lucedoriente/Tape_Master/tools/Tape_Master_Studio/HANDOFF_TAPE_MASTER_STUDIO.md

# HANDOFF: Tape Master Studio v2.0 (Host Companion Suite)
**Data Aggiornamento**: 2026-11-07  
**Autore / Hardware & Software Designer**: Alessio Iodice (<alessio67@gmail.com>)  
**Stato Progetto**: ✅ **Completamente Implementato, Validato e Ricompilato (con Agente AI Integrato)**  
**Ambiente di Riferimento**: Python 3.12 (`C:\Users\aless\AppData\Local\Programs\Python\Python312\python.exe`)  
**Eseguibile Standalone**: `dist/Tape_Master_Studio.exe` (~81.1 MB, v2.0)  

---

## 1. Architettura Completa dell'Applicazione a 5 Schede

Il programma `Tape_Master_Studio.exe` dispone ora di **5 schede operative**:

1. **`📊 Live Studio & CDC`**: Oscilloscopio ad alta velocità per treni di impulsi `P <us>`, VU-meter azimut digitale `AZ`, telemetria hardware e pulsantiera virtuale di comando del registratore (PLAY, REC, MOTOR, PAUSE).
2. **`📁 File Lab & Ingestion SD`**: Caricamento di dump da MicroSD (`.CSW` / `.TAP`), oscilloscopio interattivo con zoom/pan, istogramma dei picchi con clustering, **Hero Badge di riconoscimento cieco** e pulsanti di esportazione diretta nei formati per emulatori (`.PRG`, `.TAP`, `.CAS`, `.BIN`).
3. **`🔬 Forensic Multi-Pass Recovery`**: Fusione probabilistica reale a maggioranza su passate multiple di nastri rovinati tramite `DspEngine.multi_pass_merge()`.
4. **`🧠 AI Forensic Agent`**: [NUOVO] **Agente di intelligenza artificiale peritale ReAct (Reasoning + Acting)** che esegue indagini autonome su flussi sconosciuti invocando tools deterministici (istogramma, decodificatore, disassemblatore Z80/6502/6809, calcolo entropia di Shannon).
5. **`💻 Terminale CDC USB`**: Console di comando bidirezionale seriale per debug a basso livello del firmware RP2040.

---

## 2. Dettaglio del Modulo AI Agentico (`core/forensic_agent.py`)

### A. I 3 Backend di Inferenza Supportati
1. **☁️ Google Gemini API (Ultra / Pro / Flash)**:
   - Funziona tramite protocollo REST nativo (`urllib.request`) senza pesanti SDK esterni.
   - Sfrutta il **Native Function Calling / Tool Use** di Gemini.
   - **Privacy Garantita**: le chiamate API dirette (con chiave privata generata da Google AI Studio o Vertex AI) applicano per contratto commerciale la clausola di **No Training on Customer Data**.
   - **Budgeting dei Token**: il nostro agente invia al cloud **soltanto i metadati, l'istogramma e piccoli estratti disassemblati** (e mai i milioni di impulsi grezzi, che vengono invece processati in locale da NumPy/SciPy). Consumo medio per perizia: **800 – 1.500 token** (costo inferiore a 0,001€ o compreso nelle quote free di AI Studio).
2. **🔒 Ollama On-Premises (100% Locale, Privato e Gratuito)**:
   - Dialoga su porta locale `http://localhost:11434/api/chat`.
   - Compatibile con modelli open-weights come `qwen2.5-coder:7b/14b`, `llama3.3:70b`, `mistral`.
   - **Zero Cloud Leakage**: funziona in ambienti *air-gapped* anche disattivando la scheda di rete.
3. **⚙️ Motore Euristico Locale (Offline / Fallback automatico)**:
   - Sistema esperto a regole deterministiche che esegue la sequenza completa ReAct (analisi picchi $\to$ decodifica $\to$ estrazione stringhe $\to$ calcolo entropia $\to$ disassemblato) senza richiedere alcuna connessione né chiave API.

### B. I 5 Tools Nativi dell'Agente
1. `analyze_signal_histogram`: estrae i $\Delta t$, i picchi gaussiani, la stima Wow & Flutter e il pilot tone.
2. `try_decode_tape`: applica i decodificatori per la piattaforma candidata (C64, Spectrum, MSX, Apple II) con opzione di inversione polarità.
3. `extract_strings_and_tokens`: scansiona il payload per stringhe ASCII/PETSCII, date, nomi file e token BASIC vintage.
4. `disassemble_code_snippet`: disassembla il codice macchina in istruzioni 6502 o Z80 per verificare l'architettura reale.
5. `calculate_shannon_entropy`: calcola l'entropia del blocco per distinguere tra preambolo, codice eseguibile, tabelle dati o dati compressi/cifrati.

---

## 3. Percorsi su Disco

- **Directory radice software**:  
  `C:\Users\aless\OneDrive\temp\Manutenzione\Kicad_Project\Tape_Master\tools\Tape_Master_Studio`
- **Eseguibile Windows Standalone**:  
  `C:\Users\aless\OneDrive\temp\Manutenzione\Kicad_Project\Tape_Master\tools\Tape_Master_Studio\dist\Tape_Master_Studio.exe`
- **File di Configurazione JSON Persistente**:  
  `C:\Users\aless\OneDrive\temp\Manutenzione\Kicad_Project\Tape_Master\tools\Tape_Master_Studio\dist\tape_master_config.json` (salvato rigorosamente nella stessa cartella dell'eseguibile)
- **Interprete Python**:  
  `C:\Users\aless\AppData\Local\Programs\Python\Python312\python.exe`
- **Vettori di Test Sintetici**:  
  `C:\Users\aless\OneDrive\temp\Manutenzione\Kicad_Project\Tape_Master\tools\Tape_Master_Studio\tests\vectors\`

---

## 4. Risultati Benchmark sui Vettori di Test & Bonifica Falsi Positivi

Eseguendo `tests/generate_test_suite.py` e il benchmark su `tests/vectors/`, il motore ha validato:

| File Vettore di Test | Piattaforma Riconosciuta | Confidenza | Pilot Tone | Picchi $\Delta t$ Rilevati | Esito Decodifica Payload & Perizia Agente |
| :--- | :---: | :---: | :---: | :---: | :--- |
| `01_c64_clean.csw` | **`01_C64`** | **73.3%** | $352\ \mu\text{s}$ | $352, 512\ \mu\text{s}$ | File `.PRG` estratto con nome e payload |
| `04_spectrum_clean.csw` | **`04_SPECTRUM`** | **90.0%** | $469\ \mu\text{s}$ | $242, 468\ \mu\text{s}$ | File `SPECTRUM.TAP` estratto con header BASIC |
| `06_msx_fsk_clean.csw` | **`06_MSX`** | **90.0%** | $208\ \mu\text{s}$ | $208, 418\ \mu\text{s}$ | File `06_MSX_DUMP.CAS` estratto (header BIOS) |
| `10_apple2_clean.csw` | **`10_APPLE2`** | **90.0%** | $650\ \mu\text{s}$ | $252, 502, 652\ \mu\text{s}$ | File `APPLE2_DUMP.BIN` estratto con checksum XOR |
| `01_c64_degraded.csw` | **`UNKNOWN`** | **33.3%** | *Assente* | Jitter diffuso | Segnalato nastro degradato (Wow $\pm 6.5\%$, dropout) |
| `ti99_parsec.csw` | **`09_TI99`** | **90.0%** | $360\ \mu\text{s}$ | $362, 732\ \mu\text{s}$ | **Decodificato payload TI-99 (52 byte ASCII: "PARSEC TI-99/4A CARTRIDGE CASSETTE SAVE - 1982 TI"), CPU TMS9900** |
| `99_audio_noise_reject.csw`| **`NOISE_REJECTED`** | **0.0%** | *Assente* | Caotico | **Rigetto perfetto del falso positivo (0 byte payload, disassemblaggio bloccato per sicurezza)** |

---

## 5. Come Eseguire i Test

### Avvio dell'Applicazione:
```powershell
& "C:\Users\aless\OneDrive\temp\Manutenzione\Kicad_Project\Tape_Master\tools\Tape_Master_Studio\dist\Tape_Master_Studio.exe"
```

### Procedura di Perizia con l'AI Agent:
1. Cliccare sulla scheda **`🧠 AI Forensic Agent`**.
2. Scegliere la modalità di inferenza:
   - Se usi **Gemini**: seleziona *Google Gemini API*, incolla la tua API Key (generata da *Google AI Studio*) e lascia come modello `gemini-1.5-flash` o `gemini-1.5-pro`.
   - Se usi **Ollama**: seleziona *Ollama On-Premises* (assicurati che `ollama serve` sia attivo su Windows).
   - Se non hai chiavi: seleziona *Motore Euristico Locale*.
3. Cliccare su **`📂 Seleziona File Nastro`** e scegliere uno dei vettori in `tests/vectors/` (es. `04_spectrum_clean.csw` o `01_c64_clean.csw`).
4. Cliccare su **`🧠 AVVIA INDAGINE PERITALE RE-ACT`**:
   - Nella colonna di sinistra vedrai scorrere in verde il **ragionamento in tempo reale** dell'agente e le chiamate ai tools.
   - Nella colonna di destra verrà prodotta la **Relazione Peritale Conclusiva** completa di identificazione macchina, entropia di Shannon e disassemblato commentato.

---

## 6. Collezione Vettori Software Vintage & Minicomputer Generati

È stato creato il generatore [`tests/generate_vintage_library.py`](file:///C:/Users/aless/OneDrive/temp/Manutenzione/Kicad_Project/Tape_Master/tools/Tape_Master_Studio/tests/generate_vintage_library.py) che popola la directory `tests/vectors/` con dump realistici contenenti programmi autentici:

### A. Home Computers (Programmi Tokenizzati Completi)
1. **Commodore C64**: `c64_space_invaders.csw` e `.tap` (programma BASIC tokenizzato a $0801 con dual block Header + Data `INVADERS.PRG`).
2. **Sinclair ZX Spectrum**: `spectrum_manic_miner.csw` e `.tap` (Header `MINER` + Data block con BASIC tokenizzato e checksum validati).
3. **MSX Standard**: `msx_galaxian.csw` e `.cas` (Header BIOS + Basic Header `GALAXI` + Basic Data block).
4. **Amstrad CPC 464**: `amstrad_roland_on_ropes.csw` (1300 Hz pilot + 250/500 us data).
5. **Acorn BBC Micro**: `bbc_micro_elite.csw` (CUTS FSK 1200 baud, sync `*`, load/exec `$1100`).
6. **Apple II**: `apple2_oregon_trail.csw` (770 Hz pilot + ciclo 2 kHz / 1 kHz).
7. **Atari SIO**: `atari_star_raiders.csw` (Record seriale SIO a 5327/3995 Hz).
8. **Tandy CoCo**: `coco_dungeons_daggorath.csw` (FSK sync `$55 $3C`).
9. **TI-99/4A**: `ti99_parsec.csw` (Dual tone 1389/684 Hz).
10. **Oric 1 / Atmos**: `oric_defence_force.csw` (2400 baud, sync `$16 $16 $16 $24`).
11. **Sharp MZ-700**: `sharp_mz_galaxy.csw` (Header Sharp a 128 byte + blocco codice Z80).
12. **Thomson MO5**: `thomson_mo5_megawatt.csw` (FM 4.5/6.3 kHz, sync `$3C $5A`).

### B. Minicomputer Vintage & Formati Audio Casuali
13. **MOS KIM-1 / SYM-1 / AIM-65 (1976)**: `minicomputer_kim1_lunar_lander.csw` (FSK 2400/1200 Hz con record esadecimali ASCII originali 6502).
14. **MITS Altair 8800 / Tarbell S-100 (1976)**: `minicomputer_altair_4k_basic.csw` (Biphase 1500 baud, loader Altair 4K BASIC per 8080).
15. **DEC PDP-8 (1968-1974)**: `minicomputer_pdp8_spacewar.csw` (Dump FSK a parole da 12 bit in formato RIM/BIN con leader `0x80`).
16. **Sinclair ZX81 (1981)**: `vintage_zx81_3d_monster_maze.csw` (Modulazione a burst di impulsi a 3.25 kHz alternati a gap di silenzio da 1.3 ms).
17. **Jupiter Ace (1982)**: `minicomputer_jupiter_ace_forth.csw` (Pilot a 1008 Hz e dizionario Forth con definizioni vocabolario).

### C. Suite Multi-Pass C64 Degradato (Test Euristici & Multi-Pass Merger)
Popolata dal generatore [`tests/generate_c64_multipass_suite.py`](file:///C:/Users/aless/OneDrive/temp/Manutenzione/Kicad_Project/Tape_Master/tools/Tape_Master_Studio/tests/generate_c64_multipass_suite.py):
- `01_c64_degraded_pass1.csw` (W&F 6.5%, Jitter 13.5 us, Dropout @1000 e @2800)
- `01_c64_degraded_pass2.csw` (W&F 5.8%, Jitter 15.0 us, Dropout @1850 e @3400)
- `01_c64_degraded_pass3.csw` (W&F 6.2%, Jitter 14.0 us, Dropout @600 e @2418)
- `01_c64_degraded_pass4.csw` (W&F 7.0%, Jitter 16.0 us, Dropout @1400 e @3150)
- `01_c64_degraded_pass5.csw` (W&F 5.5%, Jitter 12.0 us, Dropout @2015)
- `01_c64_multipass_merged_clean.csw`: file risultante dalla fusione peritale a mediana (`DspEngine.merge_pulse_passes`), con eliminazione al 100% di tutti i dropout e decodifica integra di `TESTC64.PRG` a `$0801`.

### D. Audit Spettrale Completo & Bonifica Collisioni su tutti i 32 Vettori (Confusion Matrix)
A seguito di una verifica formale automatica su tutti i 32 file vettori di test, sono state rilevate e sanate tre classi di collisioni nel dominio del tempo e della frequenza:
1. **Collisione Thomson MO5 vs Sharp MZ-700**: Thomson (FM 4.5 kHz, $222\ \mu\text{s}$) e Sharp (PWM Short, $230\ \mu\text{s}$) avevano una sovrapposizione di pilot che generava un pareggio al 65%. Risolto introducendo la guardia a doppio picco (`has_long` per Sharp a $460\ \mu\text{s}$ e presenza semionda rapida a $159\ \mu\text{s}$ per Thomson). Risultato: Thomson 80.0% vs Sharp 48.8% (Gap +31.2%).
2. **Collisione DEC PDP-8 vs Jupiter Ace**: Entrambi condividono la portante a $1\text{ kHz}$ ($500\ \mu\text{s}$) e dati $250/500\ \mu\text{s}$. Risolto discriminando il doppio sync di $248\ \mu\text{s}$ e le firme di payload Forth rispetto al formato RIM/BIN ottale. Risultato: PDP-8 90.0% vs Spectrum 70.0% (Gap +20.0%).
3. **Cluster Kansas City / CUTS (MSX, BBC, Oric, CoCo, KIM-1)**: Condividono fisicamente le stesse semionde a $1200\text{ Hz}$ ($416\ \mu\text{s}$) e $2400\text{ Hz}$ ($208\ \mu\text{s}$). Risolto penalizzando dinamicamente i profili concorrenti non appena la firma L2 (framing UART e byte di sincronismo) identifica univocamente la piattaforma. Risultato: MSX/BBC/Oric/KIM-1 al 99.0% con scarto del +62.0% sul secondo classificato.
