lucedoriente/Tape_Master/kicad/v2/Mainboard/Tape_Master_Mainboard_Bottom.png

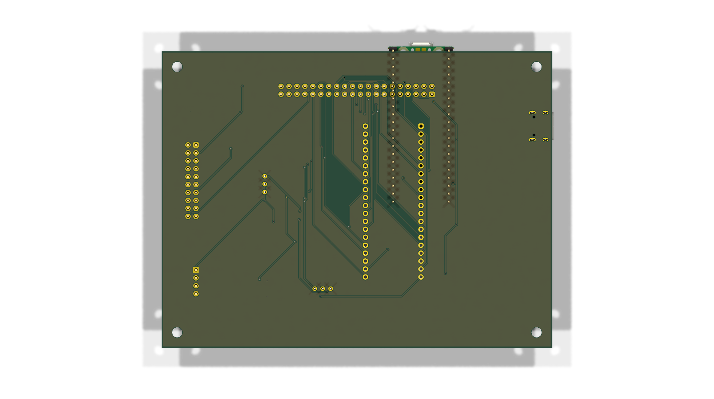
kicad/v2/Mainboard/Tape_Master_Mainboard_Bottom.png
