lucedoriente/Tape_Master/kicad/v2/Mainboard/Tape_Master_Mainboard_Top.png

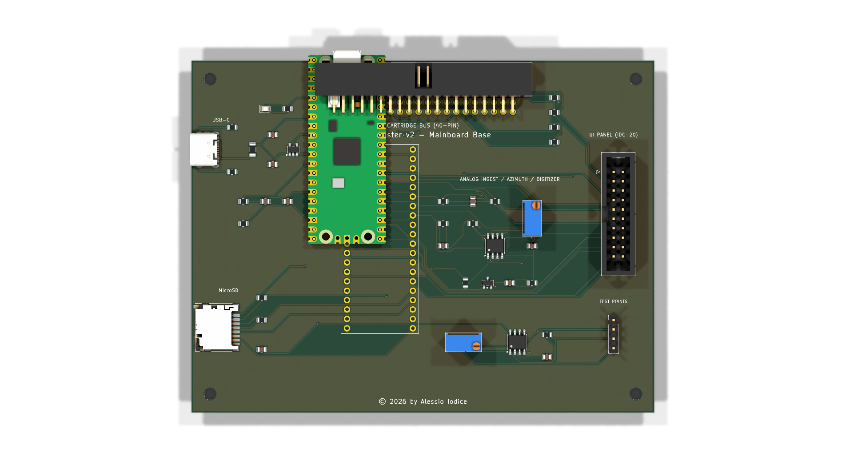
kicad/v2/Mainboard/Tape_Master_Mainboard_Top.png
