lucedoriente/Tape_Master/kicad/v2/UI_Panel/Tape_Master_UI_Panel_Bottom.png

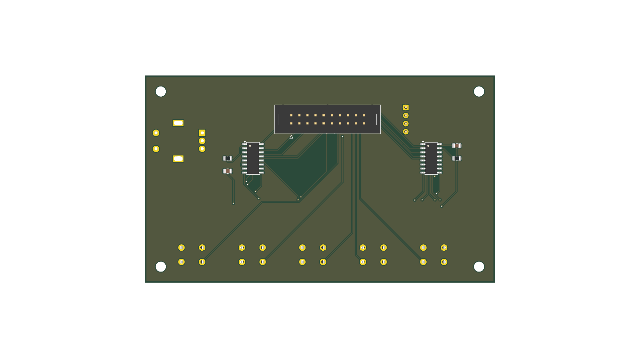
kicad/v2/UI_Panel/Tape_Master_UI_Panel_Bottom.png
