lucedoriente/Tape_Master/kicad/v2/UI_Panel/Tape_Master_UI_Panel_Top.png

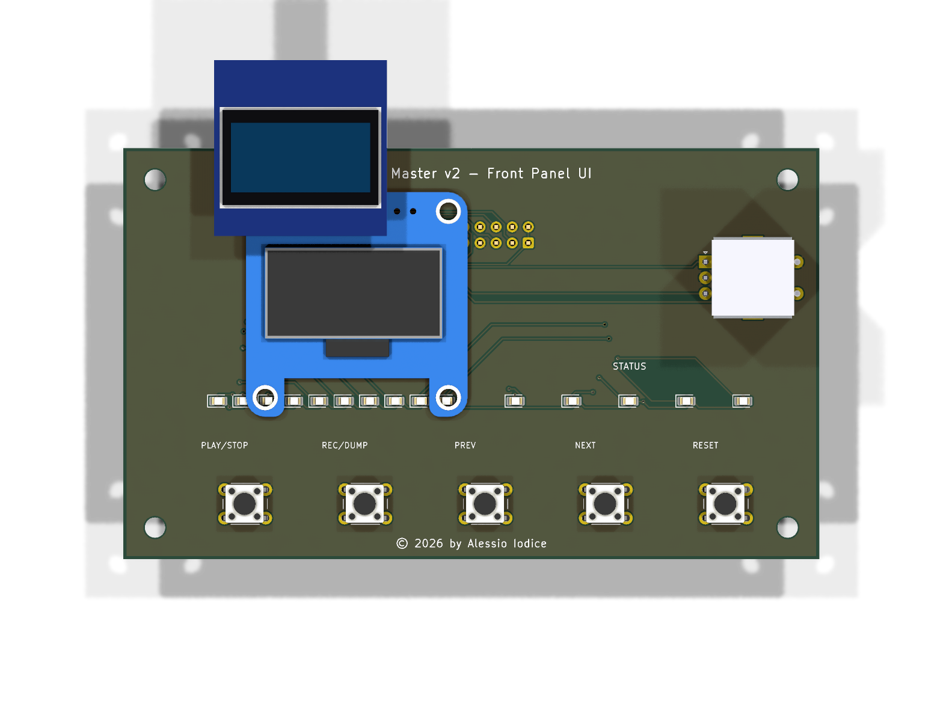
kicad/v2/UI_Panel/Tape_Master_UI_Panel_Top.png
