lucedoriente/Tape_Master/kicad/v1/bom.csv

Refs | Value | Footprint | Qty | DNP
C1 | 100uF_Polymer | Capacitor_Tantalum_SMD:CP_EIA-3528-21_Kemet-B | 1
C2 | 10uF | Capacitor_SMD:C_0805_2012Metric | 1
C3 | 100nF | Capacitor_SMD:C_0805_2012Metric | 1
C4 | 1uF | Capacitor_SMD:C_0805_2012Metric | 1
C5 | 2.2uF | Capacitor_SMD:C_0805_2012Metric | 1
C6 | 100nF | Capacitor_SMD:C_0805_2012Metric | 1
C7 | 47uF | Capacitor_Tantalum_SMD:CP_EIA-3528-21_Kemet-B | 1
C8 | 100nF | Capacitor_SMD:C_0805_2012Metric | 1
C9 | 10uF | Capacitor_SMD:C_0805_2012Metric | 1
C10 | 100nF | Capacitor_SMD:C_0805_2012Metric | 1
C11 | 100nF | Capacitor_SMD:C_0805_2012Metric | 1
C12 | 100nF | Capacitor_SMD:C_0805_2012Metric | 1
C13 | 100nF | Capacitor_SMD:C_0805_2012Metric | 1
C15 | 1uF | Capacitor_SMD:C_0805_2012Metric | 1
C16 | 47pF | Capacitor_SMD:C_0805_2012Metric | 1
C17 | 47nF | Capacitor_SMD:C_0805_2012Metric | 1
C18 | 47nF | Capacitor_SMD:C_0805_2012Metric | 1
C19 | 1.5nF | Capacitor_SMD:C_0805_2012Metric | 1
C20 | 680pF | Capacitor_SMD:C_0805_2012Metric | 1
C21 | 1uF | Capacitor_SMD:C_0805_2012Metric | 1
C22 | 100nF | Capacitor_SMD:C_0805_2012Metric | 1
C23 | 100nF | Capacitor_SMD:C_0805_2012Metric | 1
C24 | 100nF | Capacitor_SMD:C_0805_2012Metric | 1
C25 | 100nF | Capacitor_SMD:C_0805_2012Metric | 1
C26 | 100nF | Capacitor_SMD:C_0805_2012Metric | 1
C27 | 100nF | Capacitor_SMD:C_0805_2012Metric | 1
C28 | 10nF | Capacitor_SMD:C_0805_2012Metric | 1
C29 | 10nF | Capacitor_SMD:C_0805_2012Metric | 1
C30 | 10uF | Capacitor_SMD:C_0805_2012Metric | 1
C31 | 100nF | Capacitor_SMD:C_0805_2012Metric | 1
C32 | 100nF | Capacitor_SMD:C_0805_2012Metric | 1
D1 | PMEG3010AET | Package_TO_SOT_SMD:SOT-23 | 1
D2 | LED_READ_Green | LED_SMD:LED_0805_2012Metric | 1
D3 | LED_WRITE_Red | LED_SMD:LED_0805_2012Metric | 1
D4 | LED_MOTOR_Yellow | LED_SMD:LED_0805_2012Metric | 1
D5 | LED_SIGNAL_Blue | LED_SMD:LED_0805_2012Metric | 1
D6 | PWR 3.3V | LED_SMD:LED_0805_2012Metric | 1
D7 | BAT54S | Package_TO_SOT_SMD:SOT-23 | 1
D8 | BAT54 | Package_TO_SOT_SMD:SOT-23 | 1
D9 | BAT54 | Package_TO_SOT_SMD:SOT-23 | 1
D10 | VU_Green | LED_SMD:LED_0805_2012Metric | 1
D11 | VU_Green | LED_SMD:LED_0805_2012Metric | 1
D12 | VU_Green | LED_SMD:LED_0805_2012Metric | 1
D13 | VU_Green | LED_SMD:LED_0805_2012Metric | 1
D14 | VU_Green | LED_SMD:LED_0805_2012Metric | 1
D15 | VU_Green | LED_SMD:LED_0805_2012Metric | 1
D16 | VU_Green | LED_SMD:LED_0805_2012Metric | 1
D17 | VU_Green | LED_SMD:LED_0805_2012Metric | 1
D18 | VU_Yellow | LED_SMD:LED_0805_2012Metric | 1
D19 | VU_Red | LED_SMD:LED_0805_2012Metric | 1
DISP1 | OLED_0.96_I2C | Connector_PinHeader_2.54mm:PinHeader_1x04_P2.54mm_Vertical | 1
F1 | PTC 1A | Fuse:Fuse_1206_3216Metric | 1
H1 | MountingHole | MountingHole:MountingHole_3.2mm_M3 | 1
H2 | MountingHole | MountingHole:MountingHole_3.2mm_M3 | 1
H3 | MountingHole | MountingHole:MountingHole_3.2mm_M3 | 1
H4 | MountingHole | MountingHole:MountingHole_3.2mm_M3 | 1
J1 | USB-C | Connector_USB:USB_C_Receptacle_GCT_USB4105-xx-A_16P_TopMnt_Horizontal | 1
J2 | MicroSD | Connector_Card:microSD_HC_Hirose_DM3D-SF | 1
J3 | HEAD_IN / LINE_IN | Connector_Audio:Jack_3.5mm_CUI_SJ-3523-SMT_Horizontal | 1
J4 | C2N_EDGE | Tape-Master:C2N_Edge_Connector | 1
J5 | C2N_HEADER | Connector_PinHeader_2.54mm:PinHeader_1x06_P2.54mm_Vertical | 1
J6 | AUDIO_OUT | Connector_Audio:Jack_3.5mm_CUI_SJ-3523-SMT_Horizontal | 1
J7 | REMOTE_2.5mm | Connector_Audio:Jack_3.5mm_CUI_SJ-3523-SMT_Horizontal | 1
JP1 | C2N_PWR_SEL | Connector_PinHeader_2.54mm:PinHeader_1x02_P2.54mm_Vertical | 1
JP2 | HEAD_BOOST | Connector_PinHeader_2.54mm:PinHeader_1x02_P2.54mm_Vertical | 1
Q1 | 2N7002 | Package_TO_SOT_SMD:SOT-23 | 1
Q2 | 2N3904 | Package_TO_SOT_SMD:SOT-23 | 1
R1 | 5.1k | Resistor_SMD:R_0805_2012Metric | 1
R2 | 5.1k | Resistor_SMD:R_0805_2012Metric | 1
R3 | 10k 0.1% | Resistor_SMD:R_0805_2012Metric | 1
R4 | 10k 0.1% | Resistor_SMD:R_0805_2012Metric | 1
R5 | 10k | Resistor_SMD:R_0805_2012Metric | 1
R6 | 10k | Resistor_SMD:R_0805_2012Metric | 1
R7 | 10k | Resistor_SMD:R_0805_2012Metric | 1
R8 | 10k | Resistor_SMD:R_0805_2012Metric | 1
R9 | 4.7k | Resistor_SMD:R_0805_2012Metric | 1
R10 | 4.7k | Resistor_SMD:R_0805_2012Metric | 1
R11 | 10k | Resistor_SMD:R_0805_2012Metric | 1
R12 | 10k | Resistor_SMD:R_0805_2012Metric | 1
R13 | 10k | Resistor_SMD:R_0805_2012Metric | 1
R14 | 10k | Resistor_SMD:R_0805_2012Metric | 1
R15 | 10k | Resistor_SMD:R_0805_2012Metric | 1
R16 | 10k | Resistor_SMD:R_0805_2012Metric | 1
R17 | 10k | Resistor_SMD:R_0805_2012Metric | 1
R18 | 1.2k | Resistor_SMD:R_0805_2012Metric | 1
R20 | 1.2k | Resistor_SMD:R_0805_2012Metric | 1
R23 | 1k | Resistor_SMD:R_0805_2012Metric | 1
R24 | 100k | Resistor_SMD:R_0805_2012Metric | 1
R25 | 1k | Resistor_SMD:R_0805_2012Metric | 1
R26 | 9.1k | Resistor_SMD:R_0805_2012Metric | 1
R27 | 8.2k 1% | Resistor_SMD:R_0805_2012Metric | 1
R28 | 16k 1% | Resistor_SMD:R_0805_2012Metric | 1
R29 | 12k 1% | Resistor_SMD:R_0805_2012Metric | 1
R30 | 12k 1% | Resistor_SMD:R_0805_2012Metric | 1
R31 | 100k | Resistor_SMD:R_0805_2012Metric | 1
R32 | 10k 1% | Resistor_SMD:R_0805_2012Metric | 1
R33 | 18k 1% | Resistor_SMD:R_0805_2012Metric | 1
R34 | 10k | Resistor_SMD:R_0805_2012Metric | 1
R35 | 470k | Resistor_SMD:R_0805_2012Metric | 1
R36 | 2.2k | Resistor_SMD:R_0805_2012Metric | 1
R37 | 1k | Resistor_SMD:R_0805_2012Metric | 1
R38 | 100k | Resistor_SMD:R_0805_2012Metric | 1
R39 | 10k | Resistor_SMD:R_0805_2012Metric | 1
R40 | 10k | Resistor_SMD:R_0805_2012Metric | 1
R41 | 10k | Resistor_SMD:R_0805_2012Metric | 1
R42 | 1k | Resistor_SMD:R_0805_2012Metric | 1
R43 | 2k | Resistor_SMD:R_0805_2012Metric | 1
R44 | 1k | Resistor_SMD:R_0805_2012Metric | 1
R45 | 1k | Resistor_SMD:R_0805_2012Metric | 1
R46 | 10k | Resistor_SMD:R_0805_2012Metric | 1
R47 | 1k | Resistor_SMD:R_0805_2012Metric | 1
R48 | 330 | Resistor_SMD:R_0805_2012Metric | 1
RV1 | 100k TRIM | Potentiometer_THT:Potentiometer_Bourns_3296W_Vertical | 1
RV3 | 50k HYST | Potentiometer_THT:Potentiometer_Bourns_3296W_Vertical | 1
SW1 | Rotary_Encoder | Rotary_Encoder:RotaryEncoder_Alps_EC11E-Switch_Vertical_H20mm | 1
SW2 | BTN_PLAY_STOP | Button_Switch_THT:SW_PUSH_6mm | 1
SW3 | BTN_REC_DUMP | Button_Switch_THT:SW_PUSH_6mm | 1
SW4 | BTN_REW_PREV | Button_Switch_THT:SW_PUSH_6mm | 1
SW5 | BTN_FFWD_NEXT | Button_Switch_THT:SW_PUSH_6mm | 1
SW6 | RESET | Button_Switch_THT:SW_PUSH_6mm | 1
U1 | AP2112K-3.3 | Package_TO_SOT_SMD:SOT-23-5 | 1
U2 | TLV2372 | Package_SO:SOIC-8_3.9x4.9mm_P1.27mm | 1
U3 | RaspberryPi_Pico | Module:RaspberryPi_Pico_Common_THT | 1
U4 | TLV2372 | Package_SO:SOIC-8_3.9x4.9mm_P1.27mm | 1
U5 | TLV2372 | Package_SO:SOIC-8_3.9x4.9mm_P1.27mm | 1
U6 | TLV2372 | Package_SO:SOIC-8_3.9x4.9mm_P1.27mm | 1
U7 | TLC5916 | Package_SO:SOIC-16_3.9x9.9mm_P1.27mm | 1
U8 | LM393 | Package_SO:SOIC-8_3.9x4.9mm_P1.27mm | 1
U9 | 74HCT06 | Package_SO:SOIC-14_3.9x8.7mm_P1.27mm | 1
U10 | PC817 | Package_DIP:DIP-4_W7.62mm | 1
U11 | TLC5916 | Package_SO:SOIC-16_3.9x9.9mm_P1.27mm | 1
