lucedoriente/Tape_Master/kicad/v2/Mainboard/Tape_Master_Mainboard.step

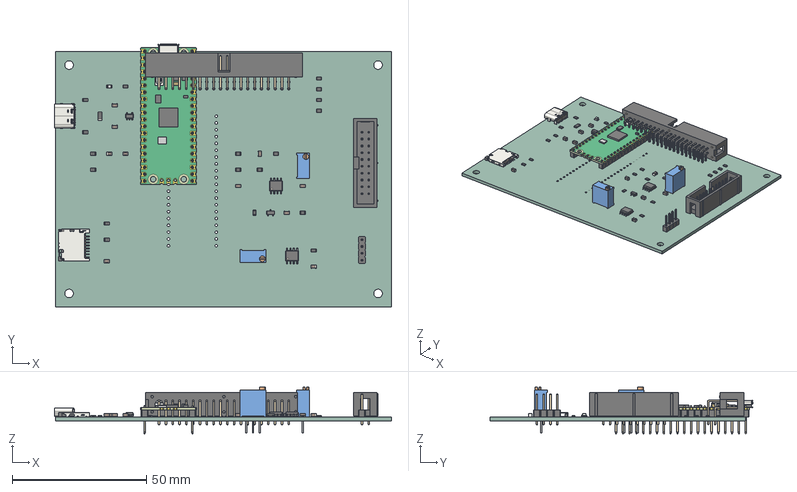
[picture p5: CAD file, 2026-11-06]
kicad/v2/Mainboard/Tape_Master_Mainboard.step
125.4 x 97.8 x 17.4 mm
C_0805_2012Metric x 12
Fuse_1206_3216Metric
R_0805_2012Metric x 19
RaspberryPi_Pico_Module_KiCad
RaspberryPi_Pico_Header_Breakaway_H2.54mm_KiCad x 2
USB_C_Receptacle_GCT_USB4105-xx-A_16P_TopMnt_Horizontal
LED_0805_2012Metric
microSD_HC_Hirose_DM3D-SF
PinHeader_1x04_P2.54mm_Vertical
SOIC-8_3.9x4.9mm_P1.27mm x 2
SOT-23-5
Potentiometer_Bourns_3296W_Vertical x 2
SOT-23
IDC-Header_2x20_P2.54mm_Horizontal
IDC-Header_2x10_P2.54mm_Vertical
Tape_Master_Mainboard_PCB
