lucedoriente/Tape_Master/kicad/v2/Cartridges/01_Commodore_C2N/Tape_Master_Cartridge_C2N.step

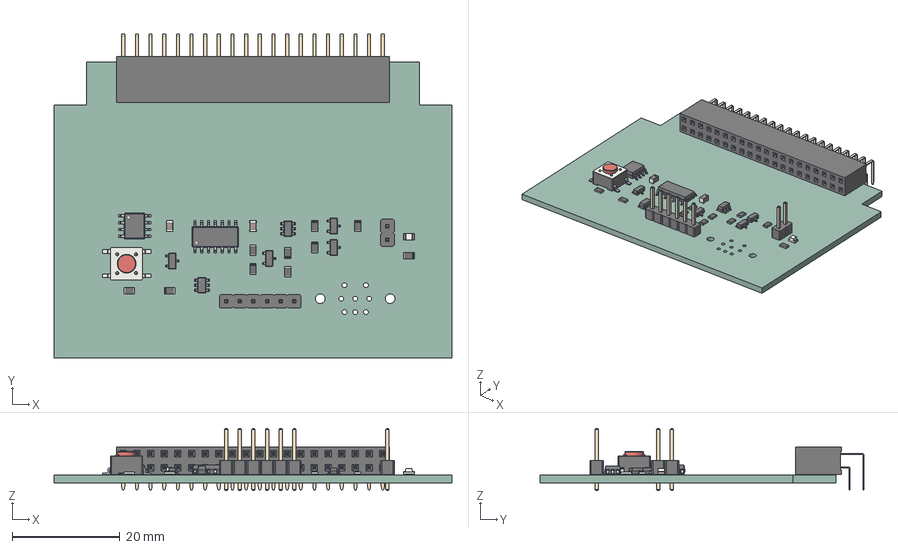
[picture p6: CAD file, 2026-11-07]
kicad/v2/Cartridges/01_Commodore_C2N/Tape_Master_Cartridge_C2N.step
74.0 x 60.2 x 11.5 mm
SW_SPST_PTS645
PinSocket_2x20_P2.54mm_Horizontal
R_0805_2012Metric x 10
C_0805_2012Metric x 2
SOIC-8_3.9x4.9mm_P1.27mm
SOT-23-6 x 2
SOT-23 x 4
PinHeader_1x02_P2.54mm_Vertical
LED_0805_2012Metric
PinHeader_1x06_P2.54mm_Vertical
SOIC-14_3.9x8.7mm_P1.27mm
Tape_Master_Cartridge_C2N_PCB
