lucedoriente/Tape_Master/kicad/v2/Cartridges/02_Atari_SIO/Tape_Master_Cartridge_Atari_SIO.step

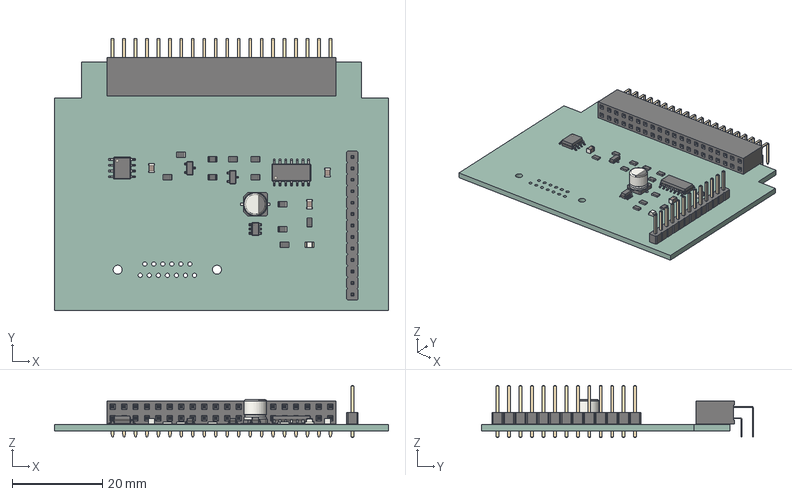
[picture p7: CAD file, 2026-11-07]
kicad/v2/Cartridges/02_Atari_SIO/Tape_Master_Cartridge_Atari_SIO.step
74.0 x 60.2 x 11.5 mm
R_0805_2012Metric x 11
SOT-23-6
CP_Elec_5x5.4
PinSocket_2x20_P2.54mm_Horizontal
SOIC-14_3.9x8.7mm_P1.27mm
C_0805_2012Metric x 3
SOT-23 x 2
SOIC-8_3.9x4.9mm_P1.27mm
PinHeader_1x13_P2.54mm_Vertical
LED_0805_2012Metric
Tape_Master_Cartridge_Atari_SIO_PCB
