lucedoriente/Tape_Master/kicad/v2/Cartridges/04_Sinclair_ZX_Spectrum/Tape_Master_Cartridge_Sinclair_ZX.step

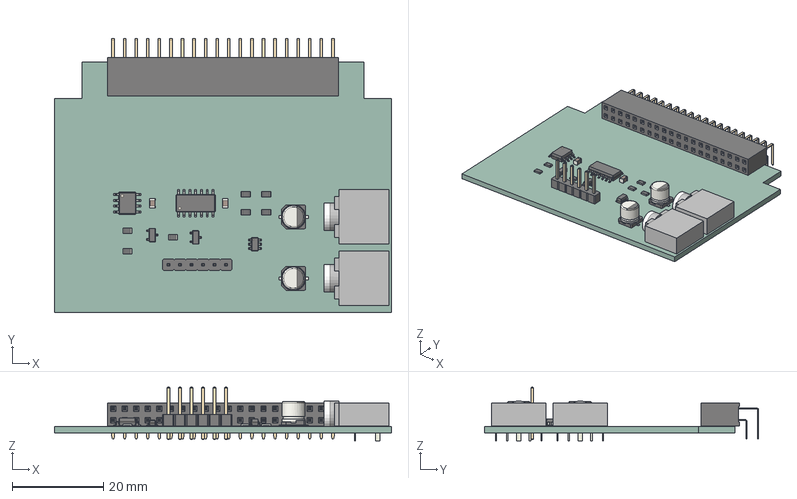
[picture p8: CAD file, 2026-11-07]
kicad/v2/Cartridges/04_Sinclair_ZX_Spectrum/Tape_Master_Cartridge_Sinclair_ZX.step
74.0 x 60.2 x 11.8 mm
PinSocket_2x20_P2.54mm_Horizontal
Jack_3.5mm_CUI_SJ1-3525N_Horizontal x 2
CP_Elec_5x5.4 x 2
R_0805_2012Metric x 7
C_0805_2012Metric x 2
SOIC-8_3.9x4.9mm_P1.27mm
SOT-23-6
SOT-23 x 2
PinHeader_1x06_P2.54mm_Vertical
SOIC-14_3.9x8.7mm_P1.27mm
Tape_Master_Cartridge_Sinclair_ZX_PCB
