lucedoriente/Tape_Master/kicad/v2/Cartridges/09_TI99_4A/Tape_Master_Cartridge_TI99.step

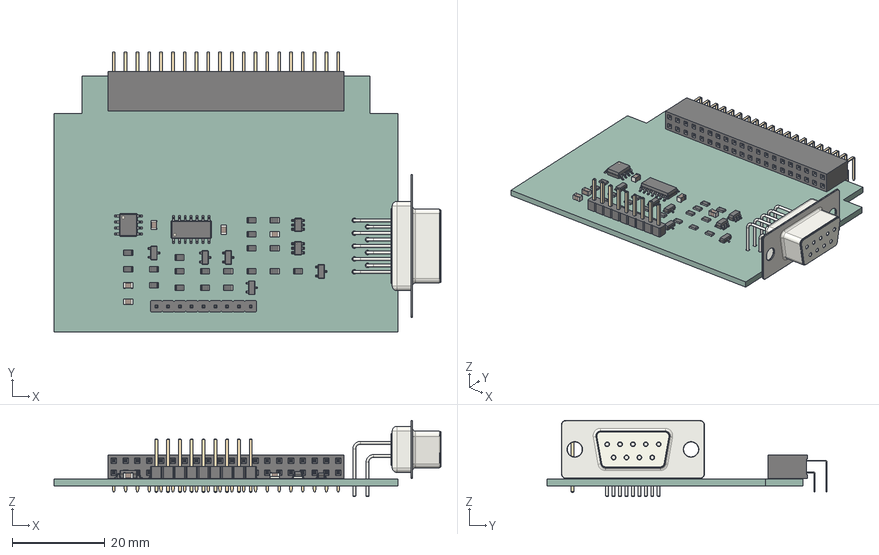
[picture p9: CAD file, 2026-11-07]
kicad/v2/Cartridges/09_TI99_4A/Tape_Master_Cartridge_TI99.step
83.2 x 60.2 x 16.4 mm
R_0805_2012Metric x 19
PinSocket_2x20_P2.54mm_Horizontal
DSUB-9_Socket_Horizontal_P2.77x2.84mm_EdgePinOffset9.40mm
SOT-23 x 5
C_0805_2012Metric x 5
PinHeader_1x09_P2.54mm_Vertical
SOIC-8_3.9x4.9mm_P1.27mm
SOT-23-6 x 2
SOIC-14_3.9x8.7mm_P1.27mm
Tape_Master_Cartridge_TI99_PCB
