lucedoriente/Tape_Master/kicad/v2/Cartridges/10_Apple_II/3dmodels/Jack_3.5mm_CUI_SJ1-3533NG_Horizontal.step

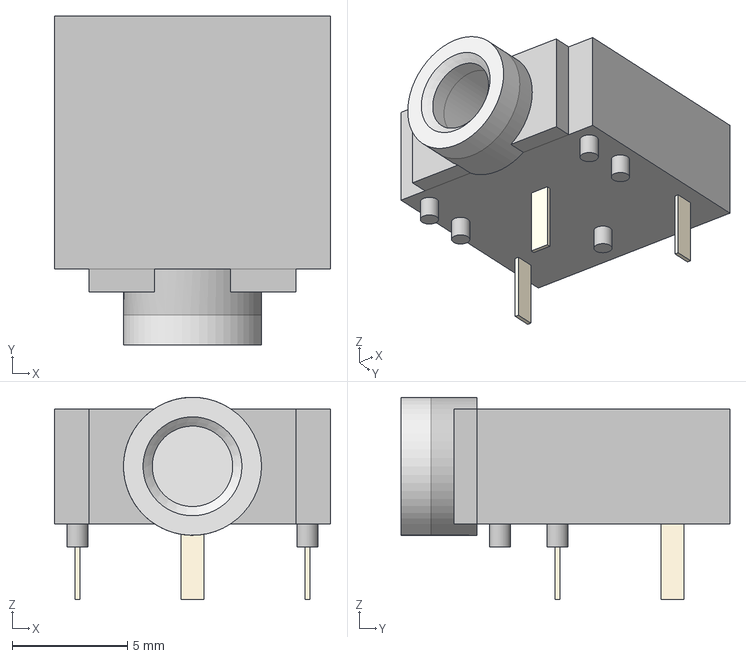
[picture p10: CAD file, 2026-11-07]
kicad/v2/Cartridges/10_Apple_II/3dmodels/Jack_3.5mm_CUI_SJ1-3533NG_Horizontal.step
12.0 x 14.3 x 8.80 mm
