lucedoriente/Tape_Master/kicad/v2/UI_Panel/Tape_Master_UI_Panel.step

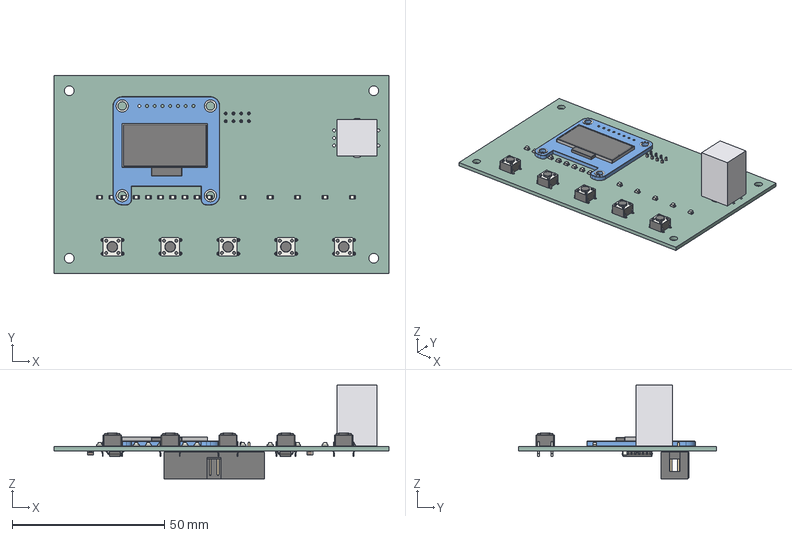
[picture p11: CAD file, 2026-11-06]
kicad/v2/UI_Panel/Tape_Master_UI_Panel.step
110.0 x 65.0 x 30.8 mm
SW_PUSH_6mm x 5
LED_0805_2012Metric x 15
OLED_0.96_I2C
EC11_Encoder
SOIC-16_3.9x9.9mm_P1.27mm x 2
IDC-Header_2x10_P2.54mm_Vertical
C_0805_2012Metric x 2
R_0805_2012Metric x 2
Tape_Master_UI_Panel_PCB
