lucedoriente/Tape_Master/kicad/v2/common/3dmodels/EC11_Encoder.step

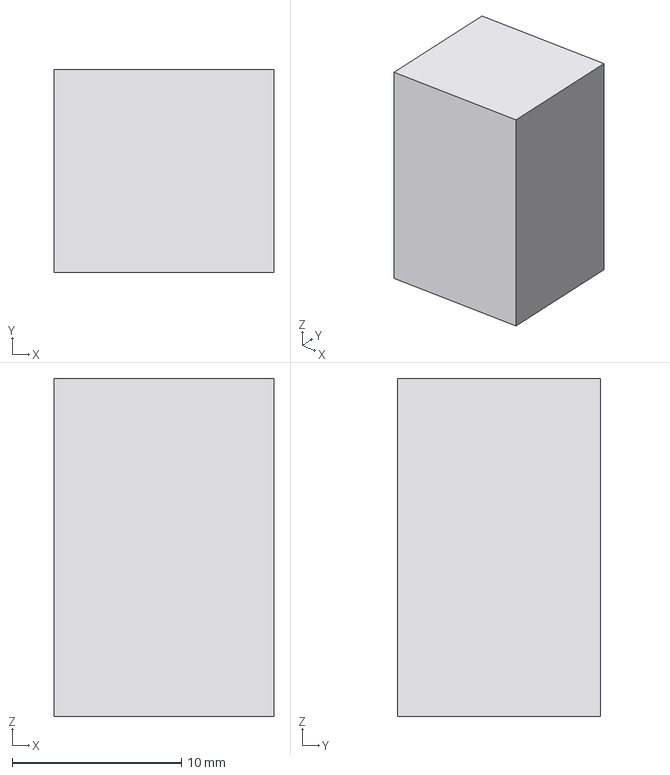
[picture p12: CAD file, 2026-11-06]
kicad/v2/common/3dmodels/EC11_Encoder.step
13.0 x 12.0 x 20.0 mm
