lucedoriente/Tape_Master/kicad/v2/common/3dmodels/C2N_Edge_Connector.step

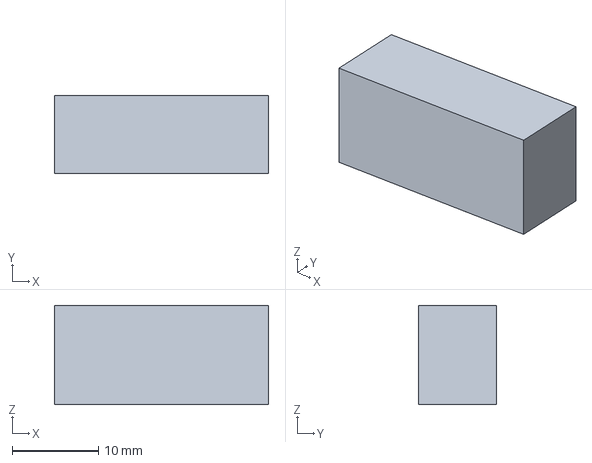
[picture p13: CAD file, 2026-11-06]
kicad/v2/common/3dmodels/C2N_Edge_Connector.step
24.8 x 9.00 x 11.5 mm
