lucedoriente/Tape_Master/kicad/v2/common/3dmodels/OLED_0.96_I2C.step

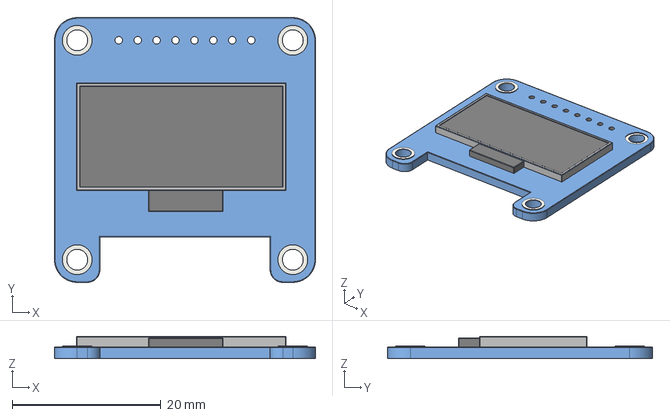
[picture p14: CAD file, 2026-11-06]
kicad/v2/common/3dmodels/OLED_0.96_I2C.step
35.1 x 35.6 x 3.00 mm
