lucedoriente/Tape_Master/(list of files, cad)

Other CAD files:
kicad/v2/Cartridges/02_Atari_SIO/3dmodels/Atari_SIO_13P.step
kicad/v2/Cartridges/03_Thomson_Olivetti_PC128/3dmodels/DIN-5_180_Horizontal_CUI_SDS-50J.step
kicad/v2/Cartridges/03_Thomson_Olivetti_PC128/Tape_Master_Cartridge_Thomson_PC128.step
kicad/v2/Cartridges/05_Amstrad_CPC/Tape_Master_Cartridge_Amstrad_CPC.step
kicad/v2/Cartridges/06_MSX_Standard/Tape_Master_Cartridge_MSX.step
kicad/v2/Cartridges/07_Acorn_BBC_Micro/3dmodels/DIN-7_270_Horizontal_CUI_SDS-70J.step
kicad/v2/Cartridges/07_Acorn_BBC_Micro/Tape_Master_Cartridge_BBC_Micro.step
kicad/v2/Cartridges/08_Tandy_CoCo_Dragon/3dmodels/DIN-5_180_Horizontal_CUI_SDS-50J.step
kicad/v2/Cartridges/08_Tandy_CoCo_Dragon/Tape_Master_Cartridge_CoCo_Dragon.step
kicad/v2/Cartridges/10_Apple_II/Tape_Master_Cartridge_Apple_II.step
kicad/v2/Cartridges/11_Oric_Atmos/3dmodels/DIN-7_270_Horizontal_CUI_SDS-70J.step
kicad/v2/Cartridges/11_Oric_Atmos/Tape_Master_Cartridge_Oric_Atmos.step
kicad/v2/Cartridges/12_Sharp_MZ/Tape_Master_Cartridge_Sharp_MZ.step
kicad/v2/Cartridges/13_Raw_Head_Stereo_Digitizer/Tape_Master_Cartridge_Raw_Head.step
kicad/v2/common/3dmodels/DIN-5_180_Horizontal_CUI_SDS-50J.step
kicad/v2/common/3dmodels/Atari_SIO_13P.step
kicad/v2/common/3dmodels/DIN-8_270_Horizontal_CUI_SDS-80J.step
kicad/v2/common/3dmodels/DIN-7_270_Horizontal_CUI_SDS-70J.step
kicad/v2/common/3dmodels/Mini-DIN-8_MD-80_Horizontal.step
kicad/v1/Tape-Master.step
