lucedoriente/Tape_Master/kicad/v2/Cartridges/05_Amstrad_CPC/Tape_Master_Cartridge_Amstrad_CPC_Schematic.pdf

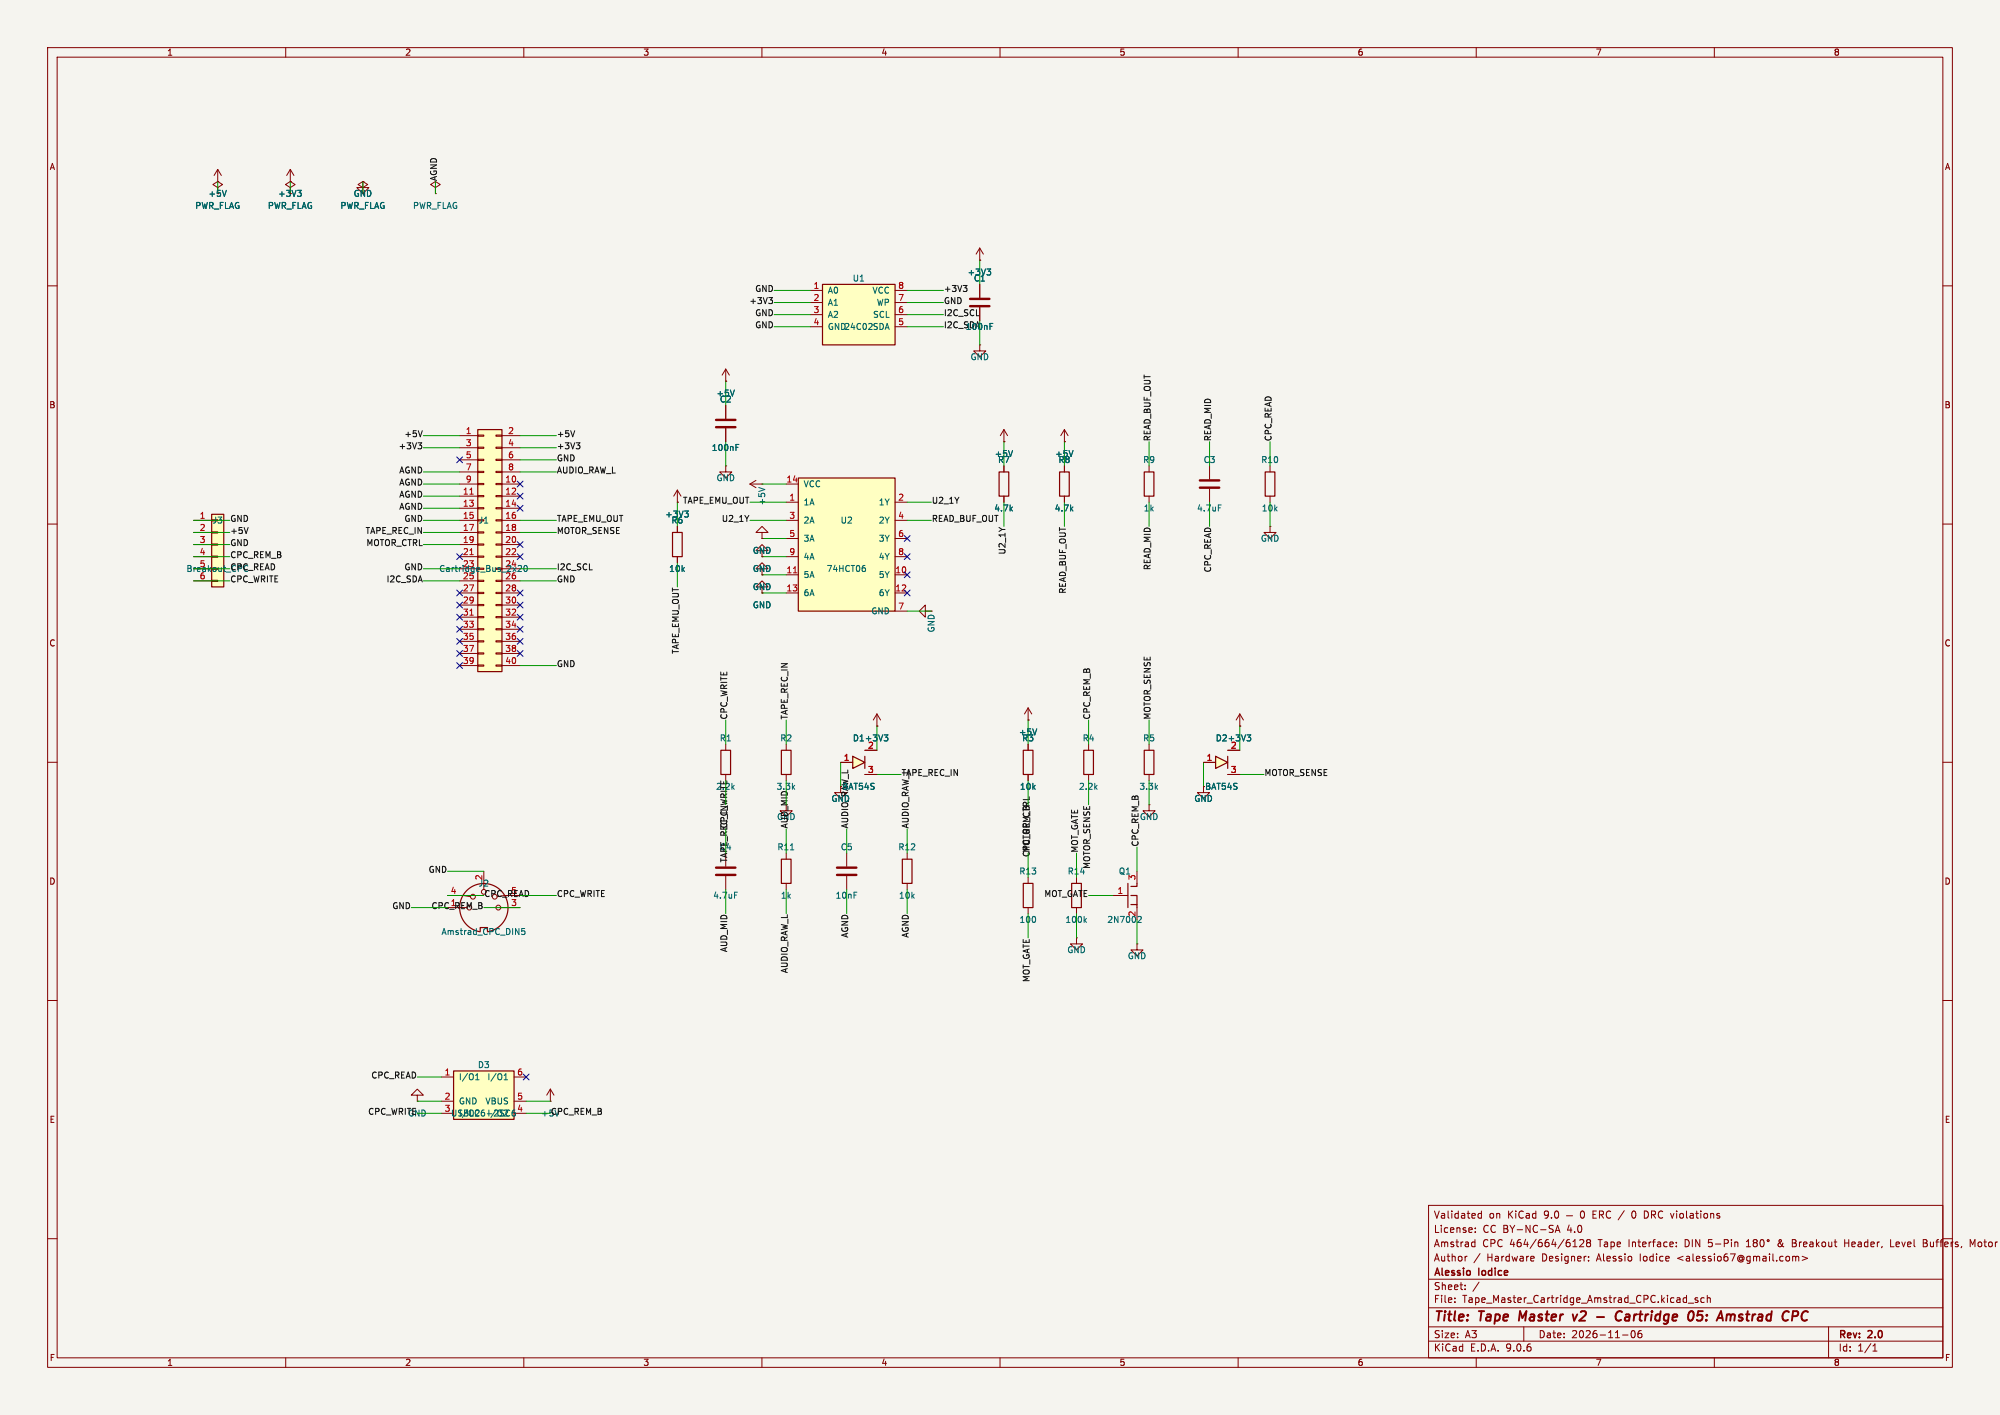
[picture p15: page 1]

3+3V3 GND GND GND GND
GND

Id: 1/1 Title: Tape Master v2 - Cartridge 05: Amstrad CPC
