lucedoriente/Tape_Master/kicad/v2/Cartridges/13_Raw_Head_Stereo_Digitizer/Tape_Master_Cartridge_Raw_Head_Schematic.pdf

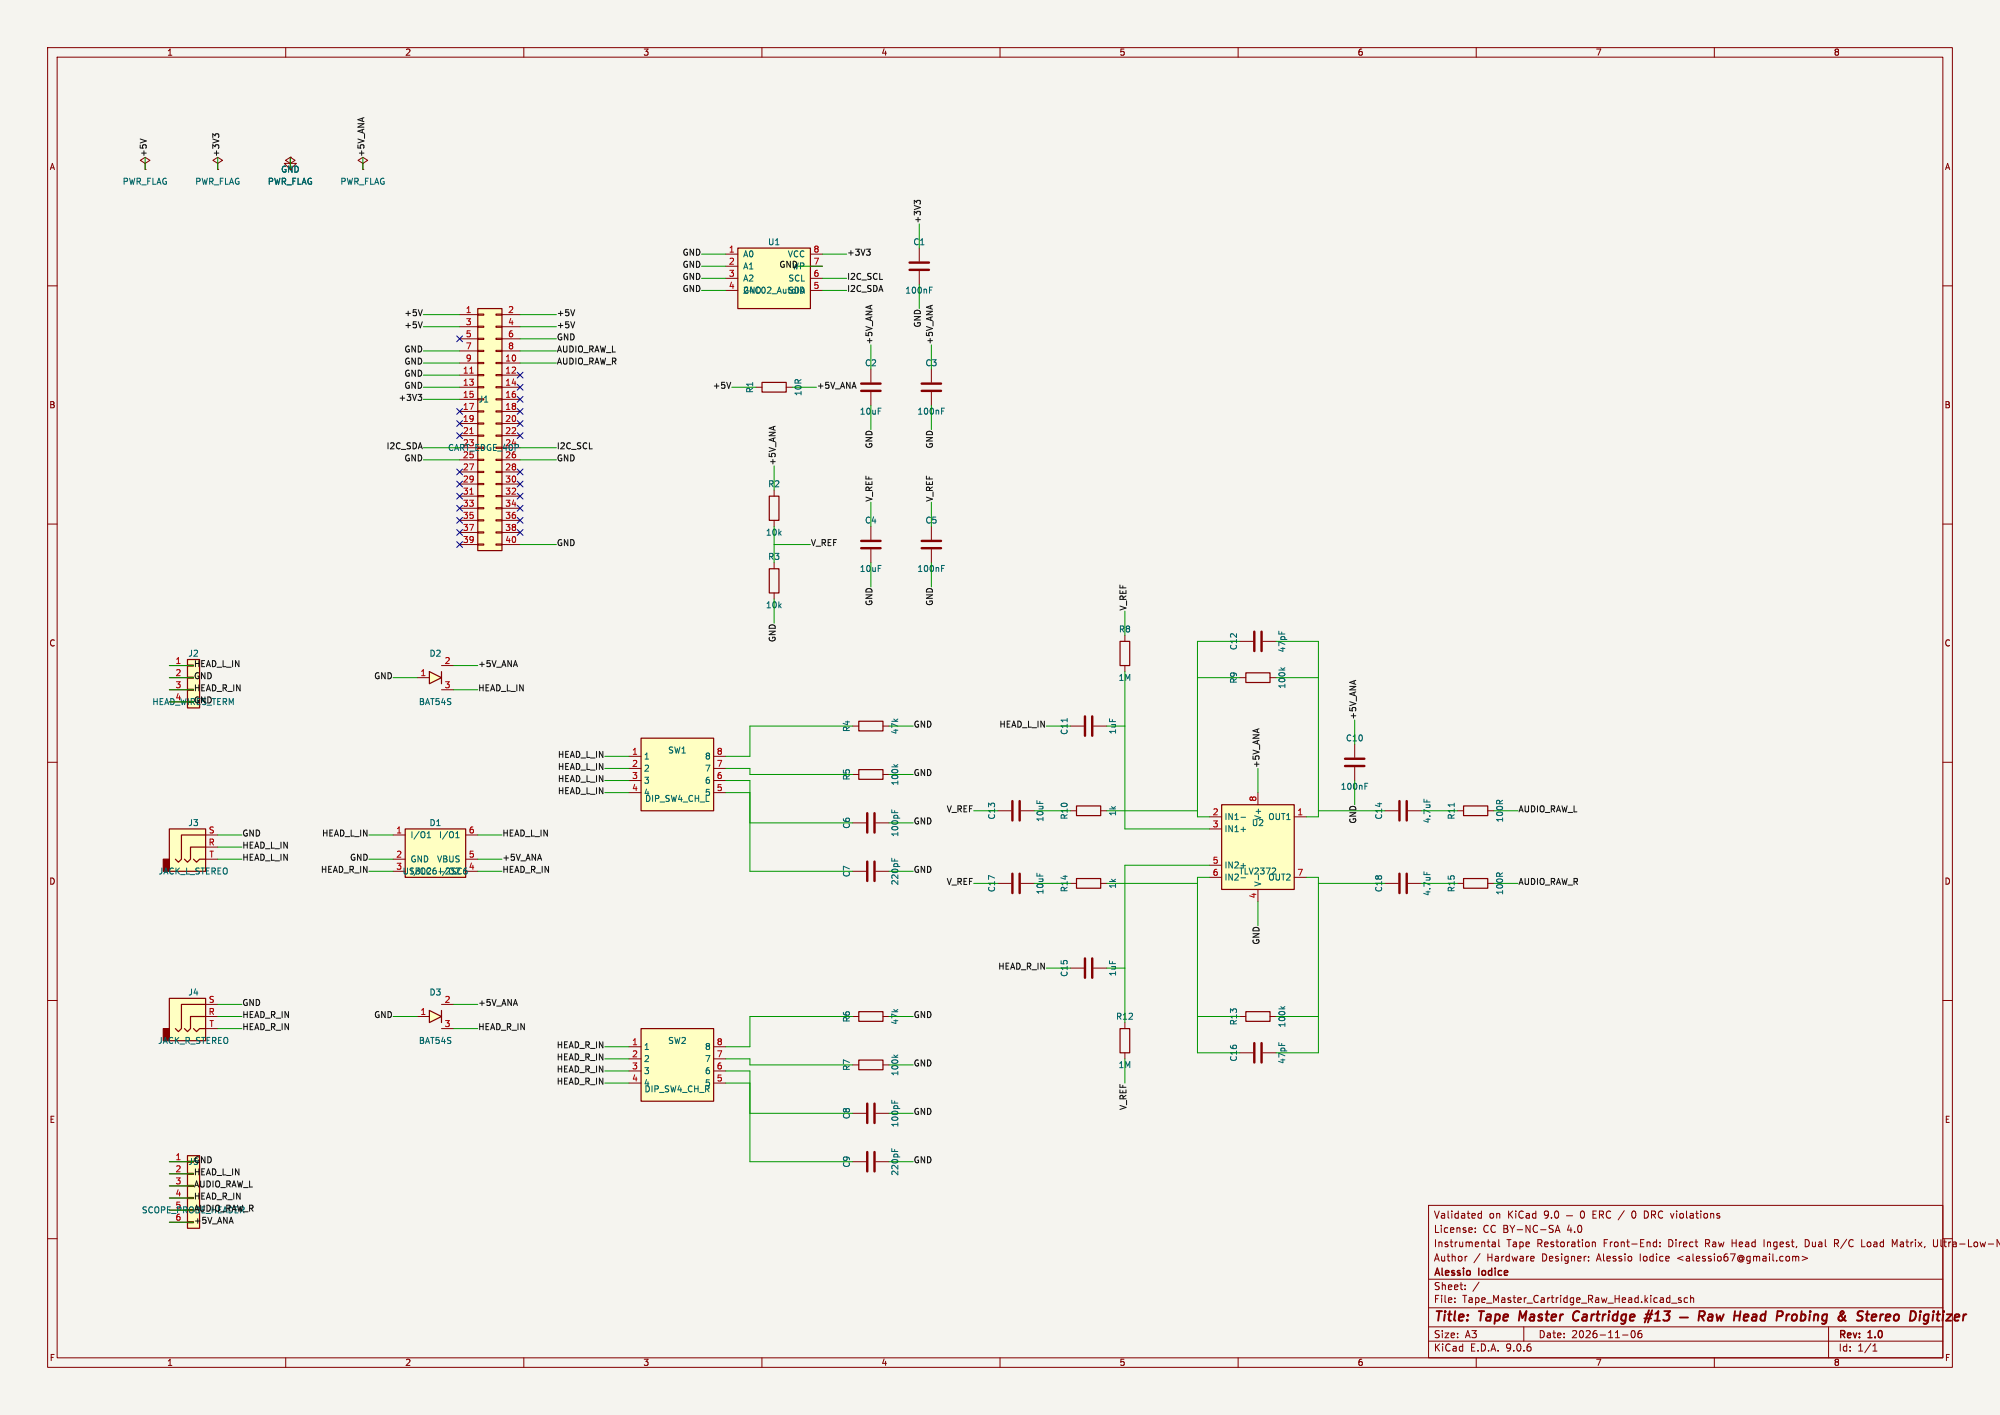
[picture p16: page 1]

GND GND
