lucedoriente/Tape_Master/kicad/v2/Cartridges/01_Commodore_C2N/Tape_Master_Cartridge_C2N.pdf

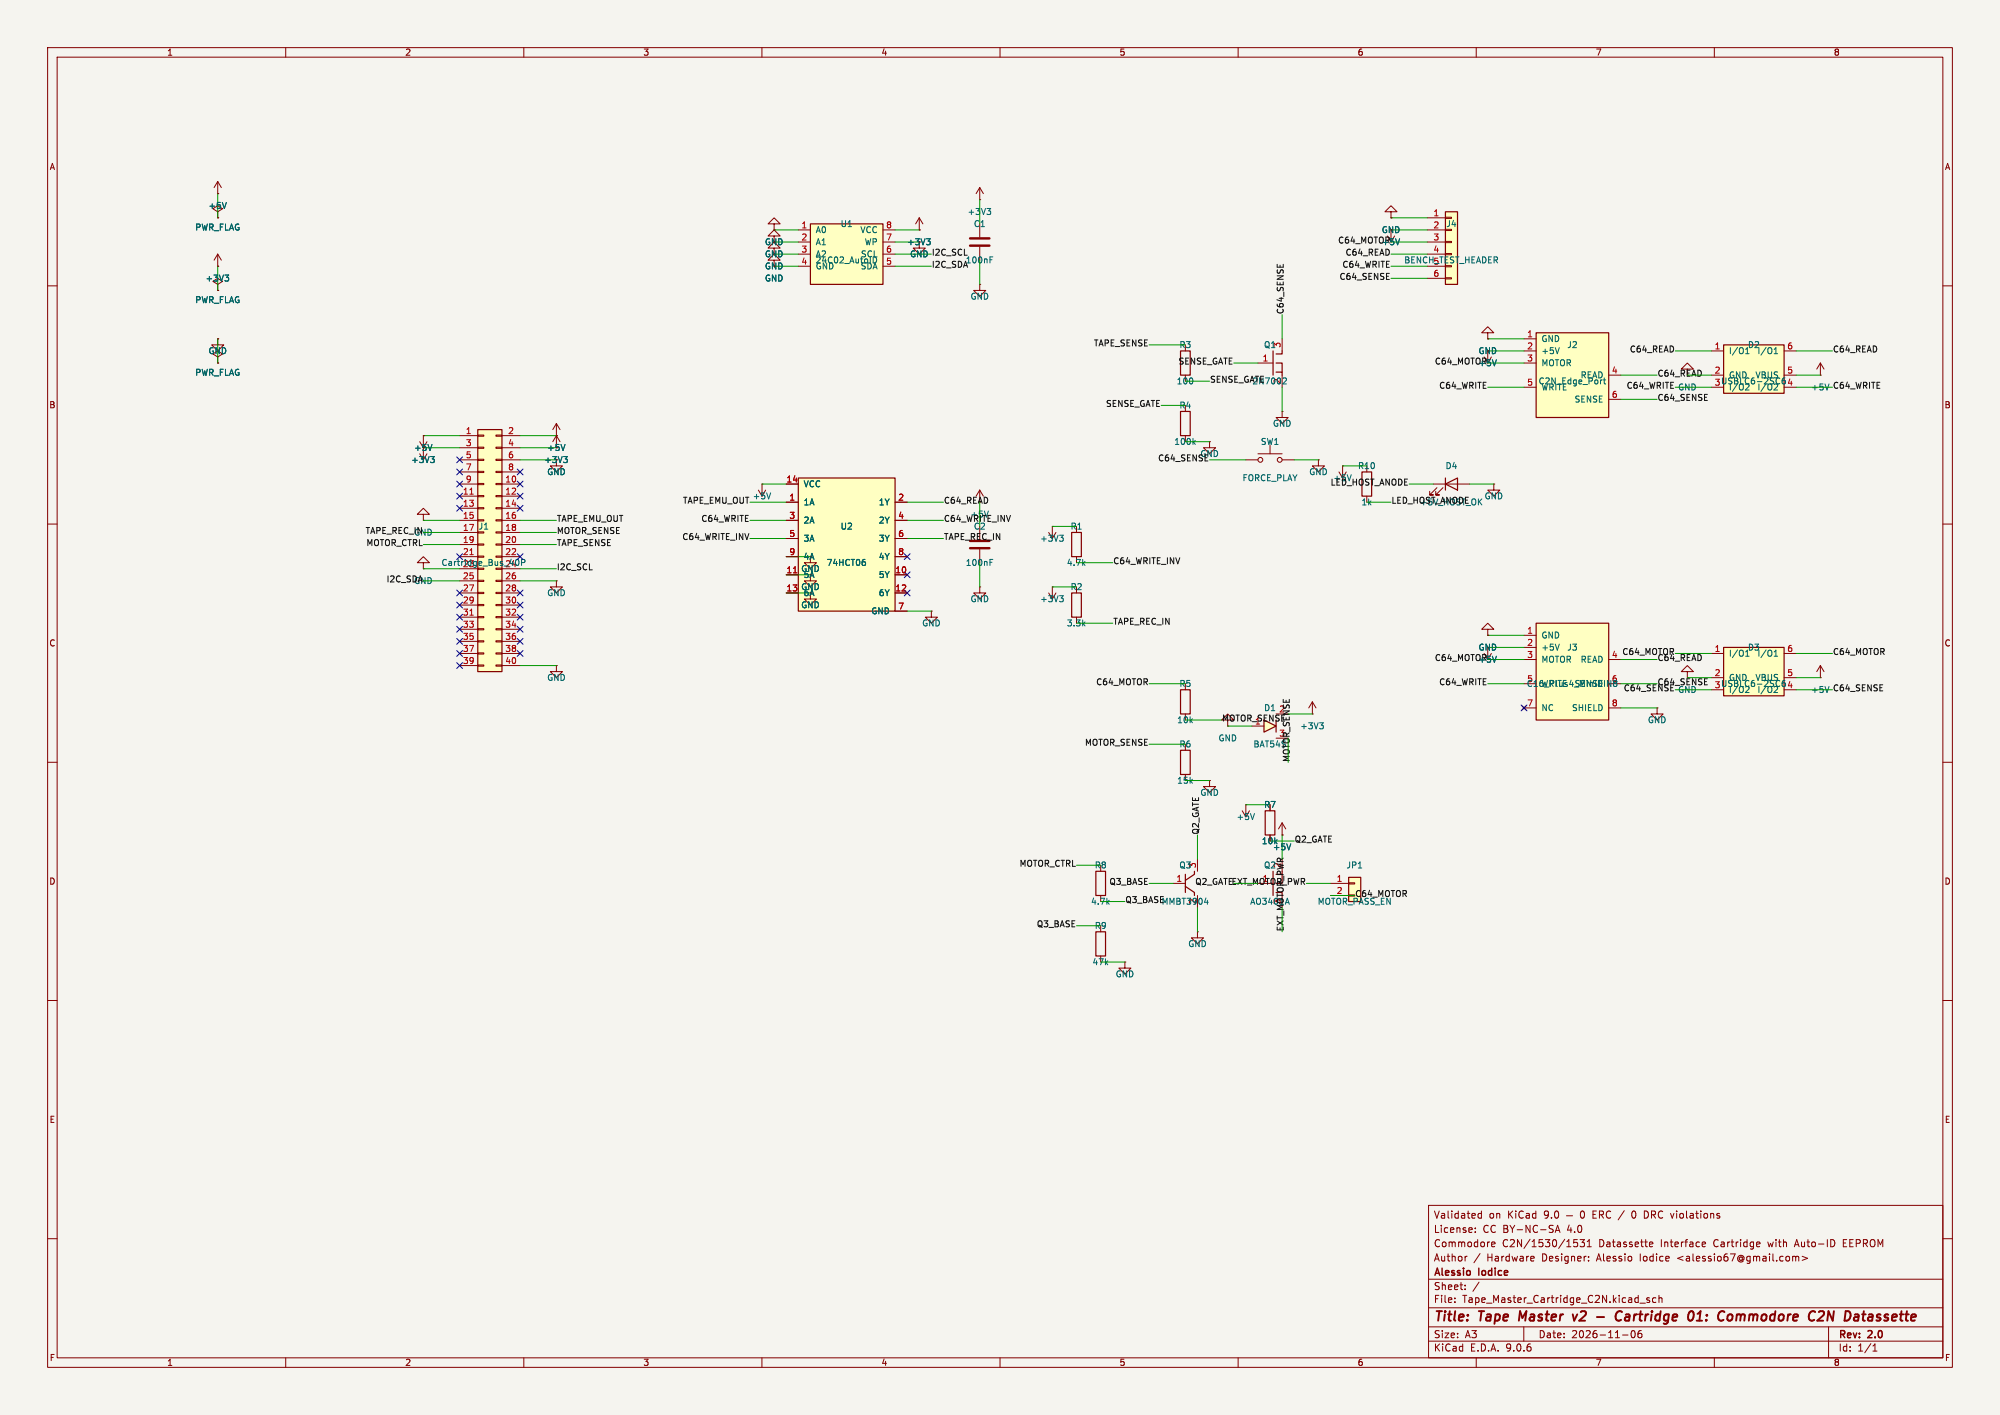
[picture p17: page 1]

+3V3 GND GND GND GND GND

Id: 1/1 Title: Tape Master v2 - Cartridge 01: Commodore C2N Datassette
