lucedoriente/Tape_Master/kicad/v2/Cartridges/07_Acorn_BBC_Micro/Tape_Master_Cartridge_BBC_Micro_Top.pdf

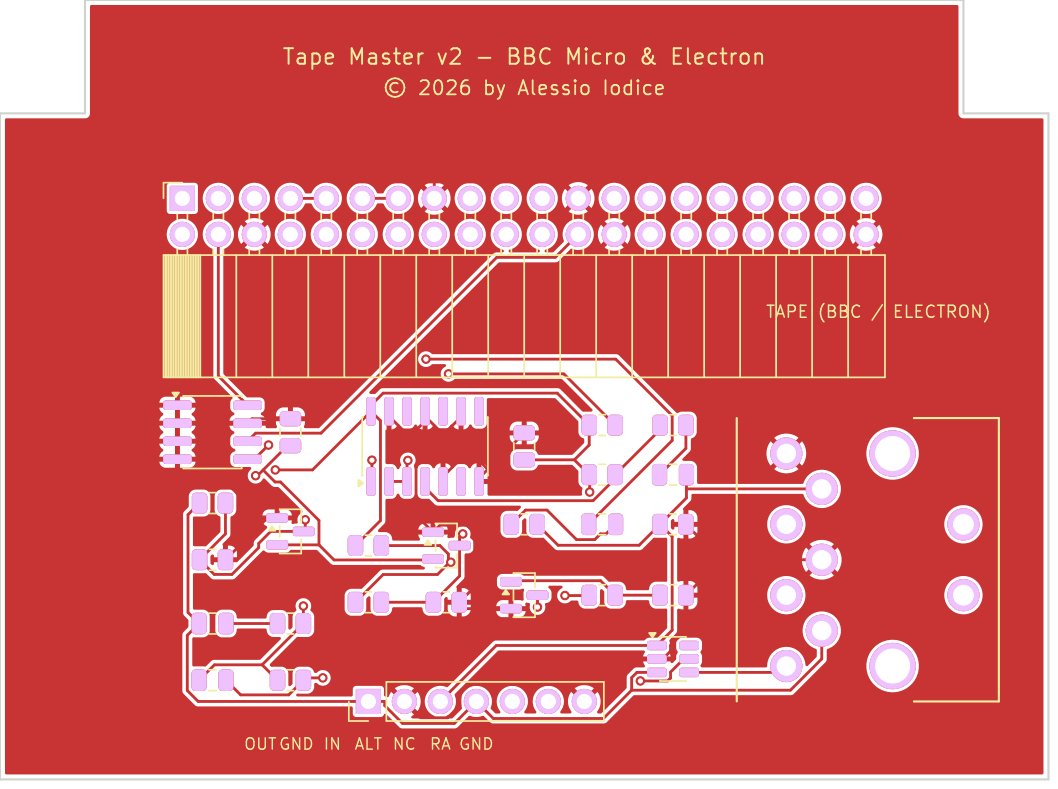
[picture p18: page 1]

RA Tape Master v2 - BBC Micro & Electron GND IN
