lucedoriente/Tape_Master/kicad/v2/Cartridges/09_TI99_4A/Tape_Master_Cartridge_TI99.pdf

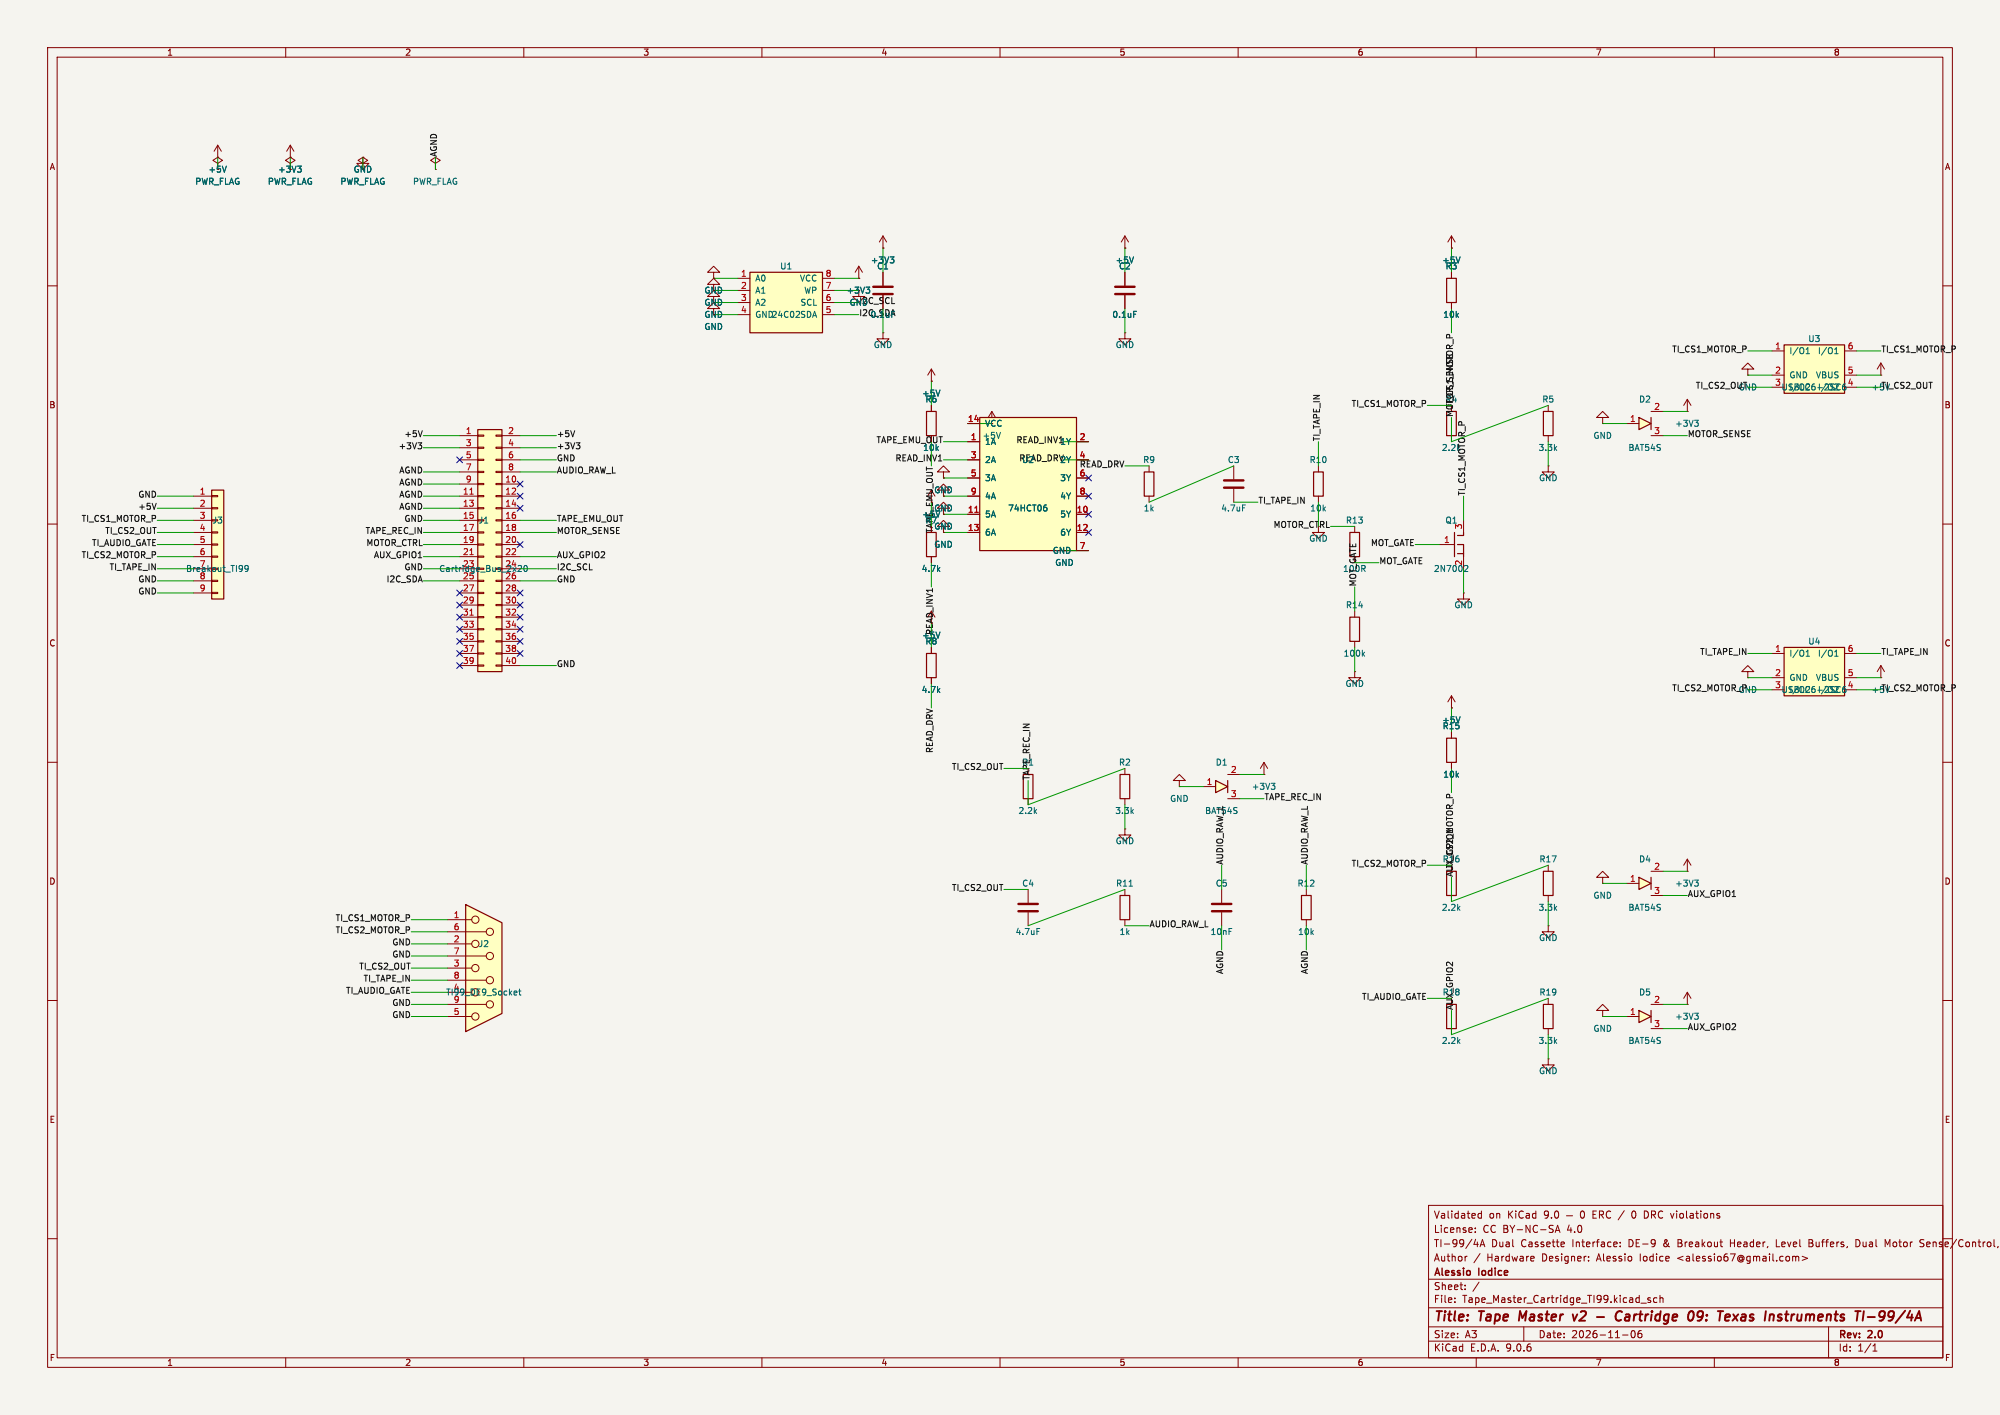
[picture p19: page 1]

GND GND

Id: 1/1 Title: Tape Master v2 - Cartridge 09: Texas Instruments TI-99/4A
