lucedoriente/Tape_Master/kicad/v2/Cartridges/04_Sinclair_ZX_Spectrum/Tape_Master_Cartridge_Sinclair_ZX_Top.pdf

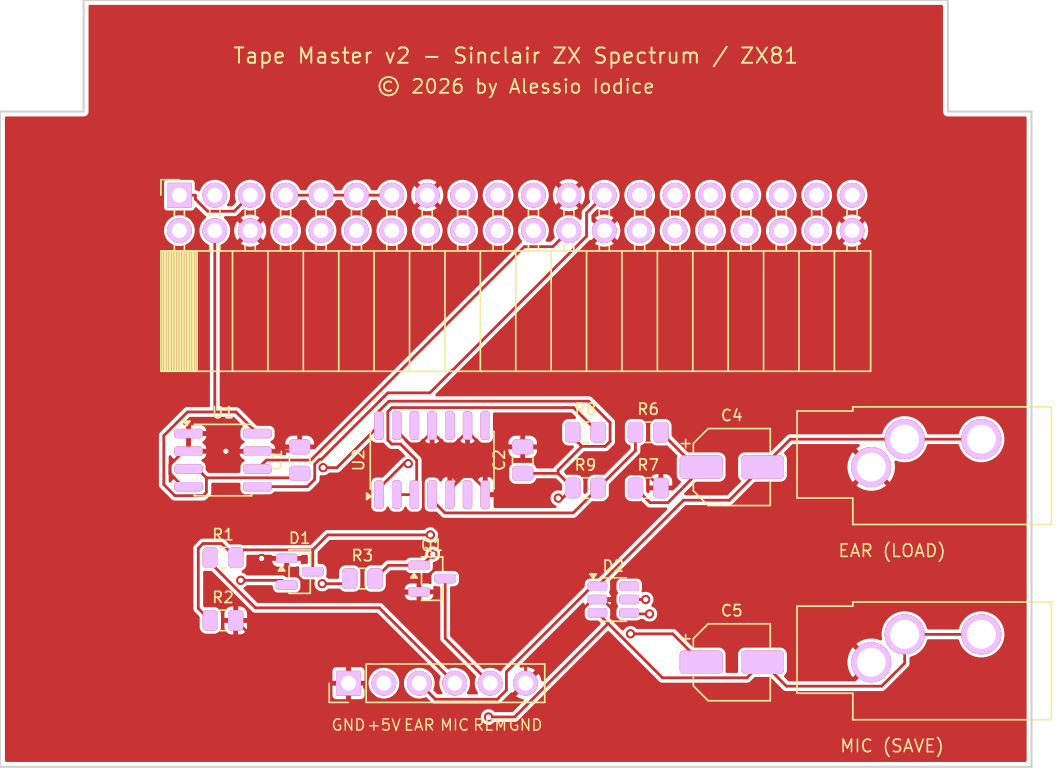
[picture p22: page 1]
