lucedoriente/Tape_Master/kicad/v2/Cartridges/08_Tandy_CoCo_Dragon/Tape_Master_Cartridge_CoCo_Dragon_Schematic.pdf

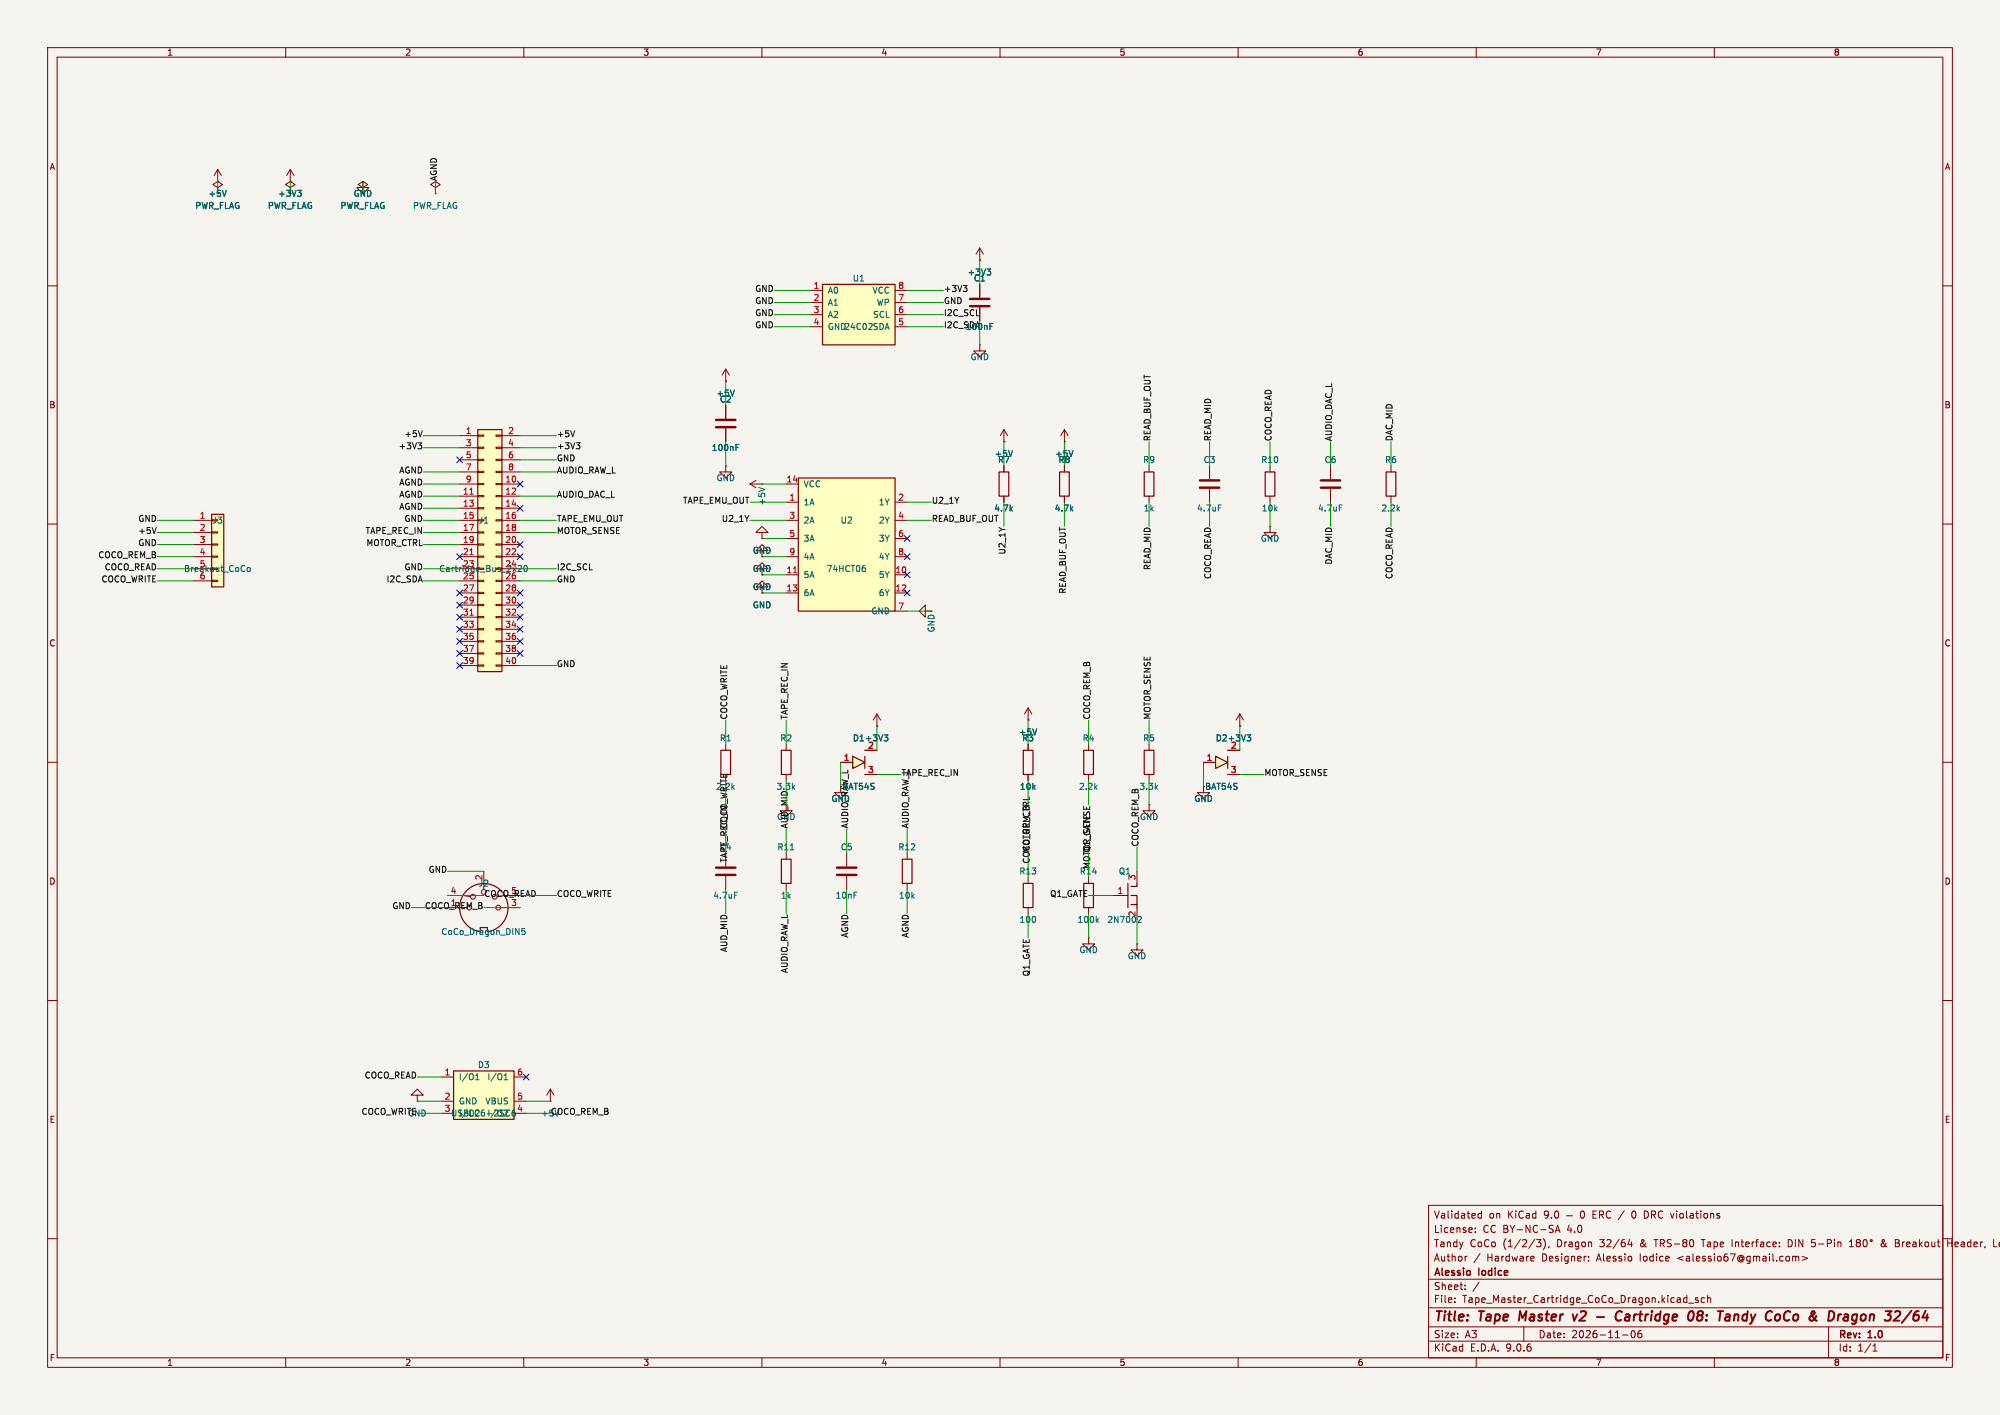
[picture p24: page 1]

Id: 1/1 Title: Tape Master v2 - Cartridge 08: Tandy CoCo & Dragon 32/64
