lucedoriente/Tape_Master/kicad/v2/Cartridges/11_Oric_Atmos/Tape_Master_Cartridge_Oric_Atmos_Schematic.pdf

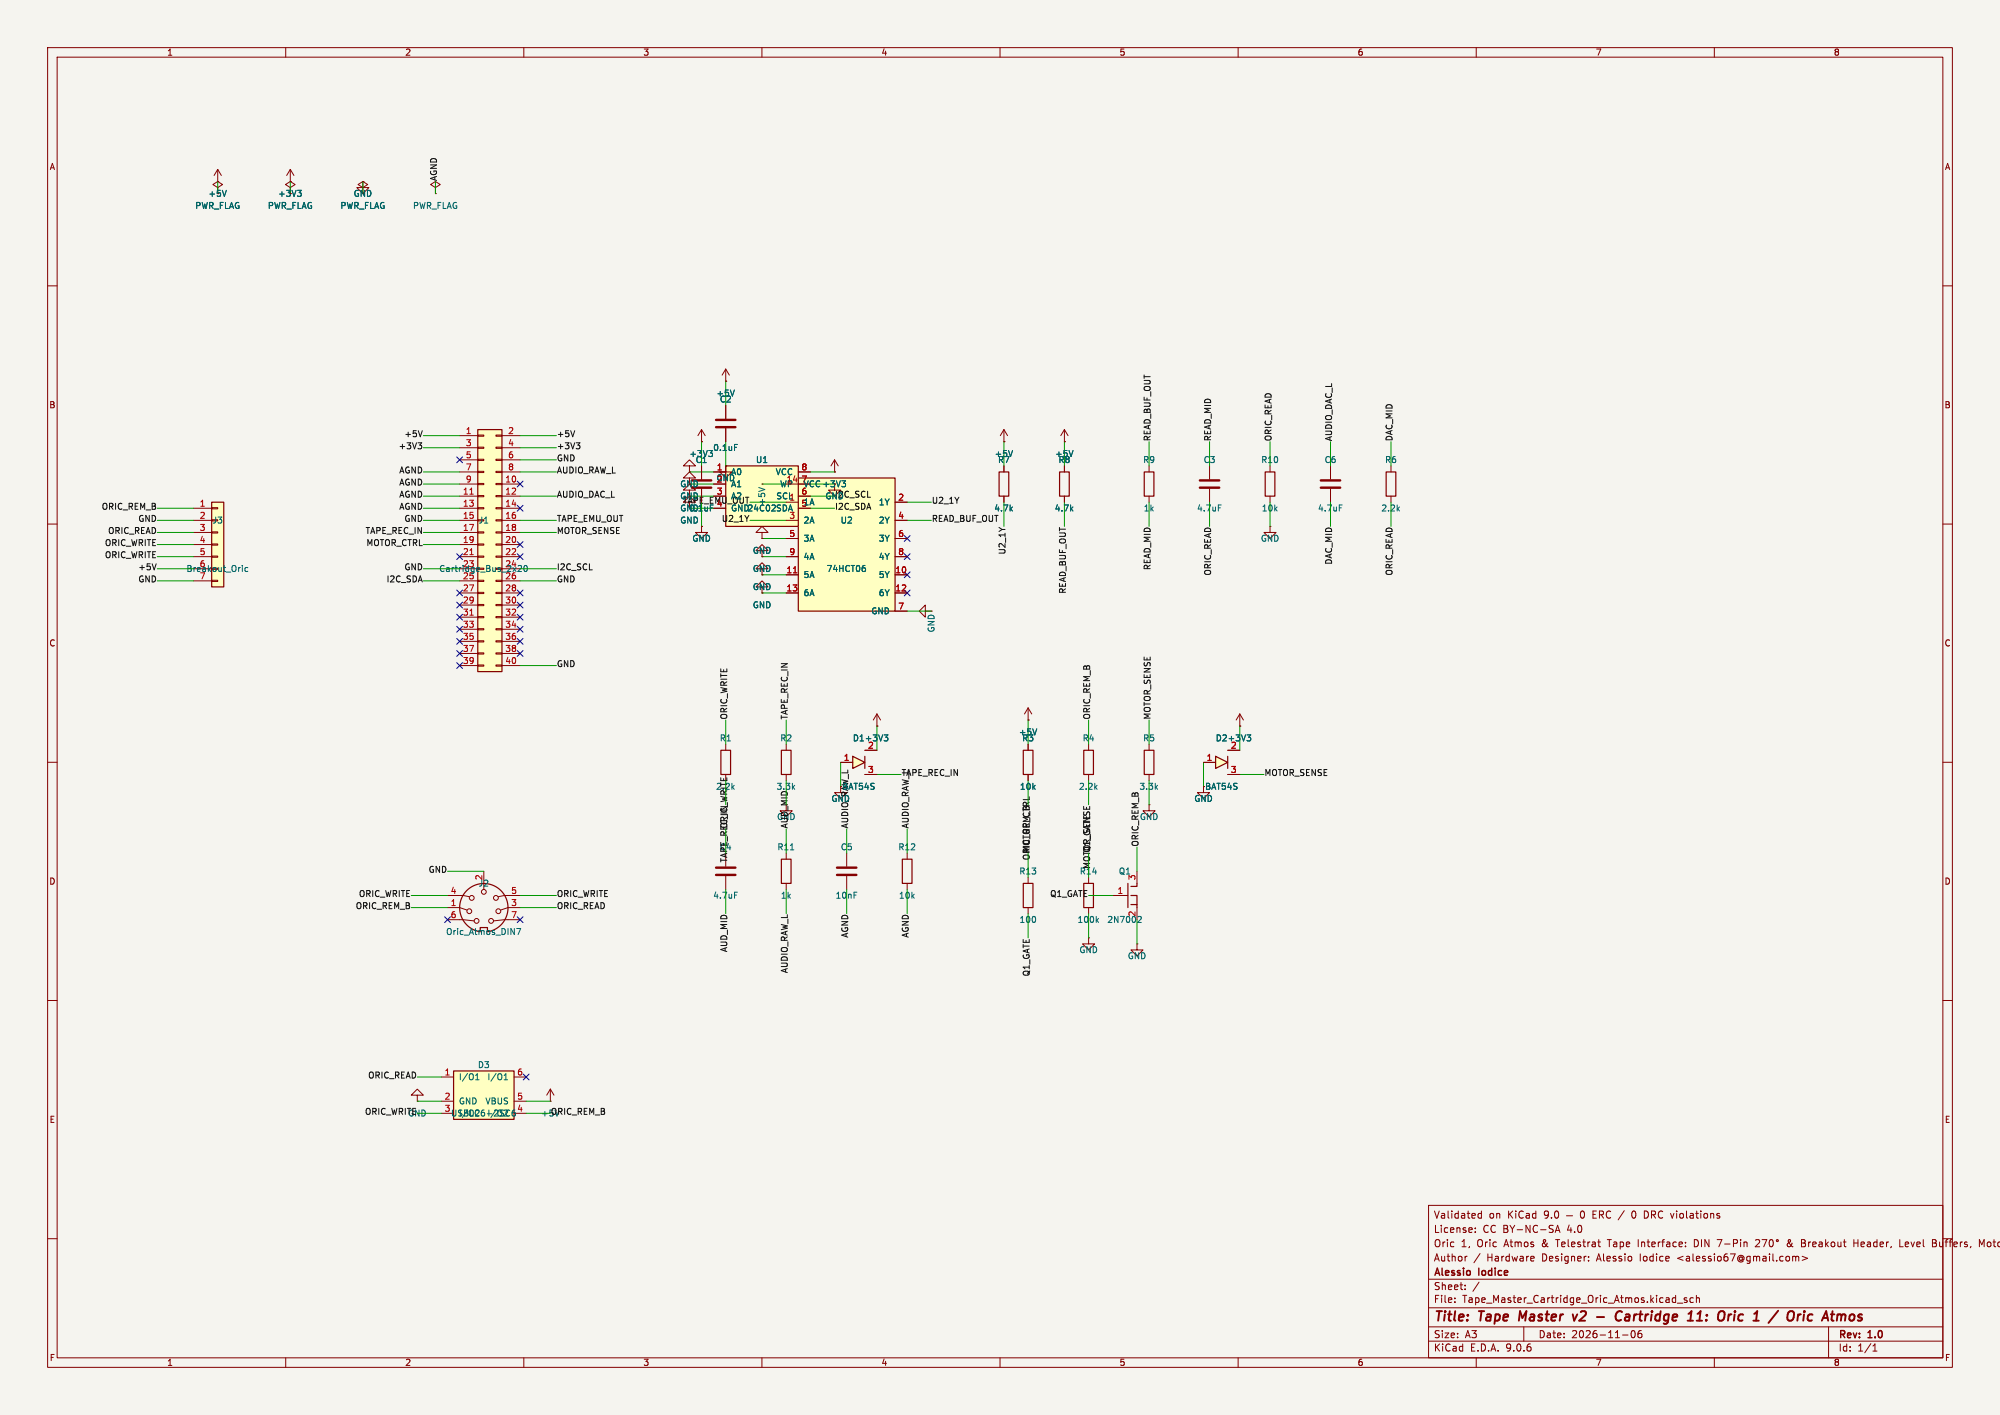
[picture p26: page 1]

Id: 1/1 Title: Tape Master v2 - Cartridge 11: Oric 1 / Oric Atmos
