lucedoriente/Tape_Master/kicad/v2/Mainboard/Tape_Master_Mainboard.pdf

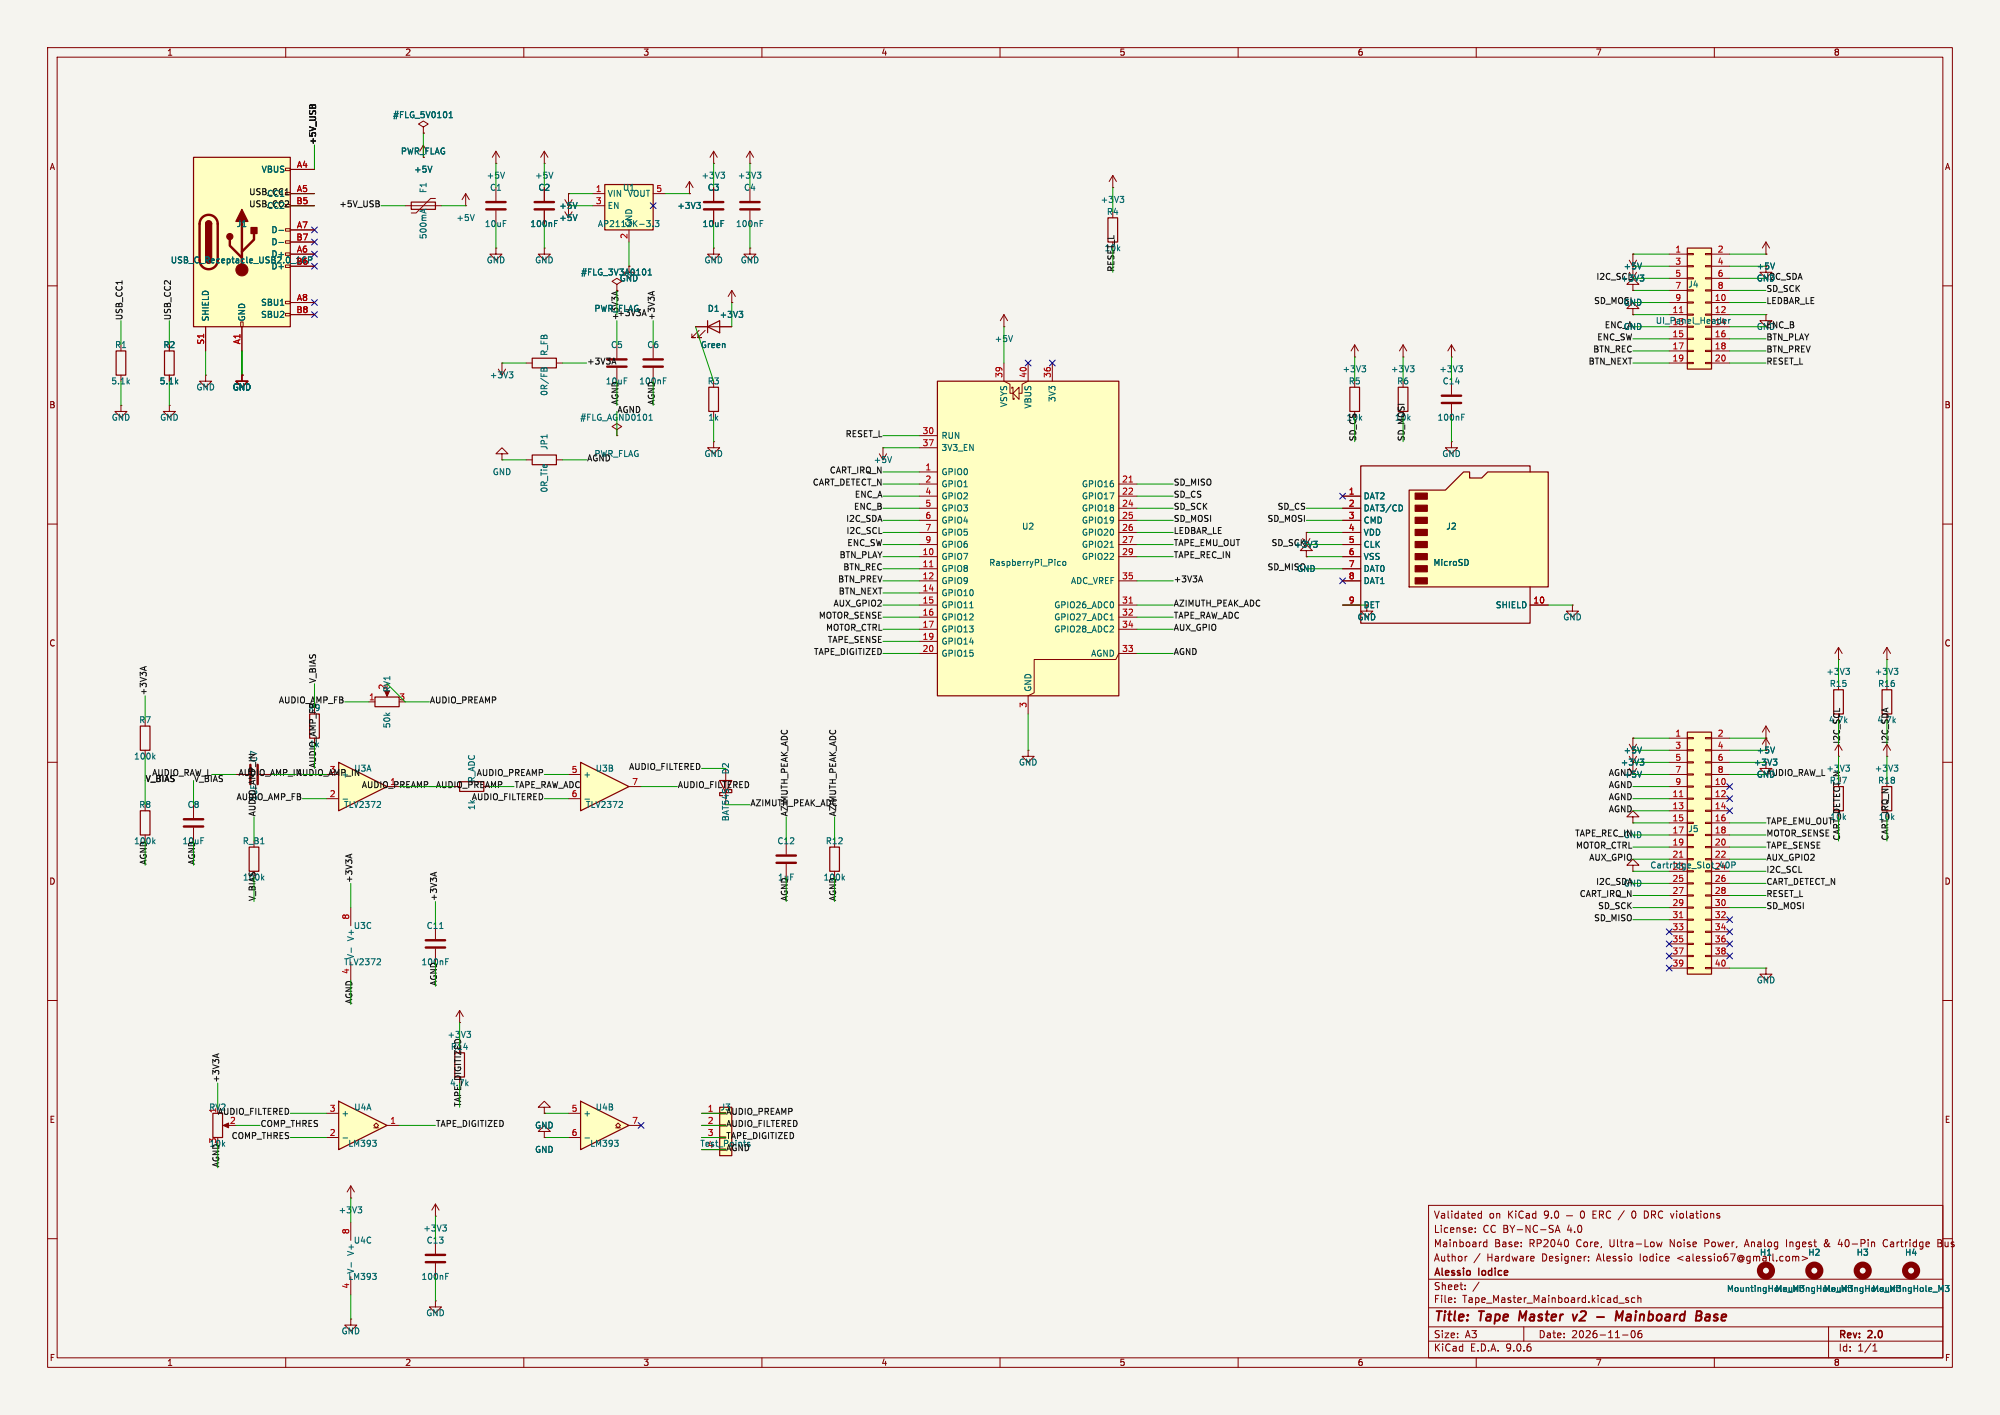
[picture p28: page 1]

Id: 1/1 Title: Tape Master v2 - Mainboard Base
