lucedoriente/Tape_Master/kicad/v2/UI_Panel/Tape_Master_UI_Panel.pdf

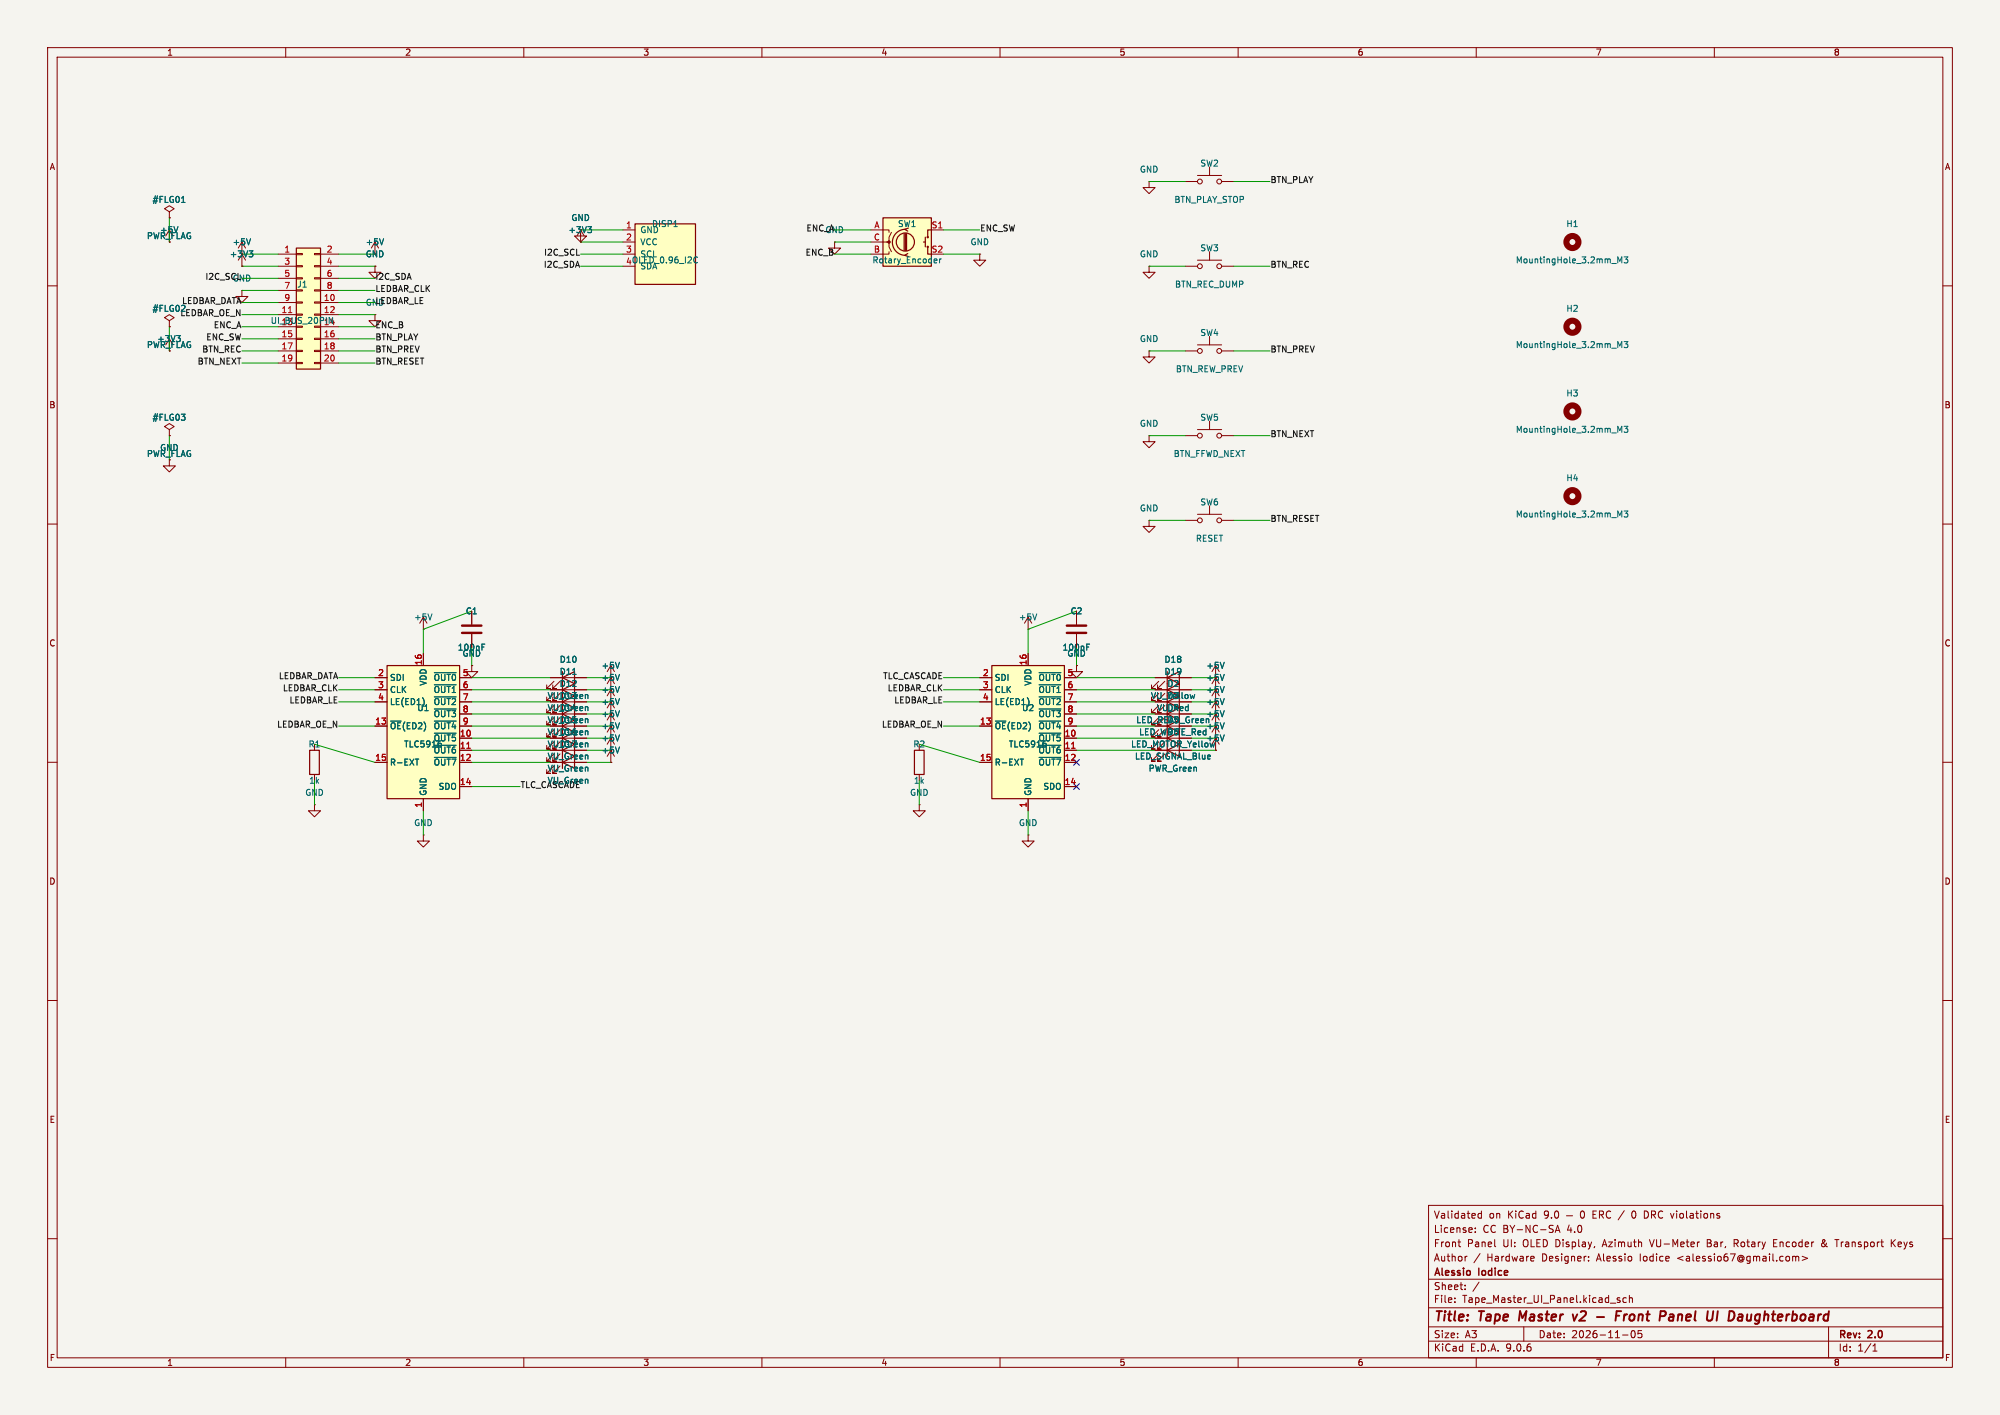
[picture p29: page 1]

Id: 1/1 Title: Tape Master v2 - Front Panel UI Daughterboard
