lucedoriente/Tape_Master/kicad/v2/Cartridges/02_Atari_SIO/Tape_Master_Cartridge_Atari_SIO.pdf

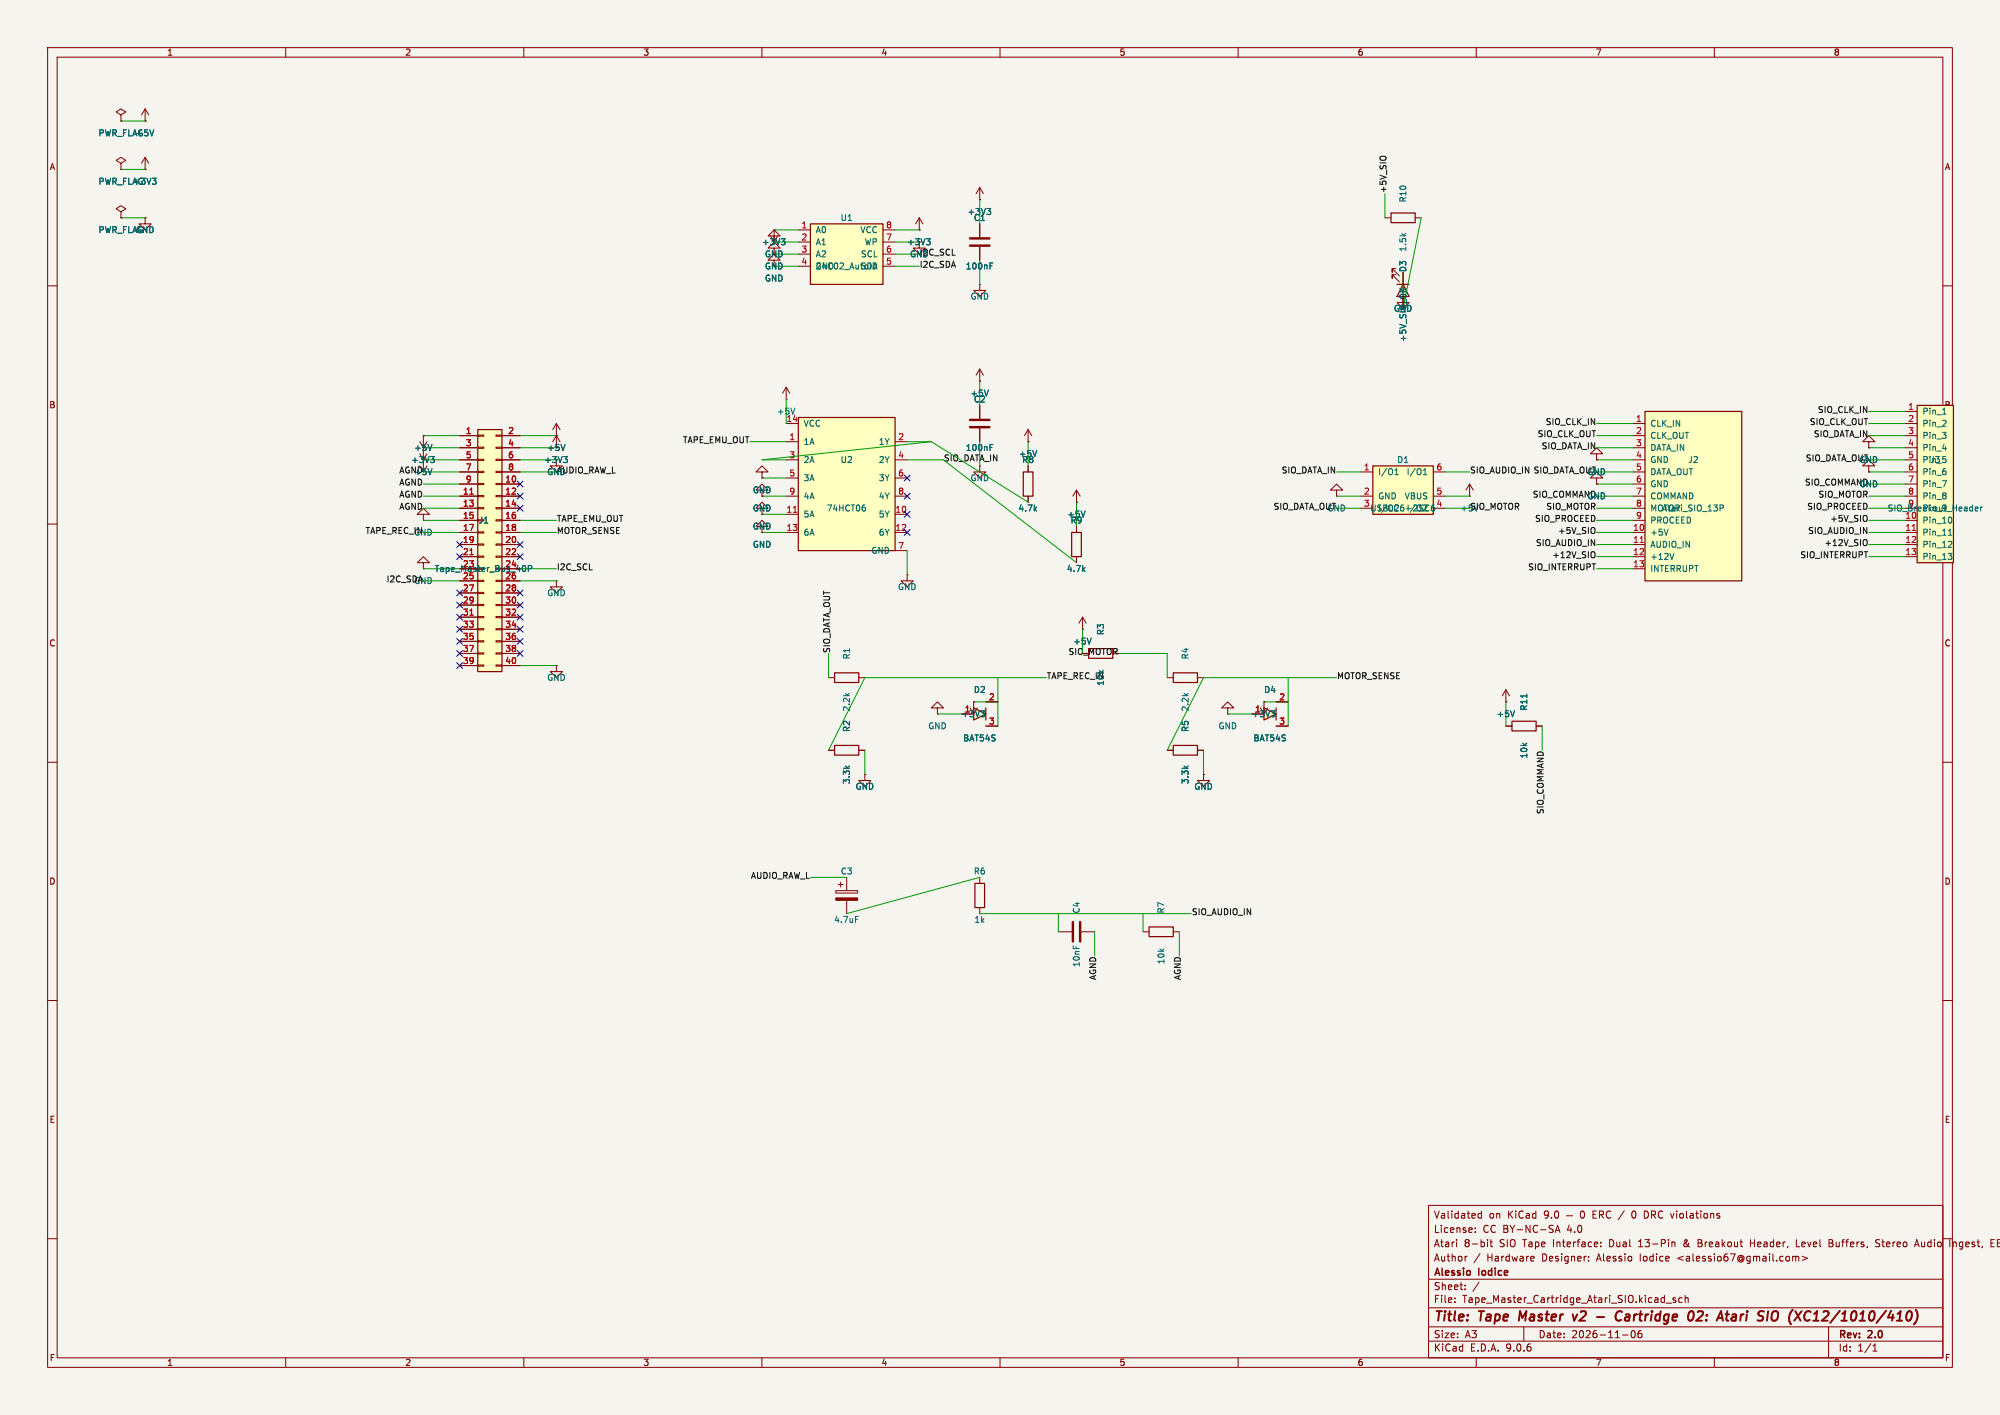
[picture p30: page 1]
