lucedoriente/Tape_Master/kicad/v2/Cartridges/02_Atari_SIO/Tape_Master_Cartridge_Atari_SIO_Bottom.pdf

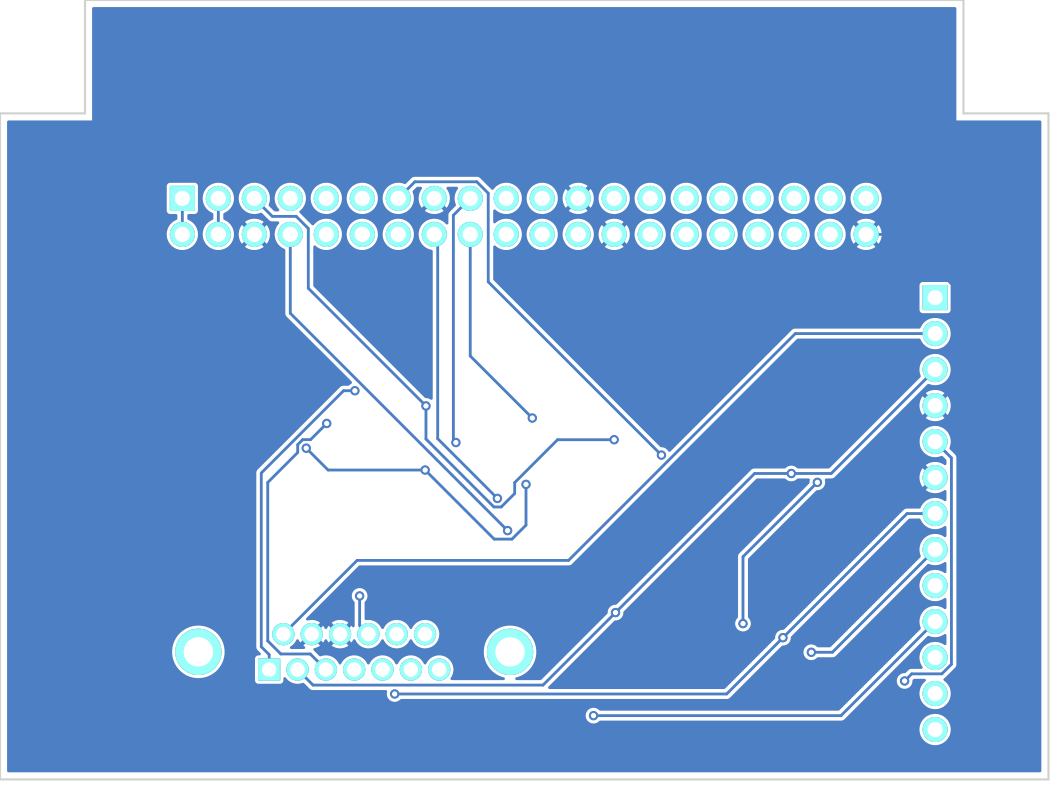
[picture p31: page 1]
