lucedoriente/Tape_Master/kicad/v2/Cartridges/02_Atari_SIO/Tape_Master_Cartridge_Atari_SIO_Top.pdf

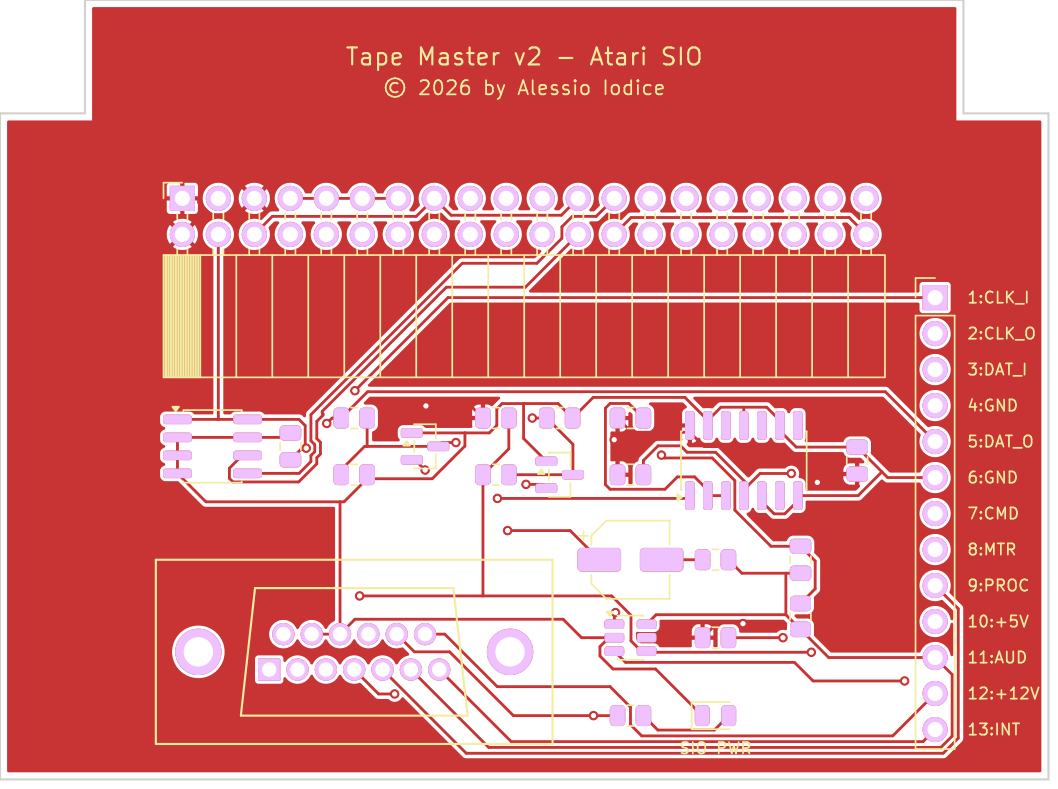
[picture p32: page 1]

Tape Master v2 - Atari SIO
þÿ©2026 by Alessio Iodice
