lucedoriente/Tape_Master/kicad/v2/Cartridges/03_Thomson_Olivetti_PC128/Tape_Master_Cartridge_Thomson_PC128_Bottom.pdf

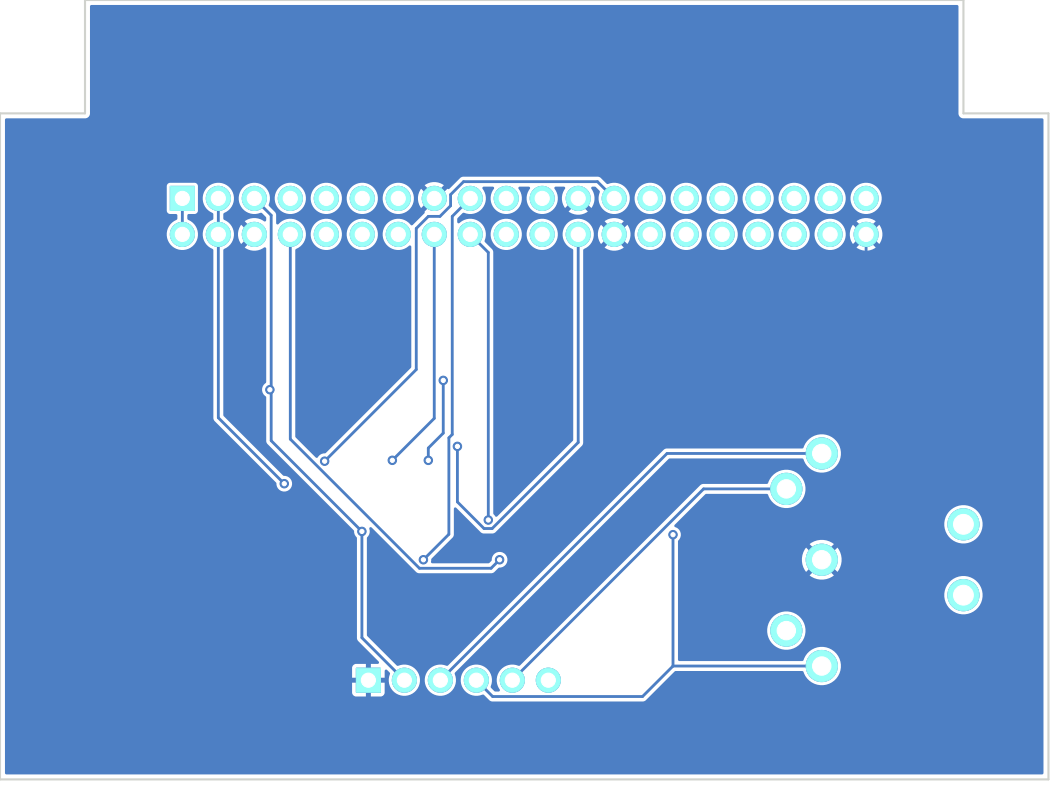
[picture p34: page 1]
