lucedoriente/Tape_Master/kicad/v2/Cartridges/03_Thomson_Olivetti_PC128/Tape_Master_Cartridge_Thomson_PC128_Top.pdf

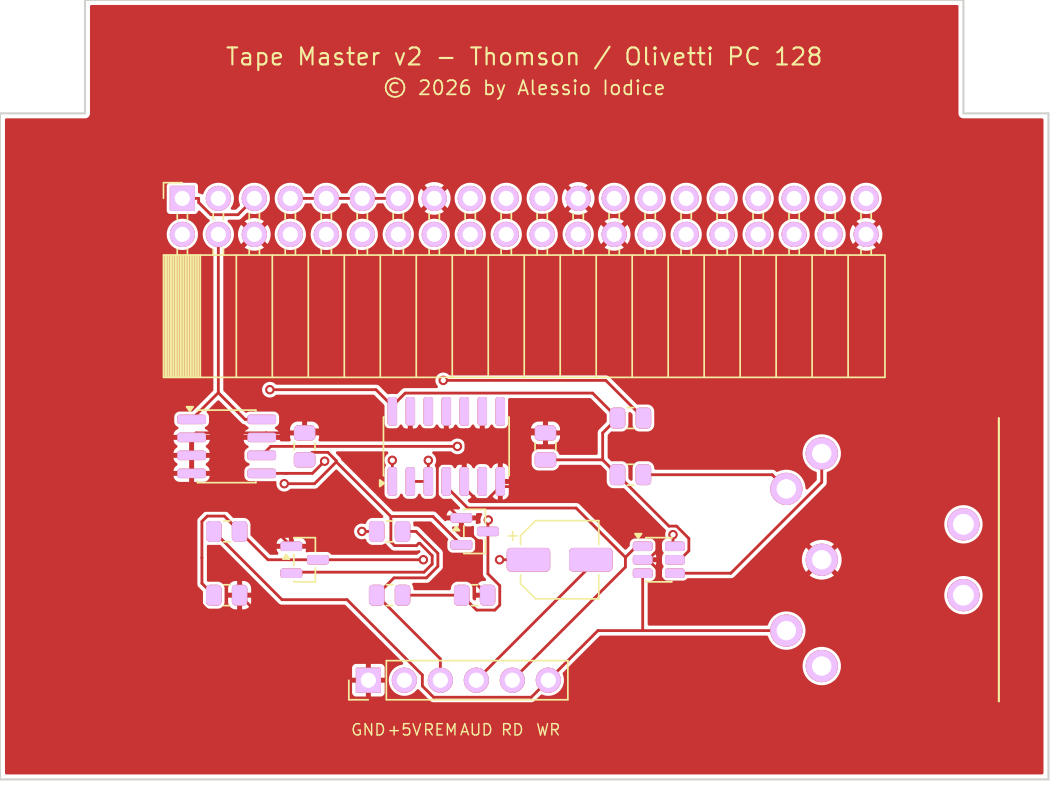
[picture p35: page 1]

þÿ©2026 by Alessio Iodice
