lucedoriente/Tape_Master/kicad/v2/Cartridges/05_Amstrad_CPC/Tape_Master_Cartridge_Amstrad_CPC_Bottom.pdf

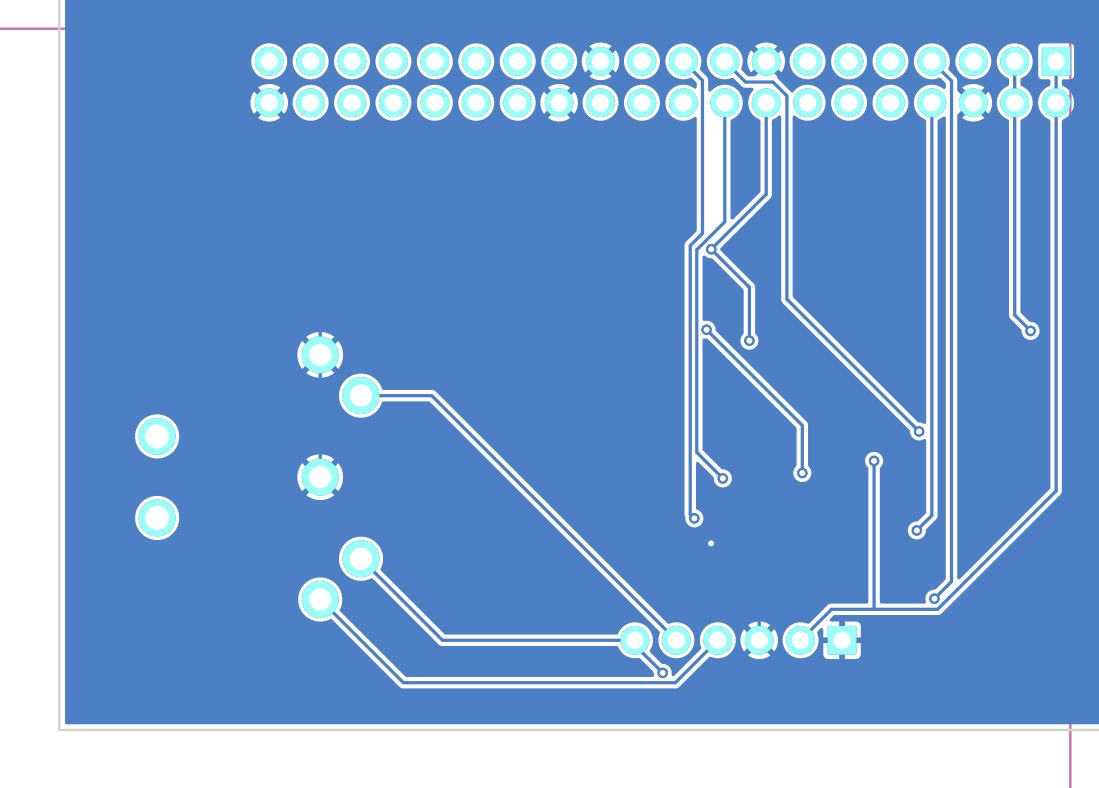
[picture p36: page 1]

Id: 1/1 Title: Tape Master v2 - Cartridge 05: Amstrad CPC
