lucedoriente/Tape_Master/kicad/v2/Cartridges/05_Amstrad_CPC/Tape_Master_Cartridge_Amstrad_CPC_Top.pdf

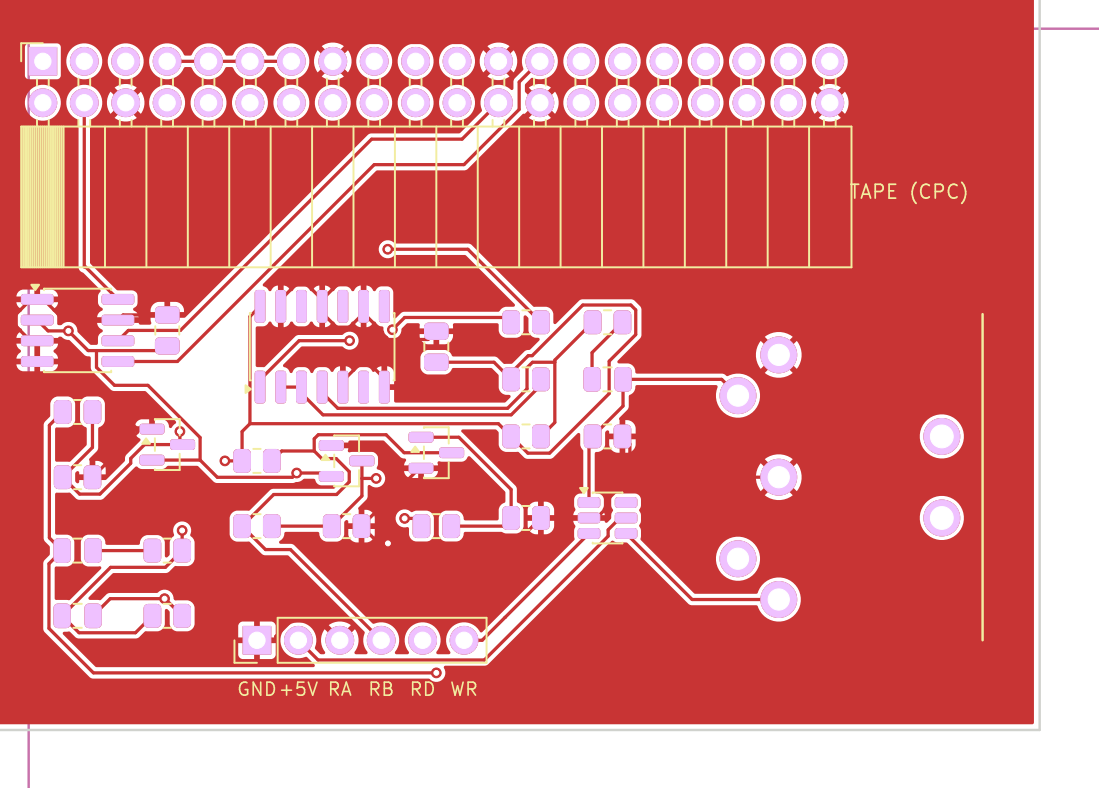
[picture p37: page 1]

TAPE (CPC) þÿ©2026 by Alessio Iodice RB

Id: 1/1 Title: Tape Master v2 - Cartridge 05: Amstrad CPC
