lucedoriente/Tape_Master/kicad/v2/Cartridges/07_Acorn_BBC_Micro/Tape_Master_Cartridge_BBC_Micro.pdf

Id: 1/1 Title: Tape Master v2 - Cartridge 07: Acorn BBC Micro & Electron
