lucedoriente/Tape_Master/kicad/v2/Cartridges/07_Acorn_BBC_Micro/Tape_Master_Cartridge_BBC_Micro_Bottom.pdf

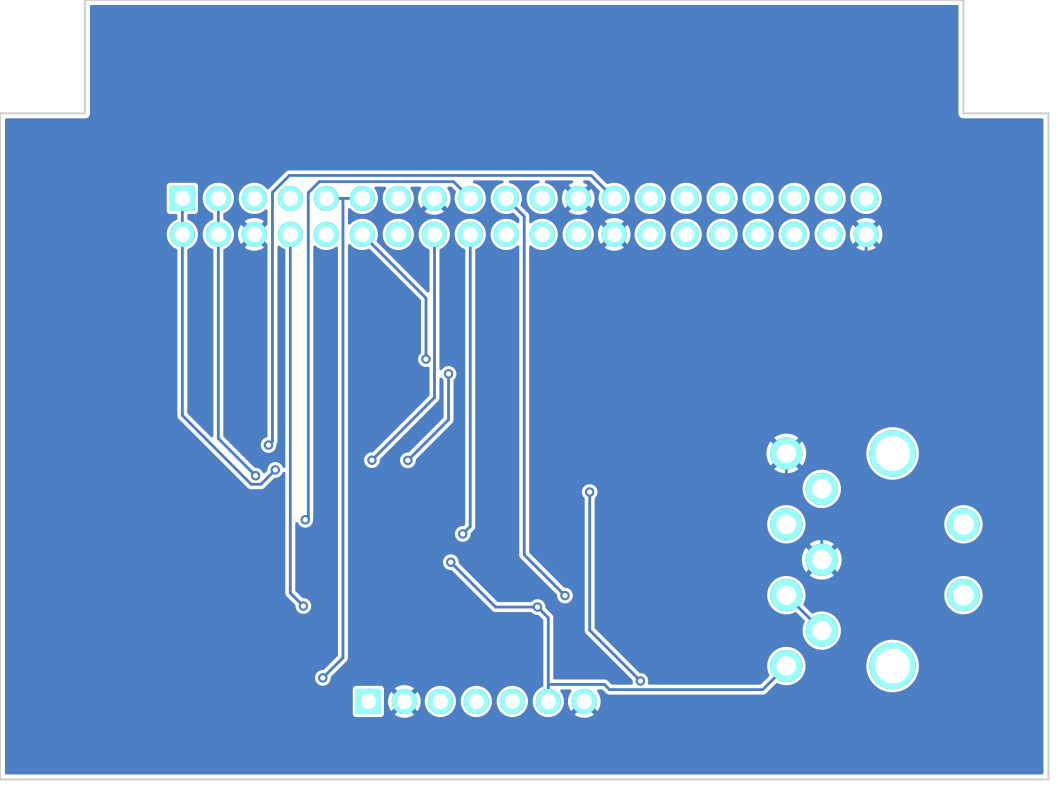
[picture p38: page 1]
