lucedoriente/Tape_Master/kicad/v2/Cartridges/08_Tandy_CoCo_Dragon/Tape_Master_Cartridge_CoCo_Dragon_Bottom.pdf

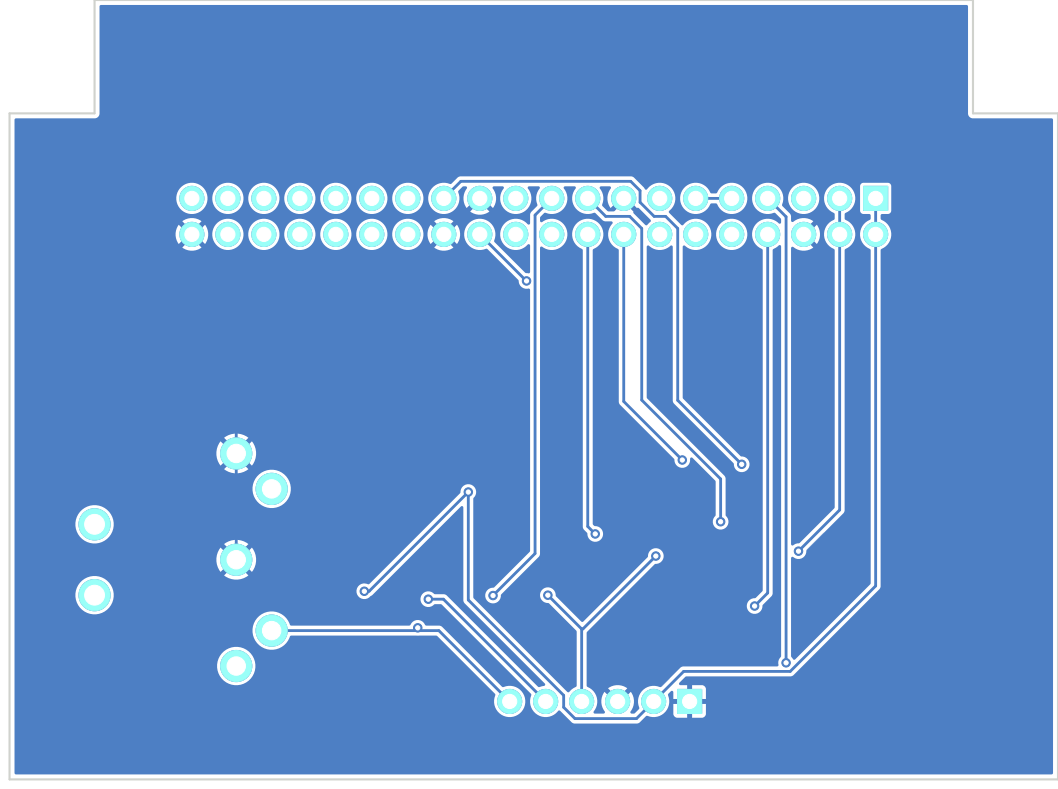
[picture p39: page 1]
