lucedoriente/Tape_Master/kicad/v2/Cartridges/08_Tandy_CoCo_Dragon/Tape_Master_Cartridge_CoCo_Dragon_Top.pdf

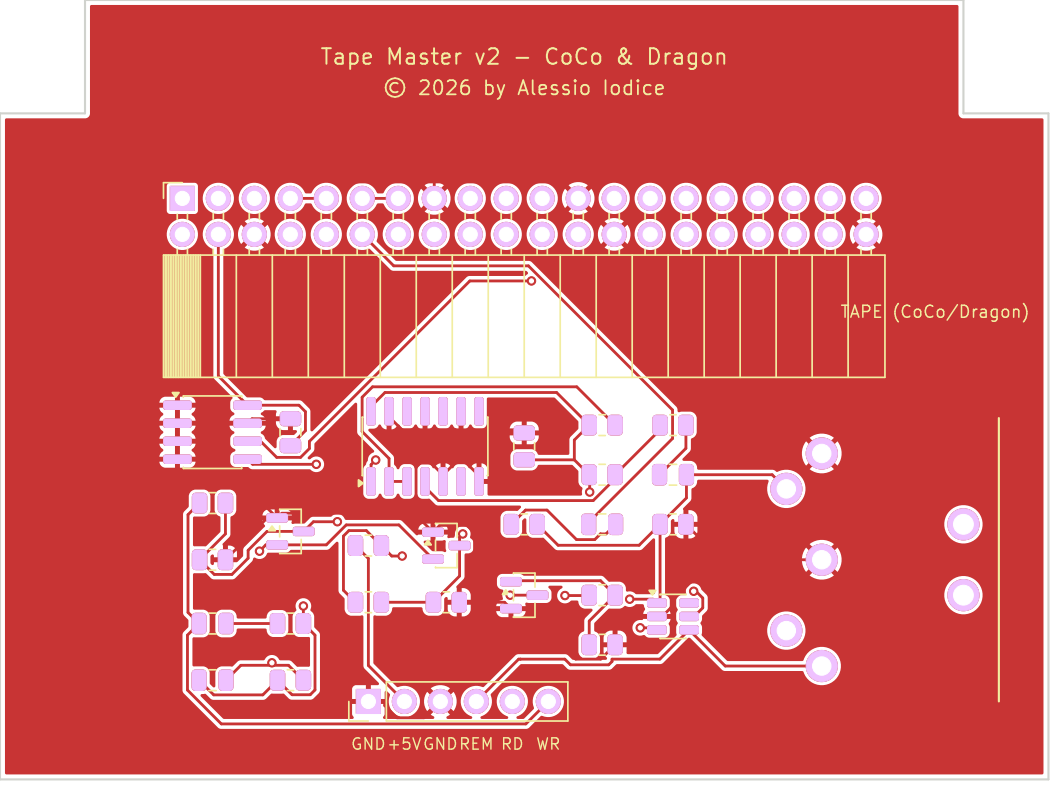
[picture p40: page 1]

þÿ©2026 by Alessio Iodice Tape Master v2 - CoCo & Dragon
