lucedoriente/Tape_Master/kicad/v2/Cartridges/09_TI99_4A/Tape_Master_Cartridge_TI99_Bottom.pdf

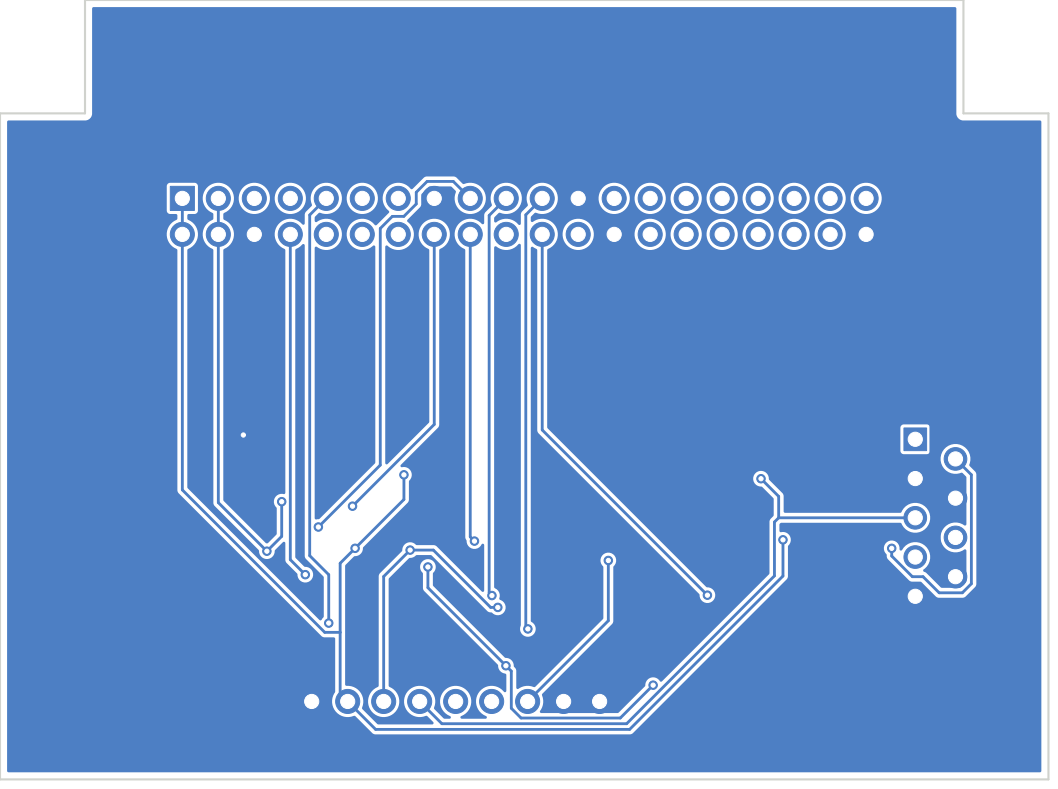
[picture p41: page 1]
