lucedoriente/Tape_Master/kicad/v2/Cartridges/09_TI99_4A/Tape_Master_Cartridge_TI99_Top.pdf

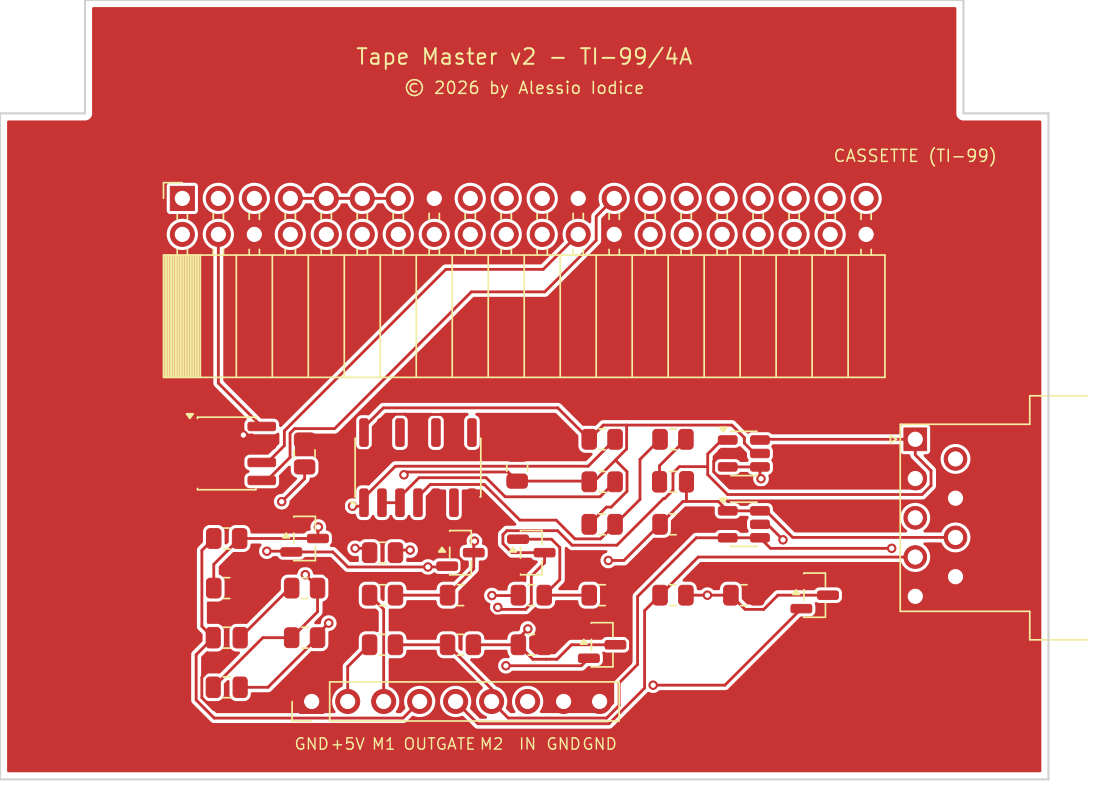
[picture p42: page 1]

þÿ©2026 by Alessio Iodice Tape Master v2 - TI-99/4A
