lucedoriente/Tape_Master/kicad/v2/Cartridges/10_Apple_II/Tape_Master_Cartridge_Apple_II_Bottom.pdf

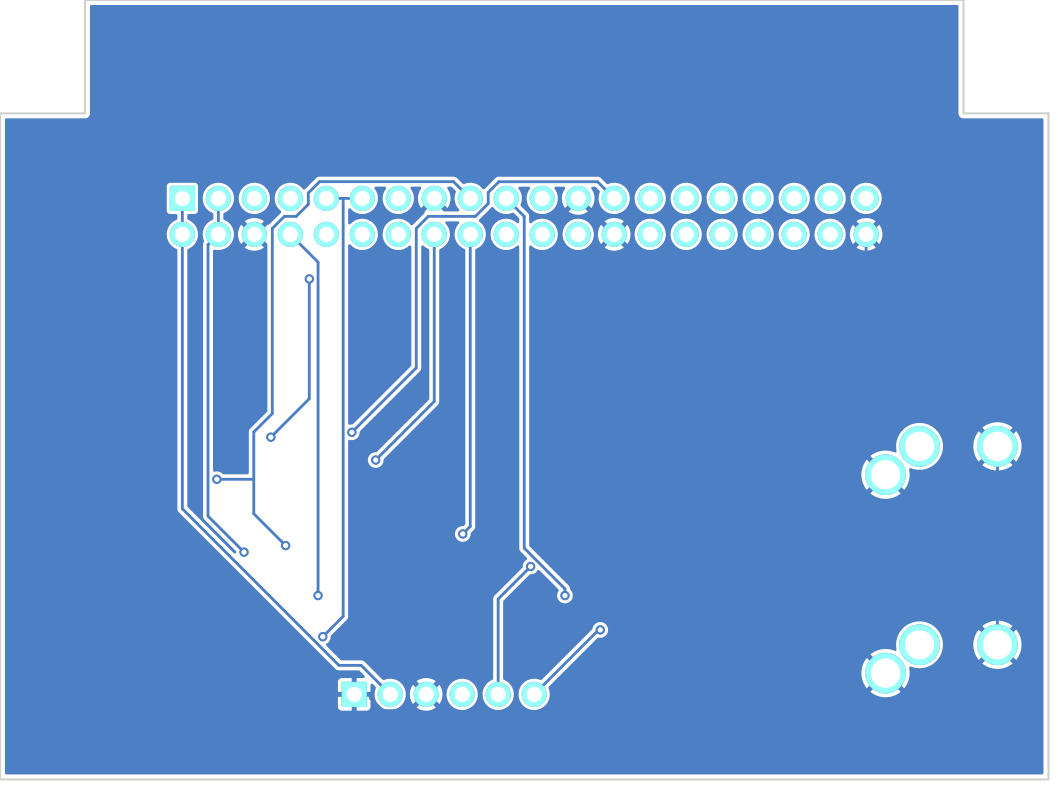
[picture p44: page 1]
