lucedoriente/Tape_Master/kicad/v2/Cartridges/11_Oric_Atmos/Tape_Master_Cartridge_Oric_Atmos.pdf

Id: 1/1 Title: Tape Master v2 - Cartridge 11: Oric 1 / Oric Atmos
