lucedoriente/Tape_Master/kicad/v2/Cartridges/11_Oric_Atmos/Tape_Master_Cartridge_Oric_Atmos_Bottom.pdf

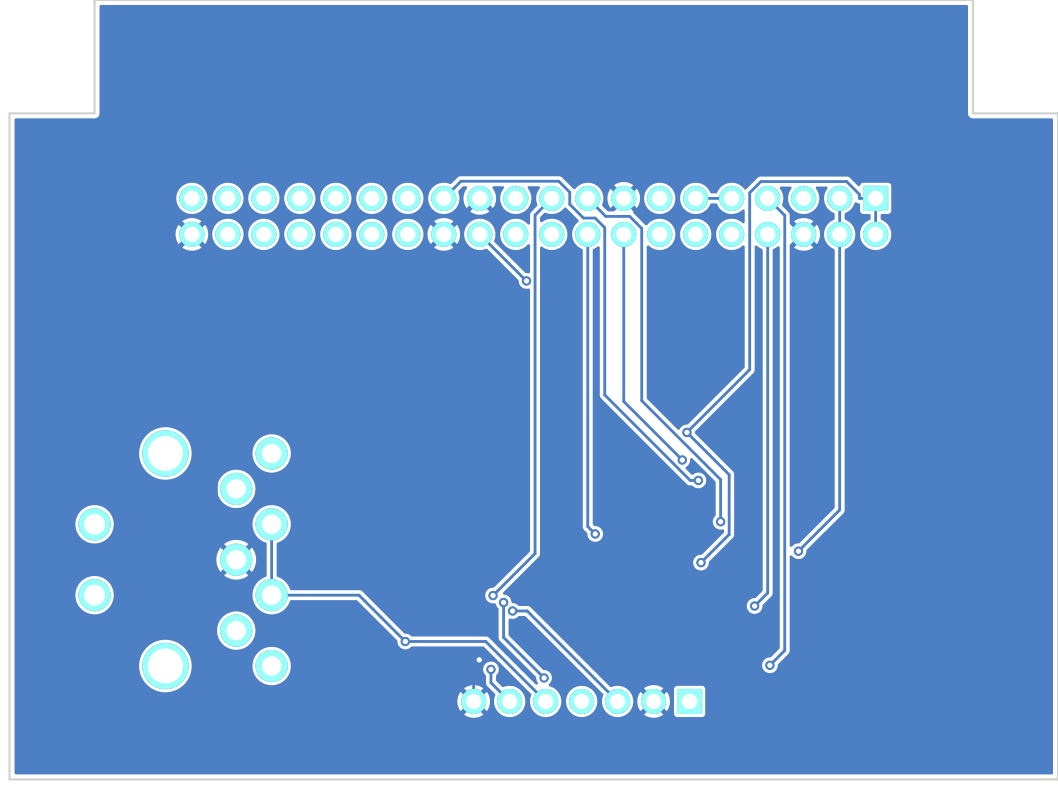
[picture p46: page 1]
