lucedoriente/Tape_Master/kicad/v2/Cartridges/11_Oric_Atmos/Tape_Master_Cartridge_Oric_Atmos_Top.pdf

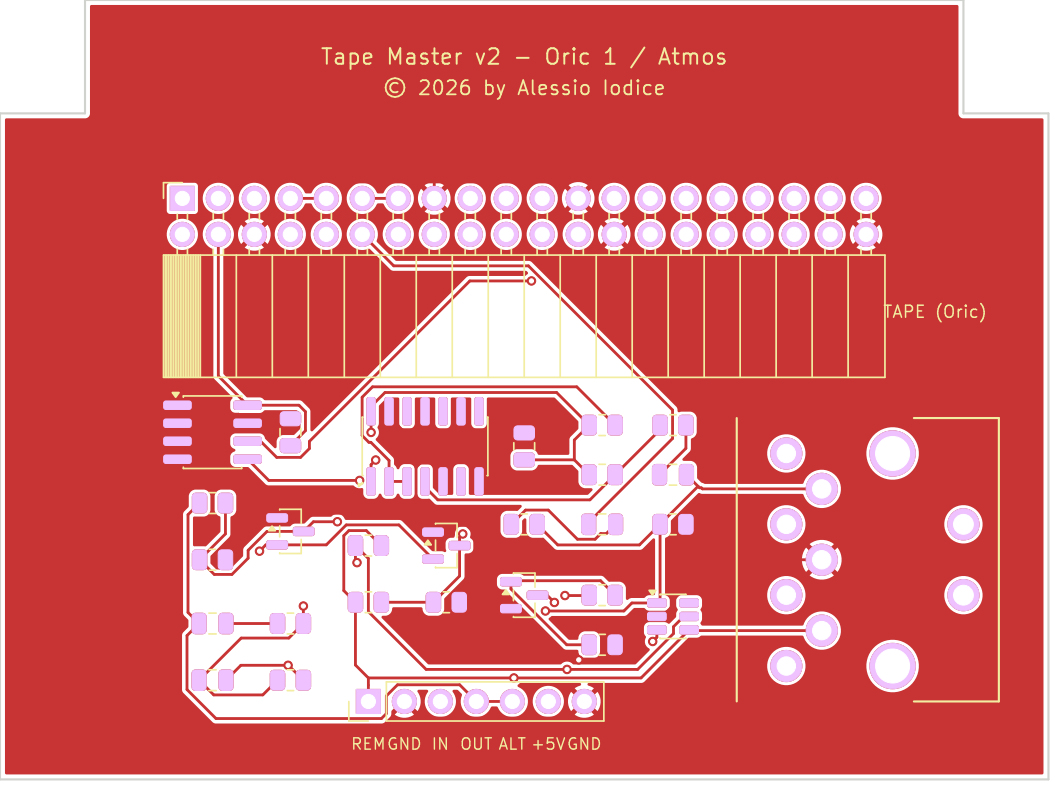
[picture p47: page 1]

þÿ©2026 by Alessio Iodice
