lucedoriente/Tape_Master/kicad/v2/Cartridges/12_Sharp_MZ/Tape_Master_Cartridge_Sharp_MZ.pdf

Id: 1/1 Title: Tape Master Cartridge #12 - Sharp MZ Series
