lucedoriente/Tape_Master/kicad/v2/Cartridges/12_Sharp_MZ/Tape_Master_Cartridge_Sharp_MZ_Bottom.pdf

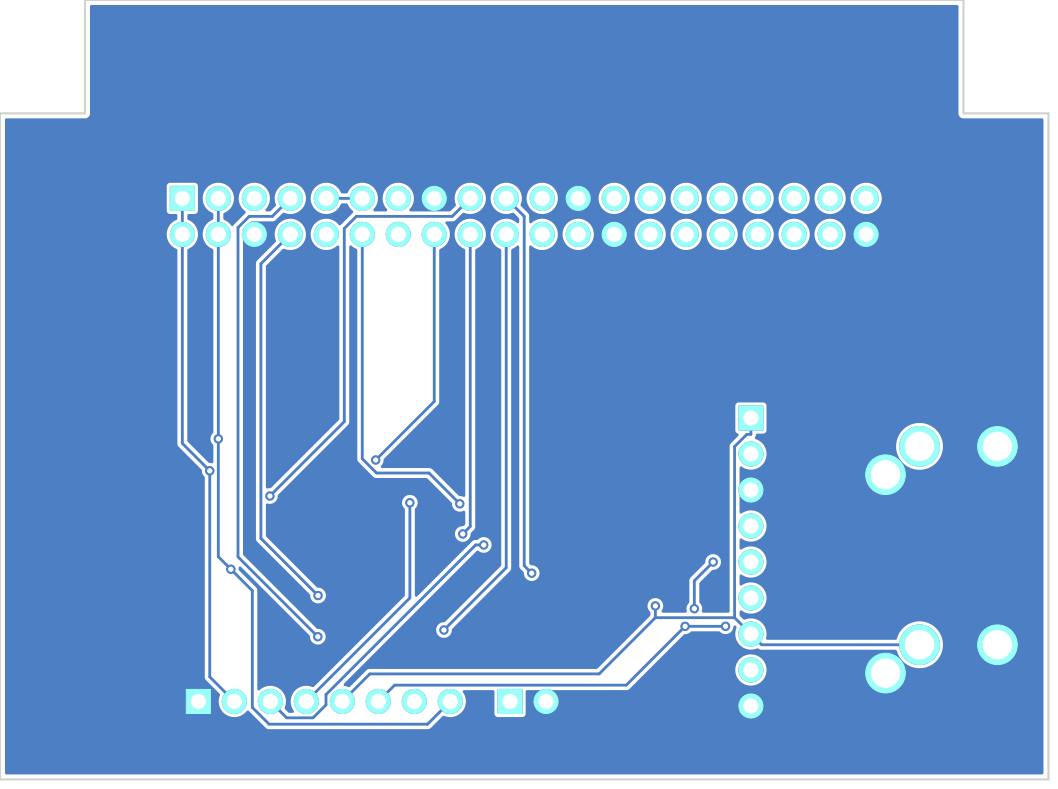
[picture p48: page 1]
