lucedoriente/Tape_Master/kicad/v2/Cartridges/13_Raw_Head_Stereo_Digitizer/Tape_Master_Cartridge_Raw_Head_Bottom.pdf

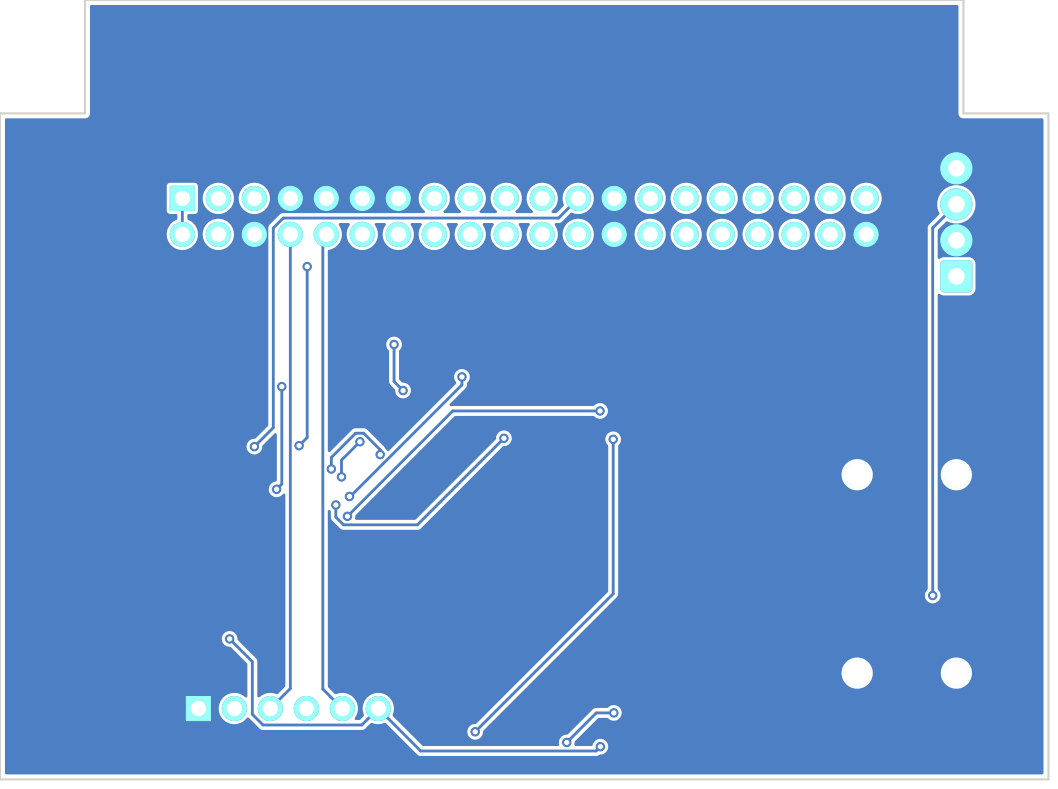
[picture p50: page 1]
