lucedoriente/Tape_Master/kicad/v2/Cartridges/13_Raw_Head_Stereo_Digitizer/Tape_Master_Cartridge_Raw_Head_Top.pdf

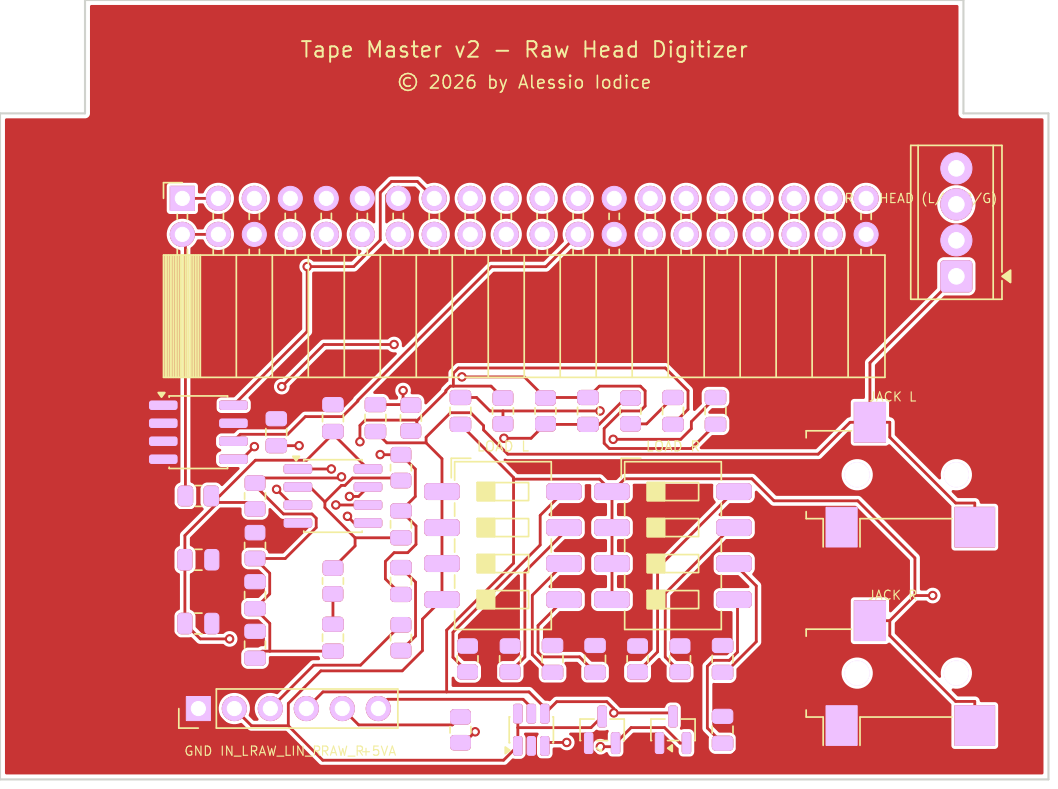
[picture p51: page 1]

IN_RRAW_R+5VA Tape Master v2 - Raw Head Digitizer

þÿ©2026 by Alessio Iodice
