lucedoriente/Tape_Master/kicad/v1/Tape-Master-Schematic.pdf

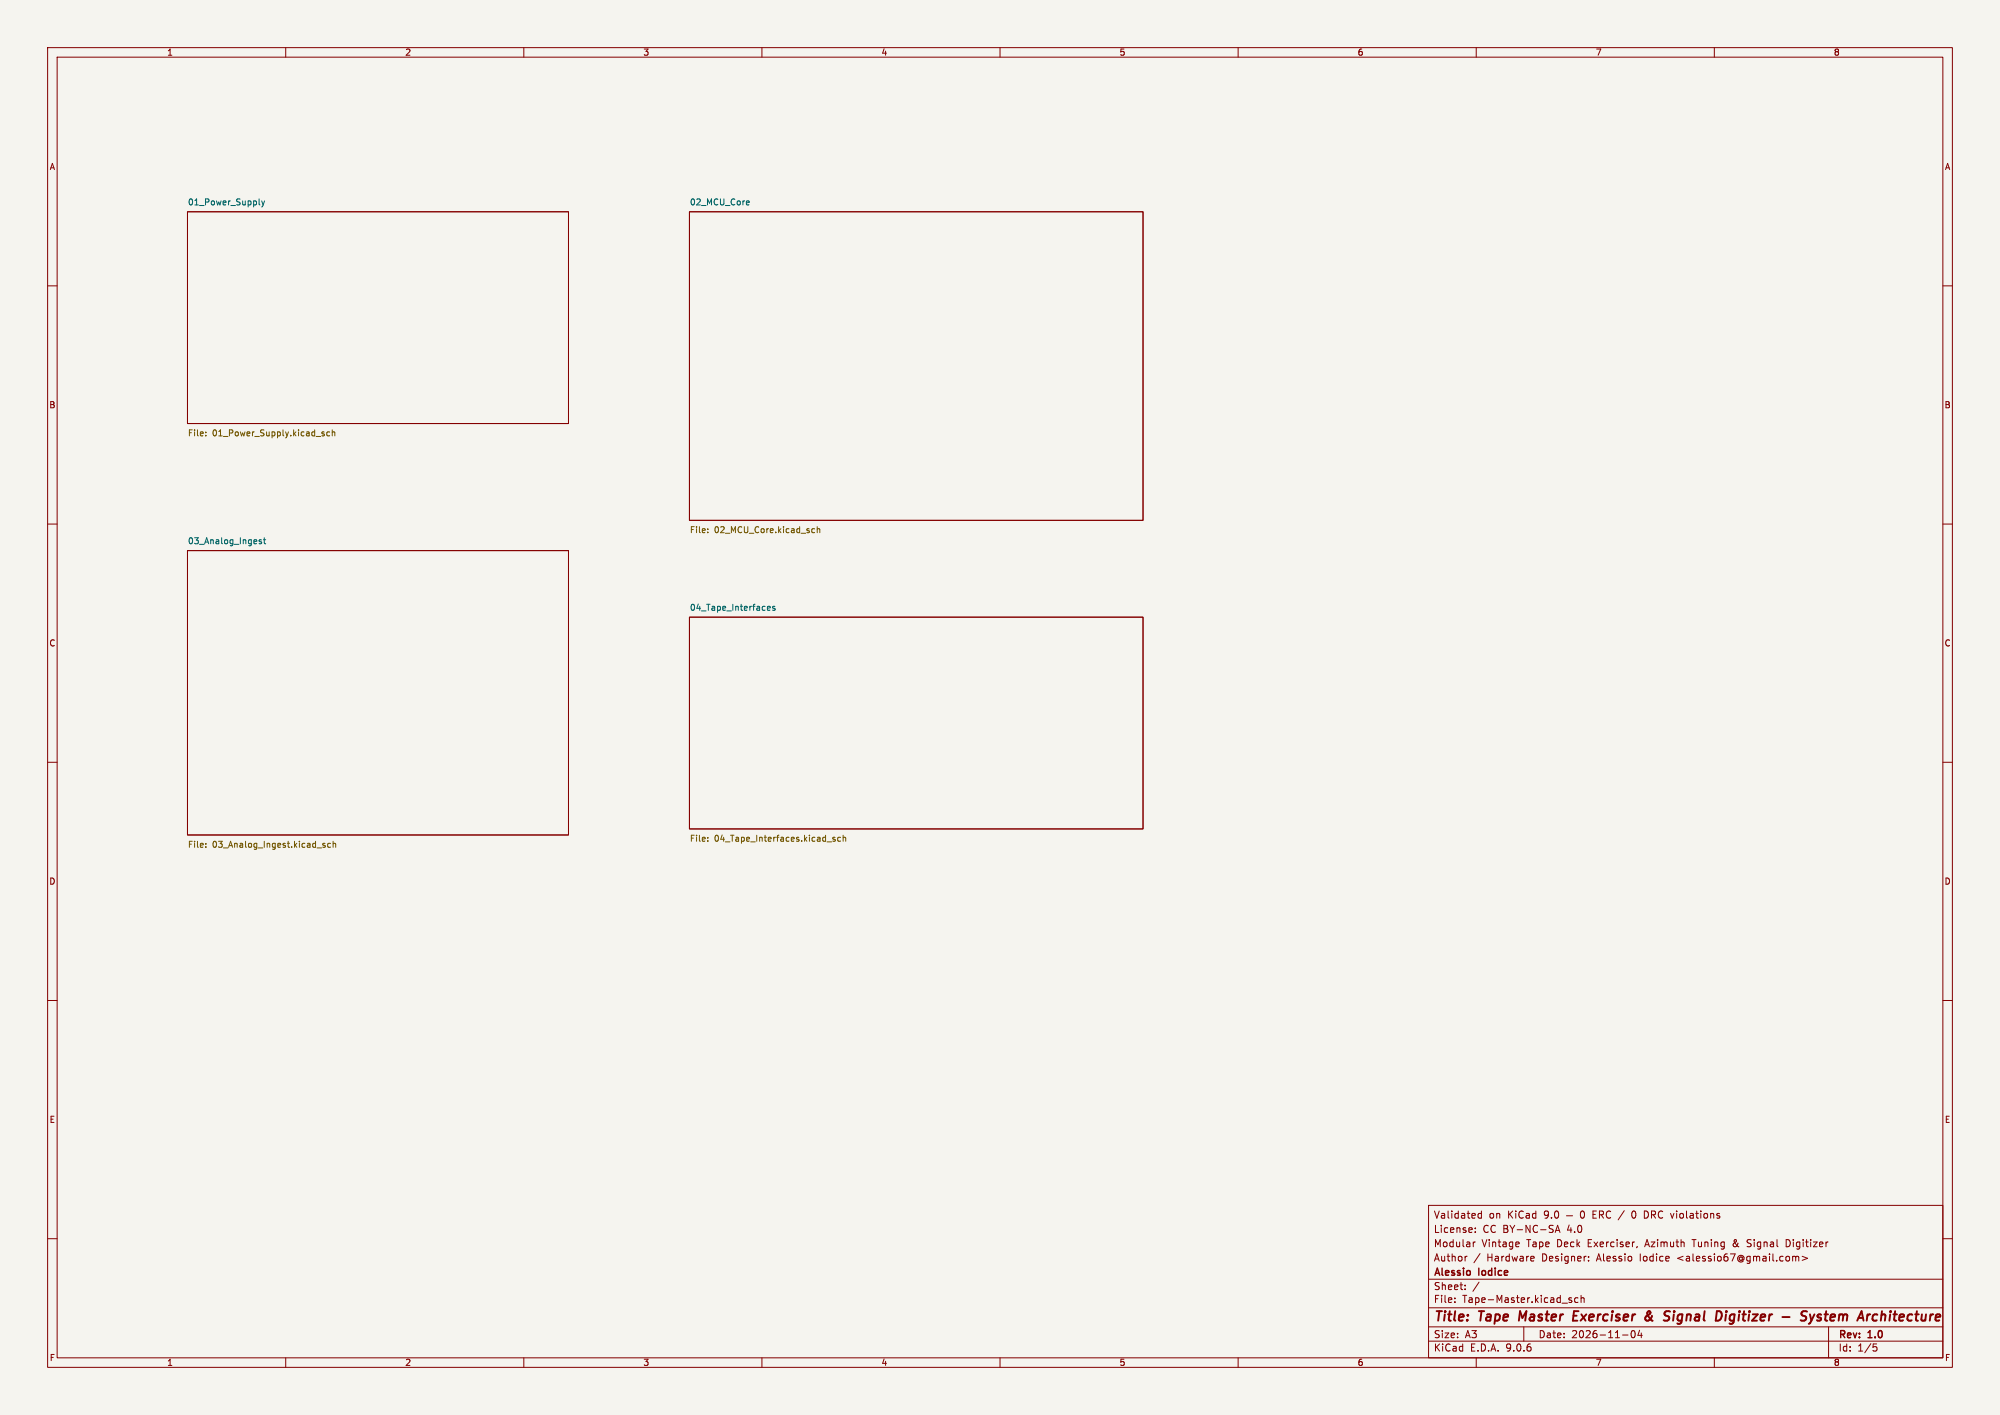
[picture p52: page 1]

Id: 1/5 Title: Tape Master Exerciser & Signal Digitizer - System Architecture

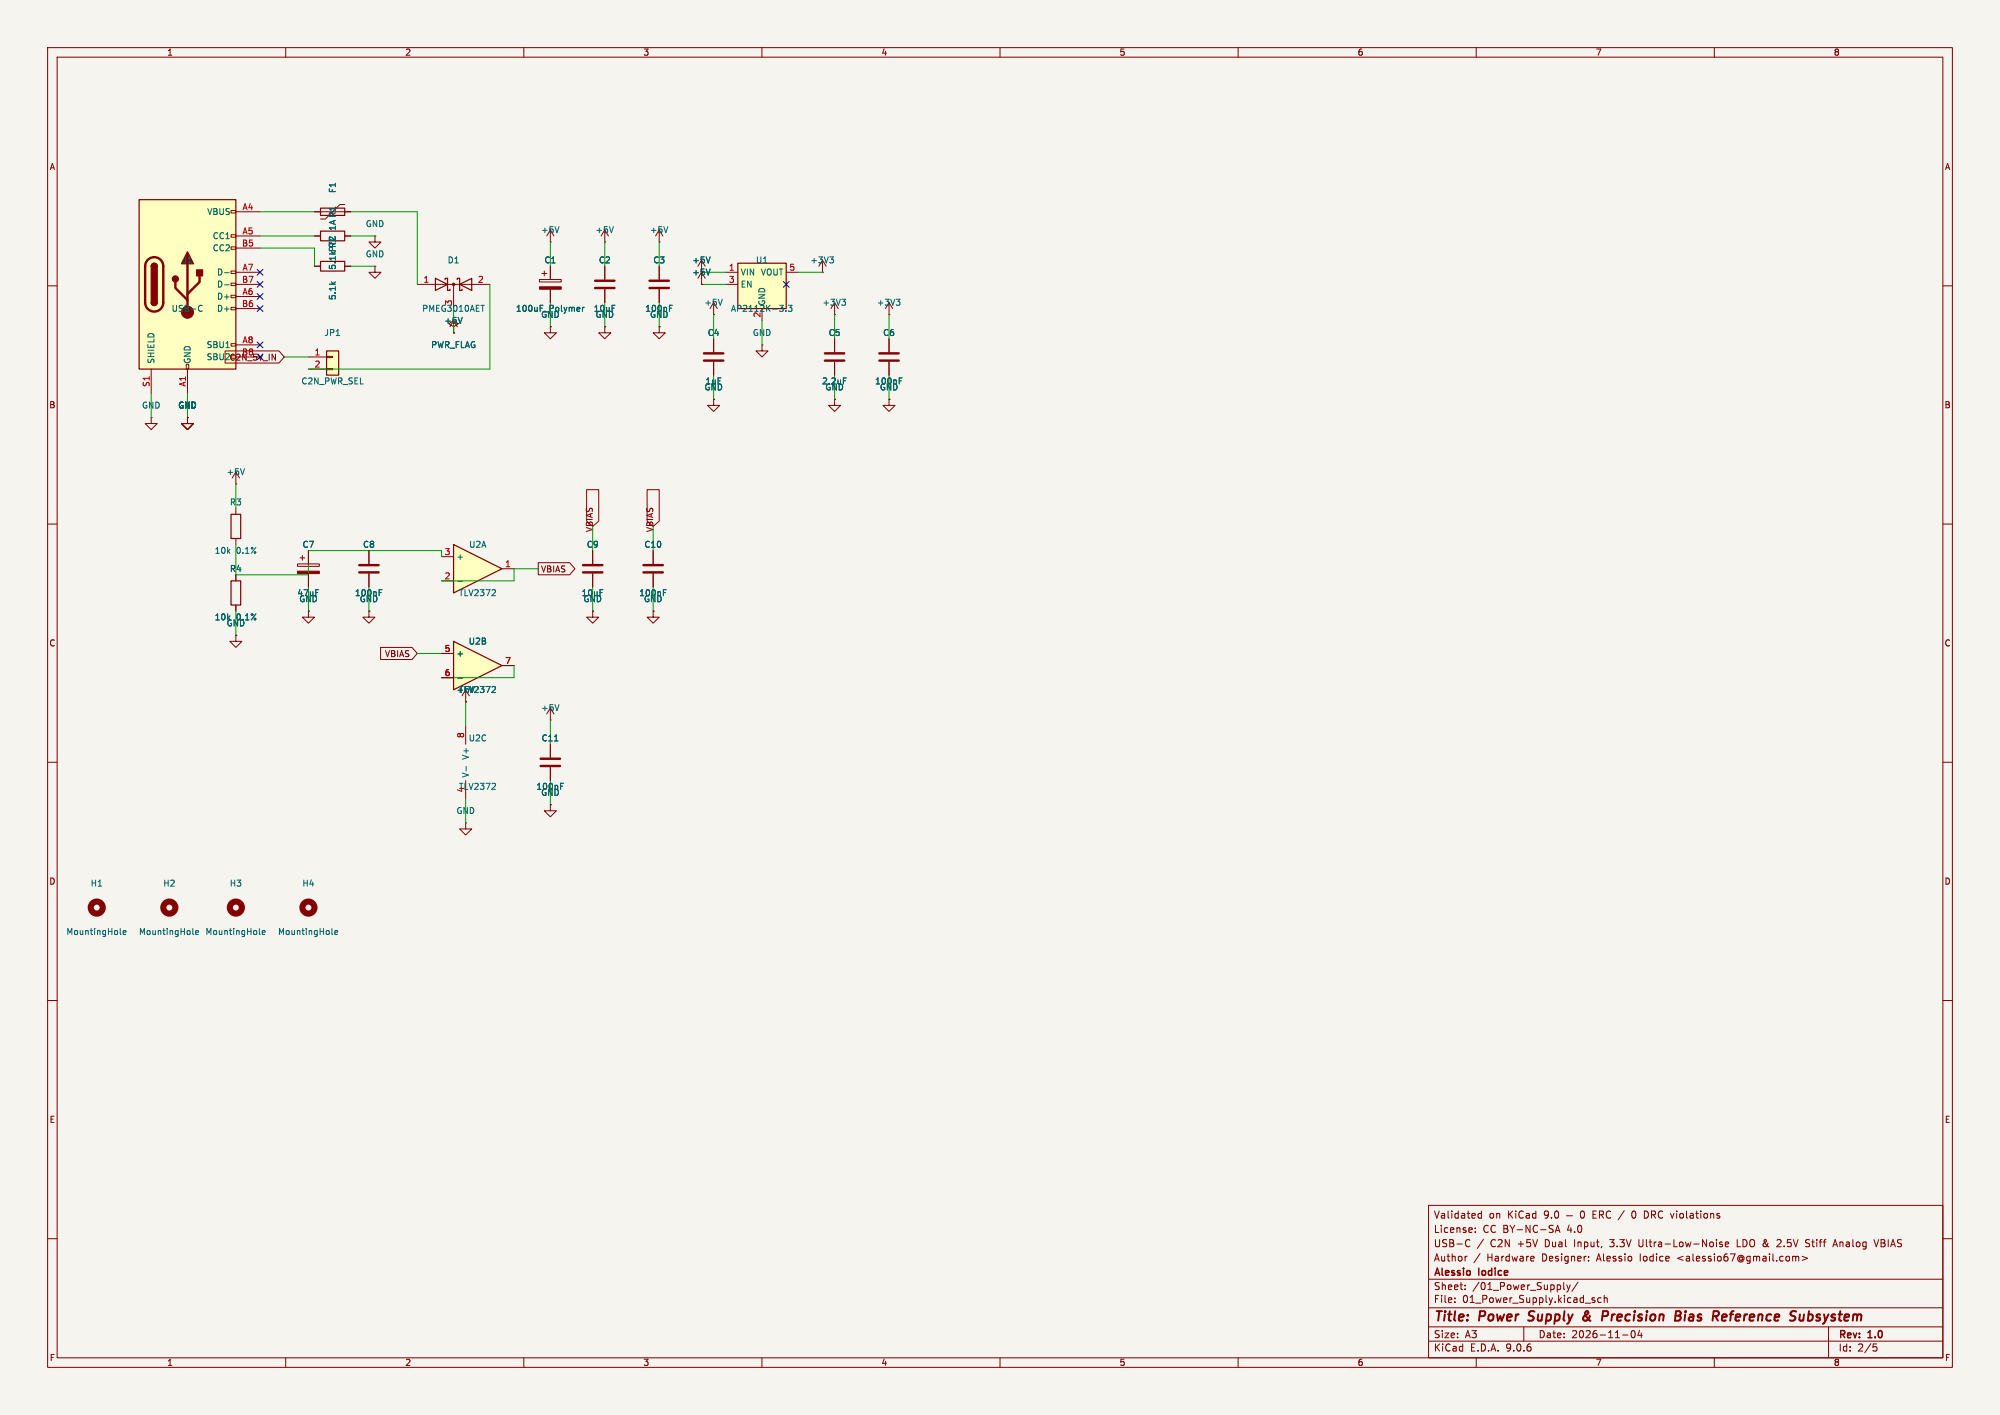
[picture p53: page 2]

Id: 2/5 Title: Power Supply & Precision Bias Reference Subsystem

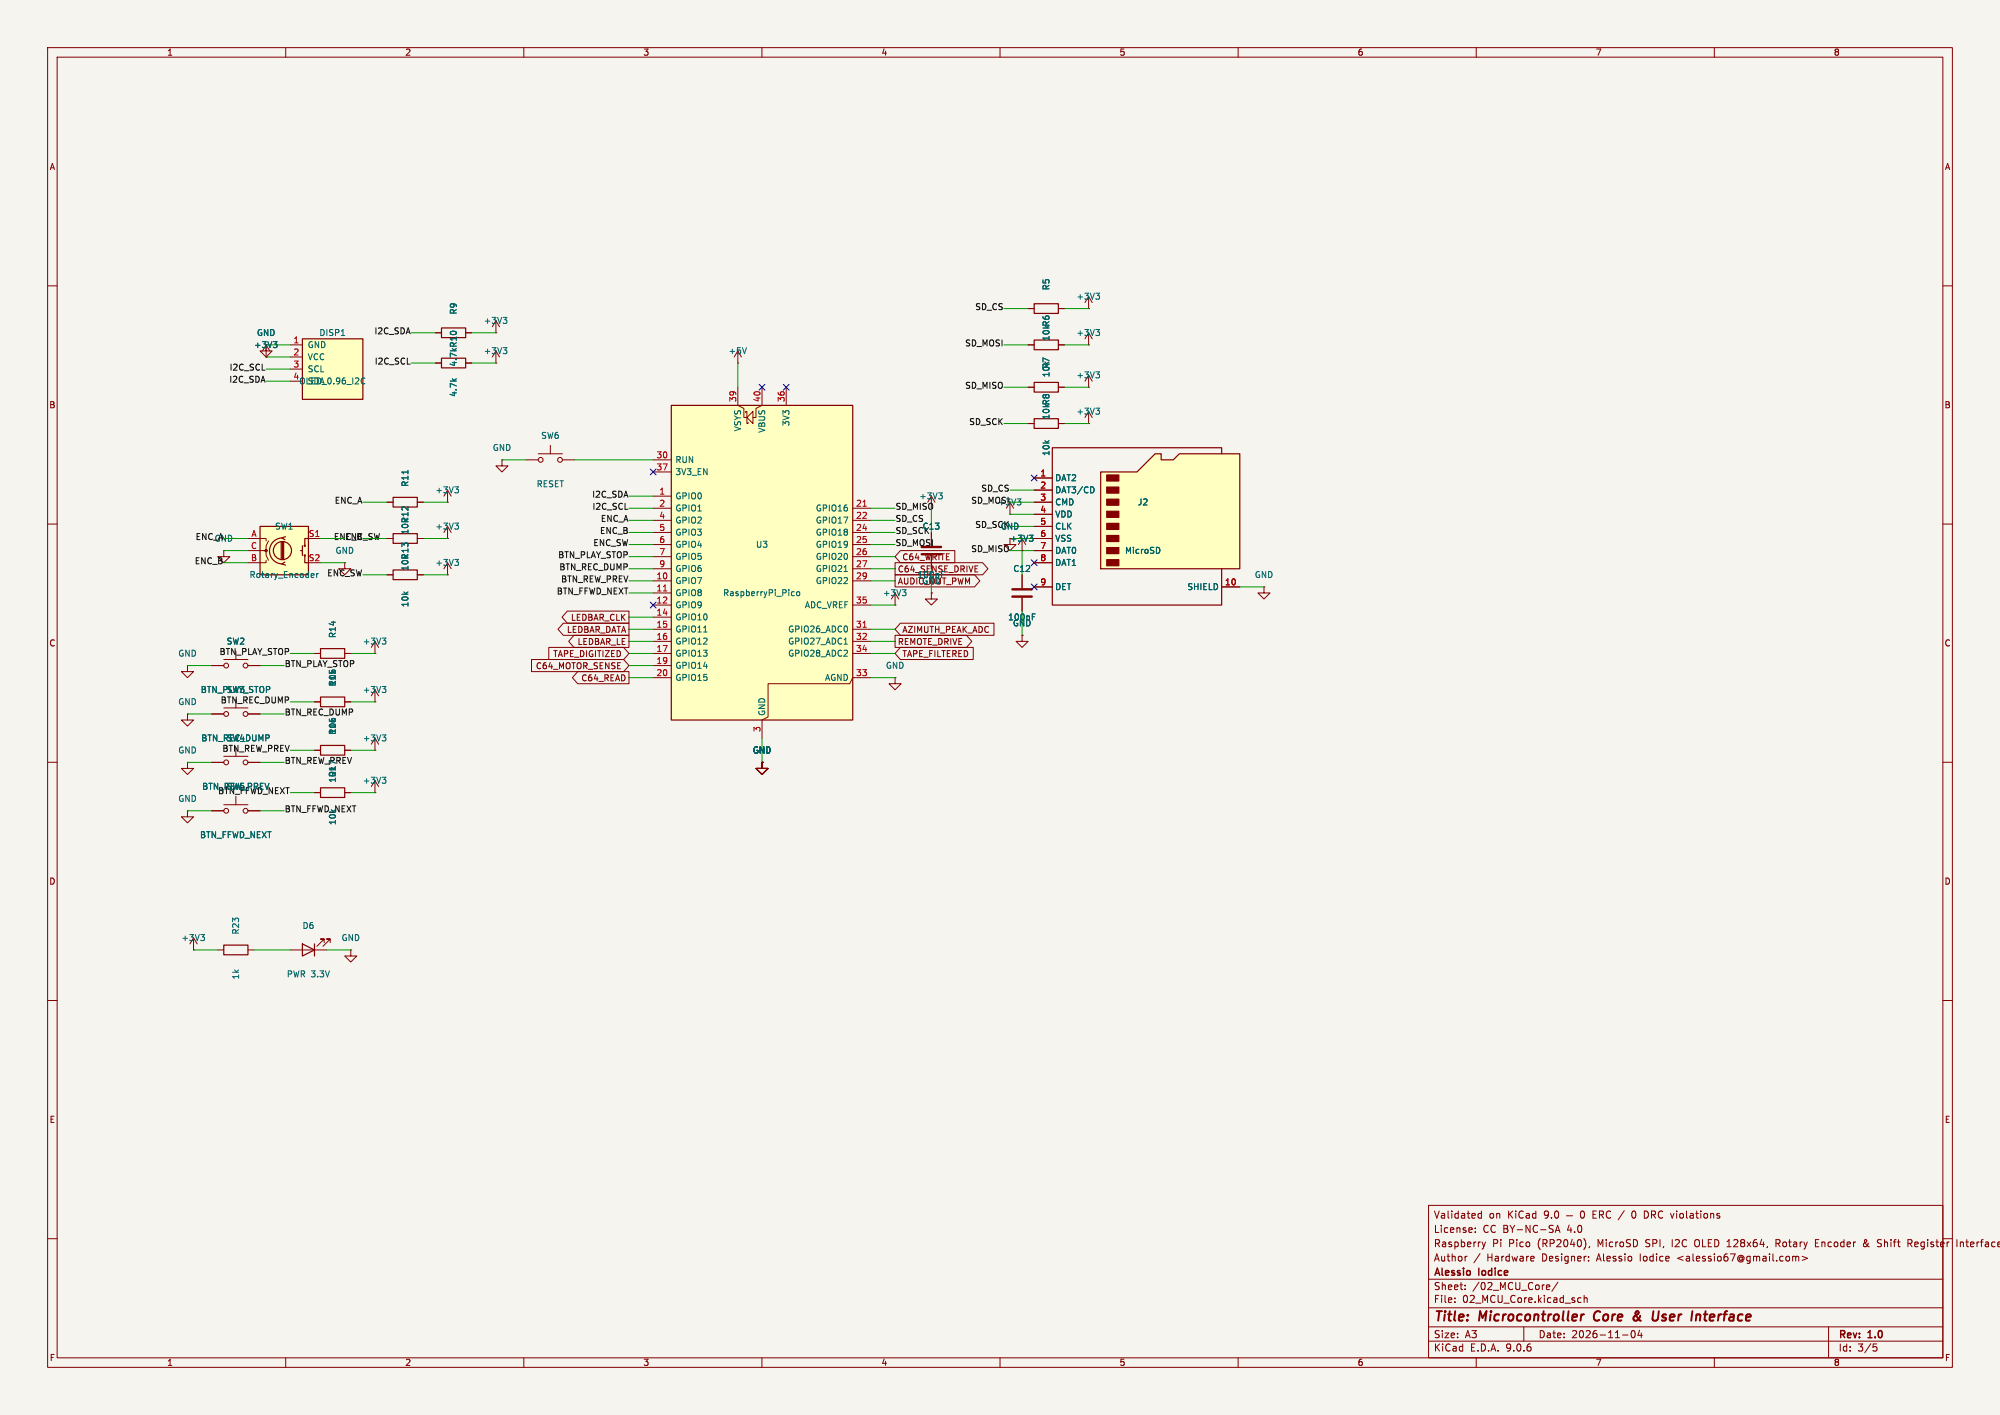
[picture p54: page 3]

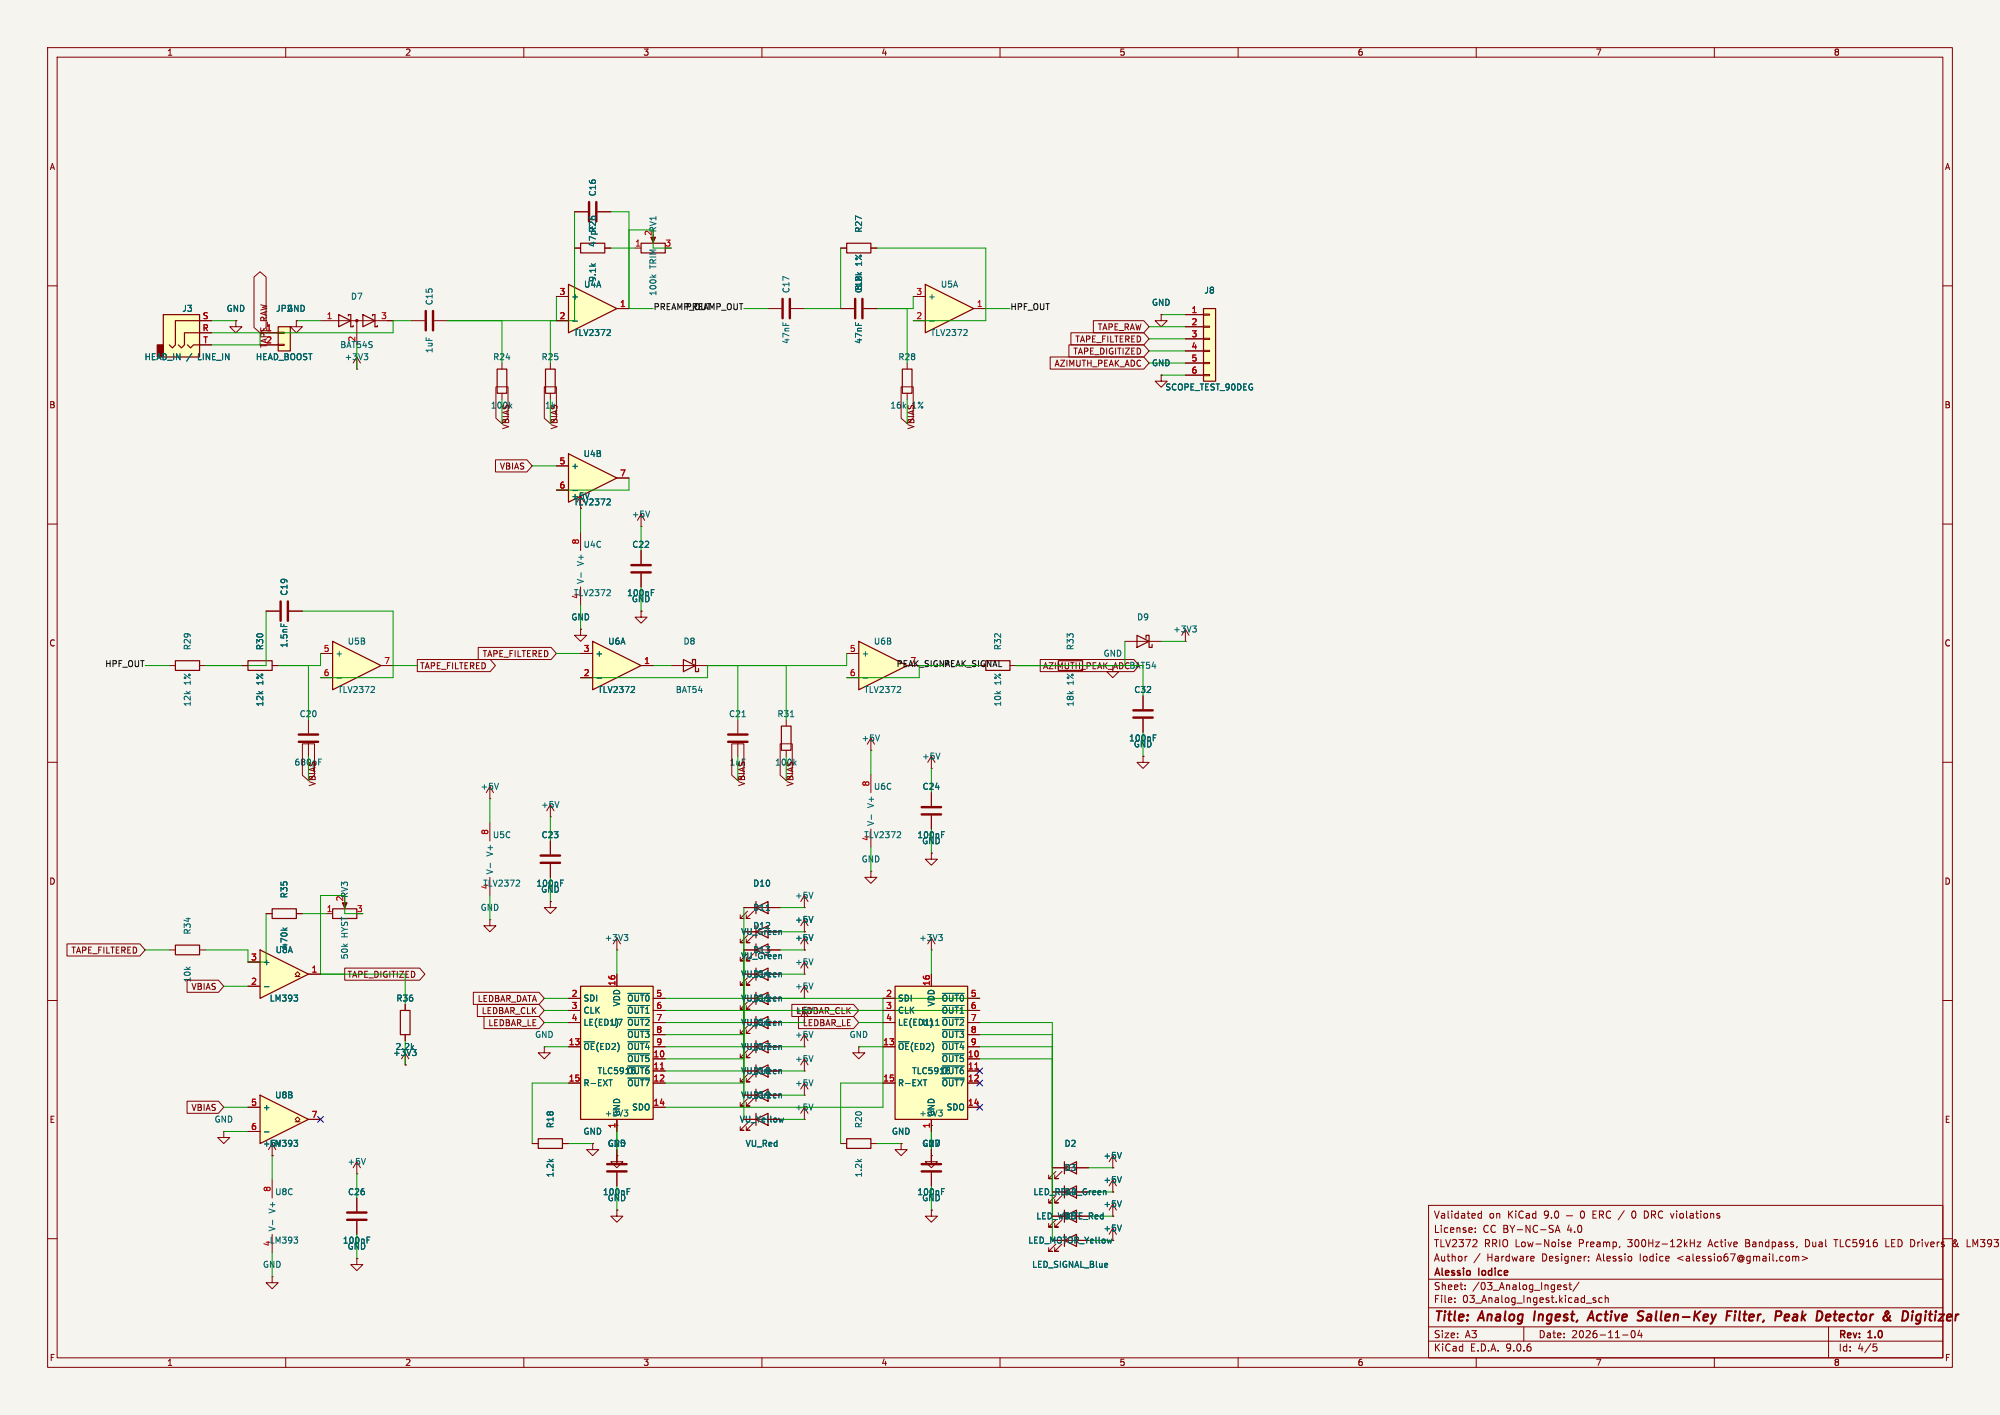
[picture p55: page 4]

GND GND

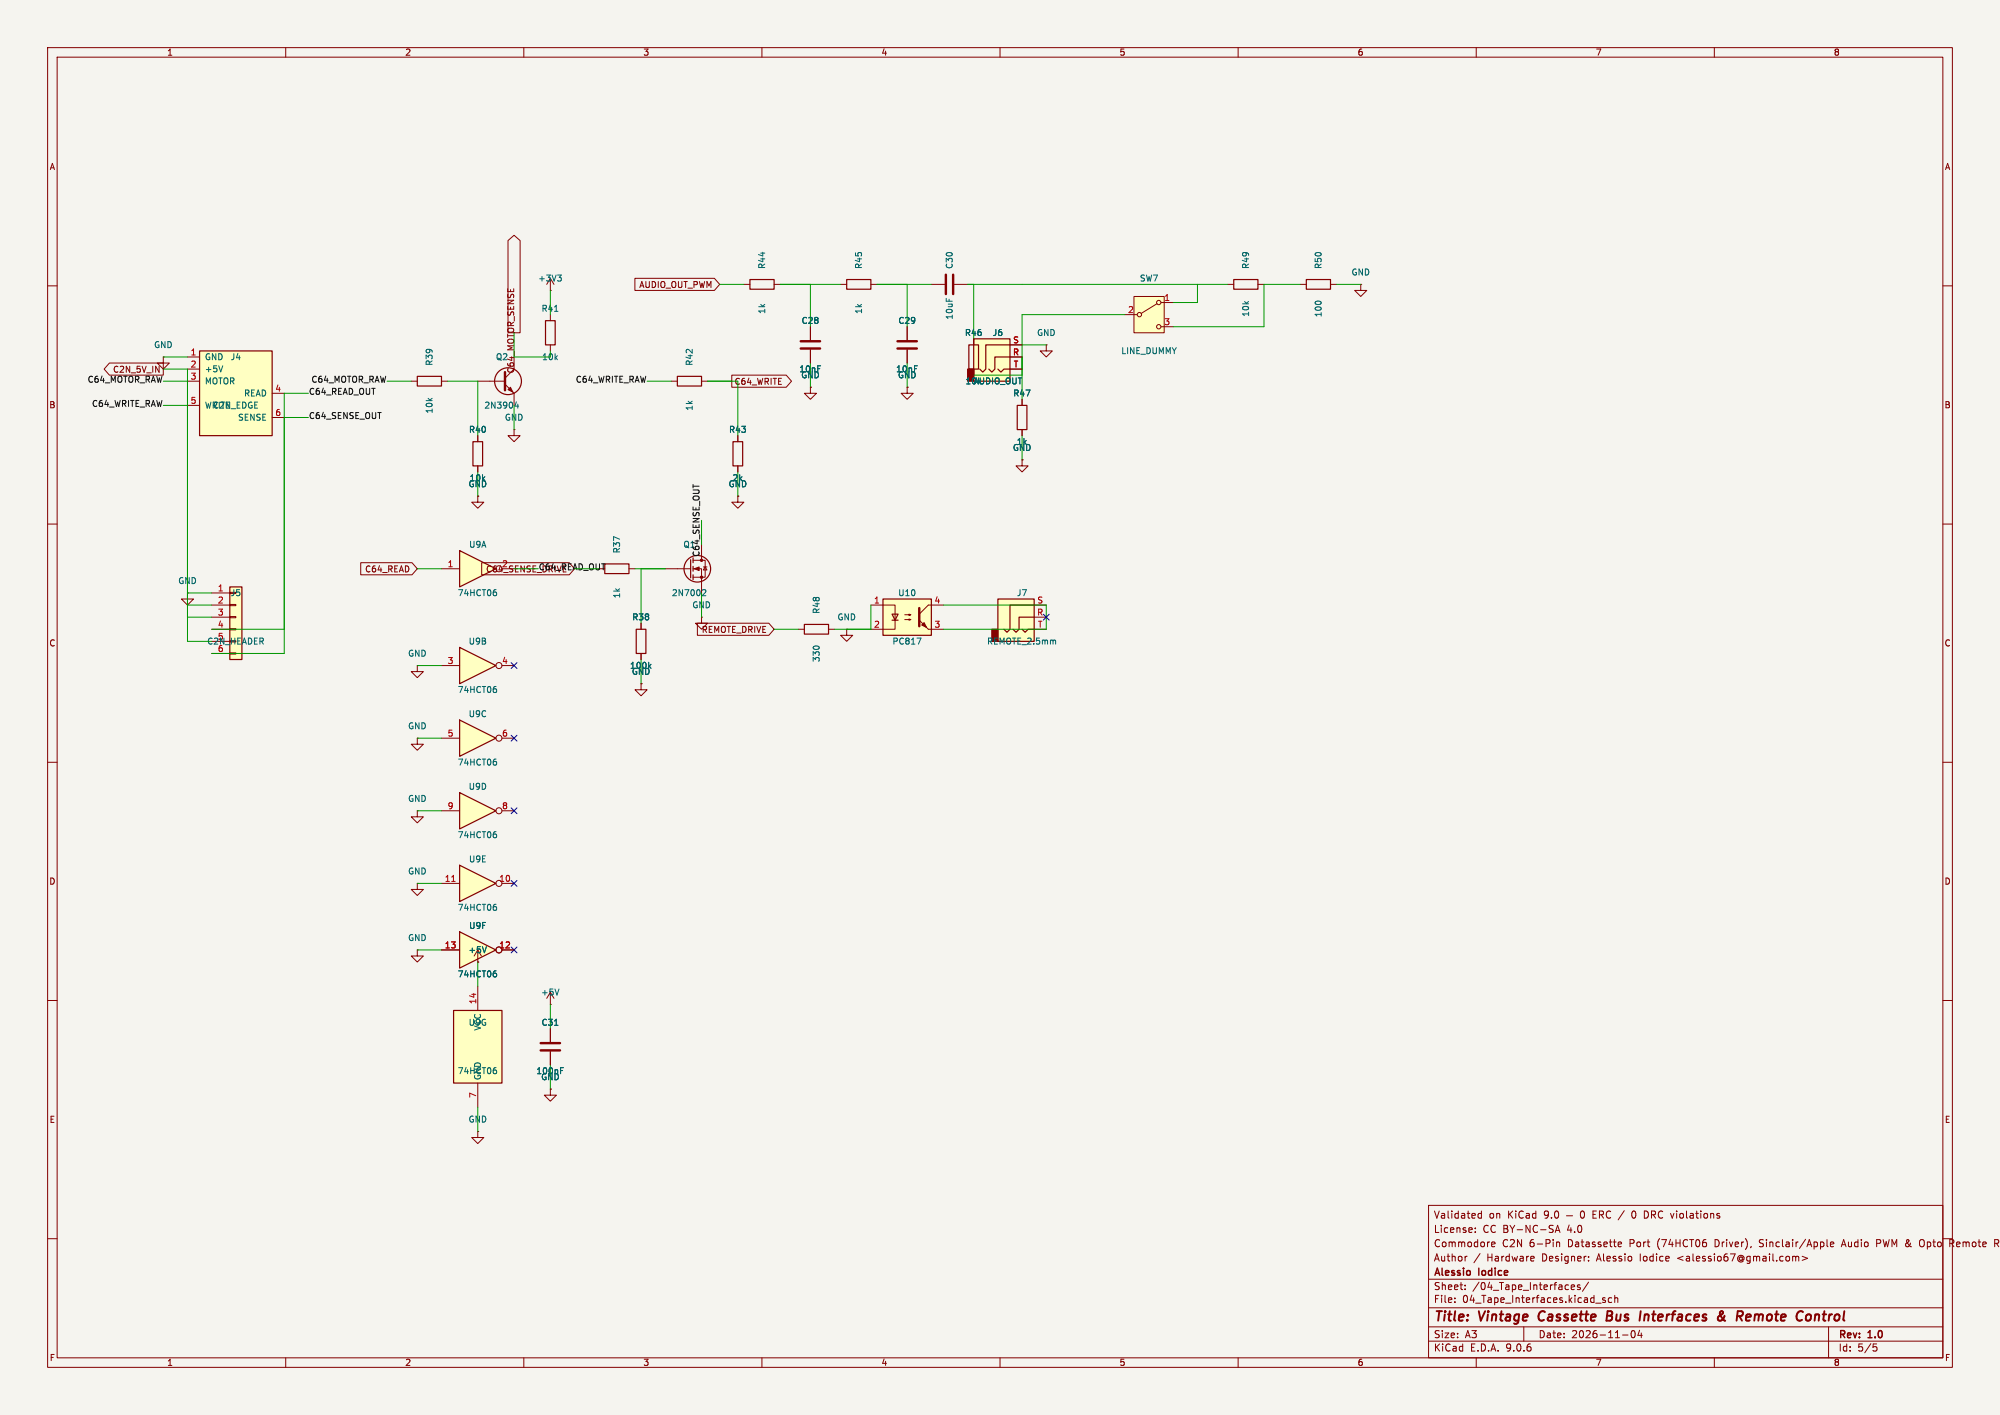
[picture p56: page 5]
