lucedoriente/Tape_Master/kicad/v2/Cartridges/04_Sinclair_ZX_Spectrum/Tape_Master_Cartridge_Sinclair_ZX.kicad_pcb

## KiCad design kicad/v2/Cartridges/04_Sinclair_ZX_Spectrum/Tape_Master_Cartridge_Sinclair_ZX.kicad_pcb (2026-11-07)

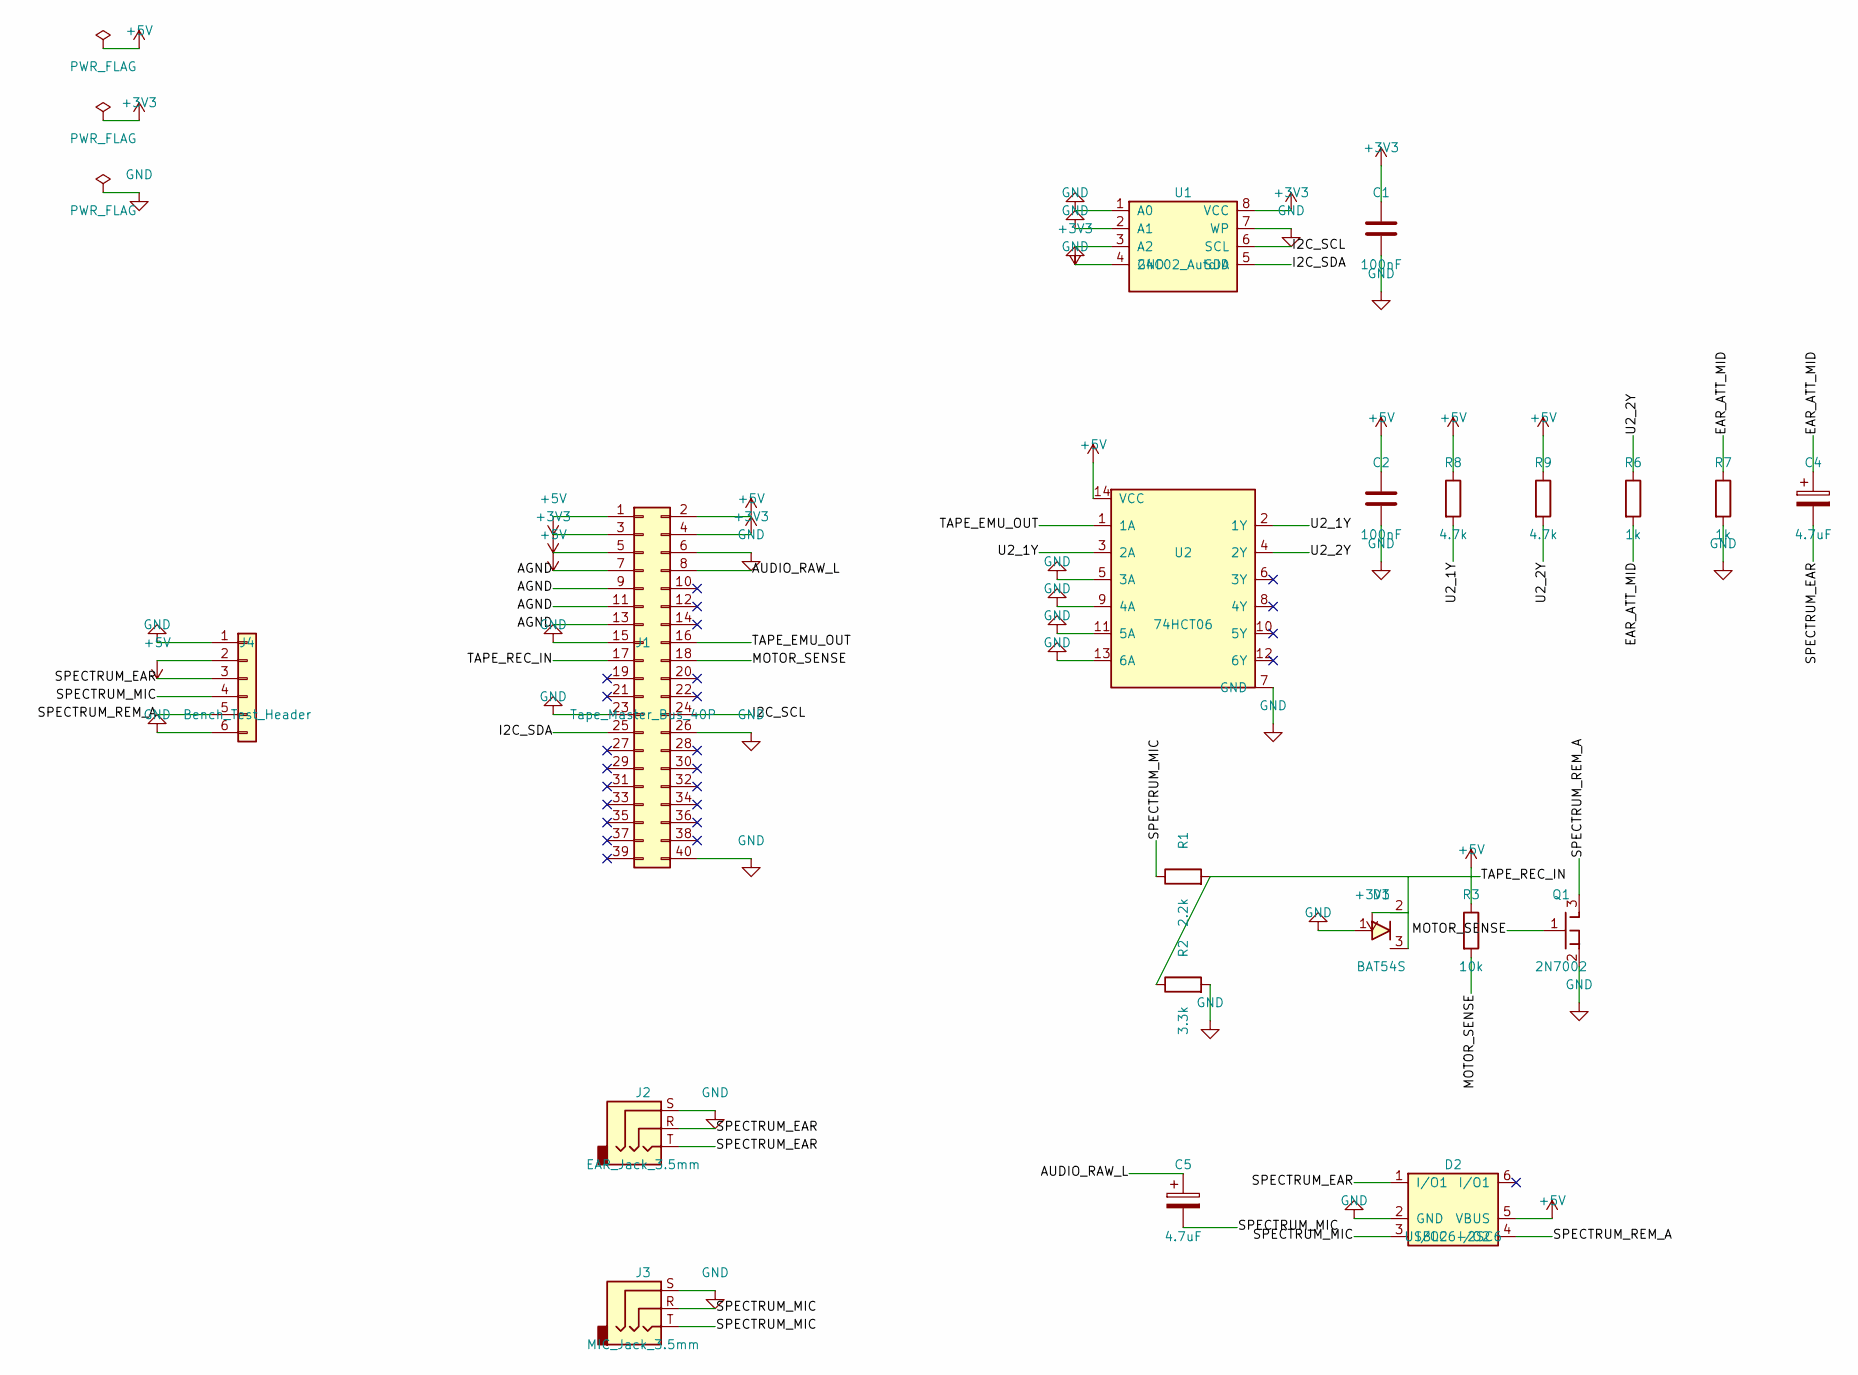
[picture p57: schematic Tape_Master_Cartridge_Sinclair_ZX.kicad_sch, Tape Master Cartridge #04 — Sinclair ZX Spectrum / ZX81 / T…]

Parts:
C1, C2: 100nF; C_0805_2012Metric
C4, C5: 4.7uF; CP_Elec_5x5.4
D1: BAT54S; SOT-23
D2: USBLC6-2SC6; SOT-23-6
J1: Tape_Master_Bus_40P; PinSocket_2x20_P2.54mm_Horizontal_Cartridge
J2: EAR_Jack_3.5mm; Jack_3.5mm_CUI_SJ1-3525N_Horizontal
J3: MIC_Jack_3.5mm; Jack_3.5mm_CUI_SJ1-3525N_Horizontal
J4: Bench_Test_Header; PinHeader_1x06_P2.54mm_Vertical
Q1: 2N7002; SOT-23
R1: 2.2k; R_0805_2012Metric
R2: 3.3k; R_0805_2012Metric
R3: 10k; R_0805_2012Metric
R6, R7: 1k; R_0805_2012Metric
R8, R9: 4.7k; R_0805_2012Metric
U1: 24C02_AutoID; SOIC-8_3.9x4.9mm_P1.27mm
U2: 74HCT06; SOIC-14_3.9x8.7mm_P1.27mm

Connections:
+3V3: C1.1, D1.2 (C2), J1.3, J1.4, U1.3 (A2), U1.8 (VCC)
+5V: C2.1, D2.5 (VBUS), J1.1, J1.2, J1.5, J4.2, R3.1, R8.1, R9.1, U2.14 (VCC)
/AGND: J1.7, J1.9, J1.11, J1.13
/AUDIO_RAW_L: C5.1, J1.8
/EAR_ATT_MID: C4.1, R6.2, R7.1
/I2C_SCL: J1.24, U1.6 (SCL)
/I2C_SDA: J1.25, U1.5 (SDA)
/MOTOR_SENSE: J1.18, Q1.1 (G), R3.2
/SPECTRUM_EAR: C4.2, D2.1 (I/O1), J2.R, J2.T, J4.3
/SPECTRUM_MIC: C5.2, D2.3 (I/O2), J3.R, J3.T, J4.4, R1.1
/SPECTRUM_REM_A: D2.4 (I/O2), J4.5, Q1.3 (D)
/TAPE_EMU_OUT: J1.16, U2.1 (1A)
/TAPE_REC_IN: D1.3 (C1A2), J1.17, R1.2, R2.1
/U2_1Y: R8.2, U2.2 (1Y), U2.3 (2A)
/U2_2Y: R6.1, R9.2, U2.4 (2Y)
GND: C1.2, C2.2, D1.1 (A1), D2.2 (GND), J1.6, J1.15, J1.23, J1.26, J1.40, J2.S, J3.S, J4.1, J4.6, Q1.2 (S), R2.2, R7.2, U1.1 (A0), U1.2 (A1), U1.4 (GND), U1.7 (WP), U2.5 (3A), U2.7 (GND), U2.9 (4A), U2.11 (5A), U2.13 (6A)

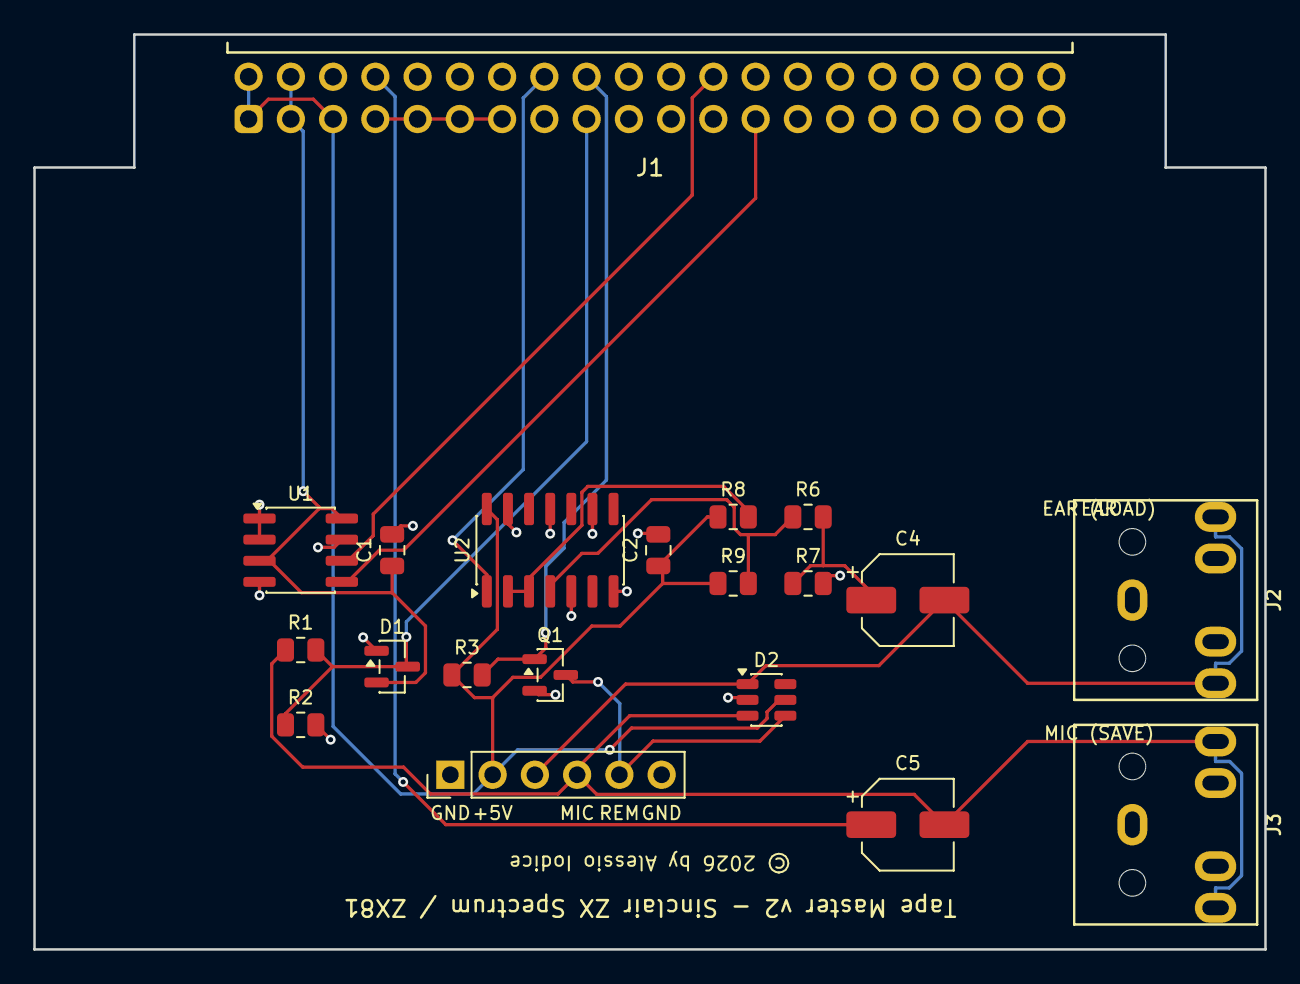
[picture p58: board Tape_Master_Cartridge_Sinclair_ZX.kicad_pcb from above]

Board: 2 copper layers, 74.0 x 55.0 mm, 20 parts (0 on the bottom side), 16 nets.
