lucedoriente/Tape_Master/kicad/v2/Cartridges/13_Raw_Head_Stereo_Digitizer/Tape_Master_Cartridge_Raw_Head.kicad_pcb

## KiCad design kicad/v2/Cartridges/13_Raw_Head_Stereo_Digitizer/Tape_Master_Cartridge_Raw_Head.kicad_pcb (2026-11-07)

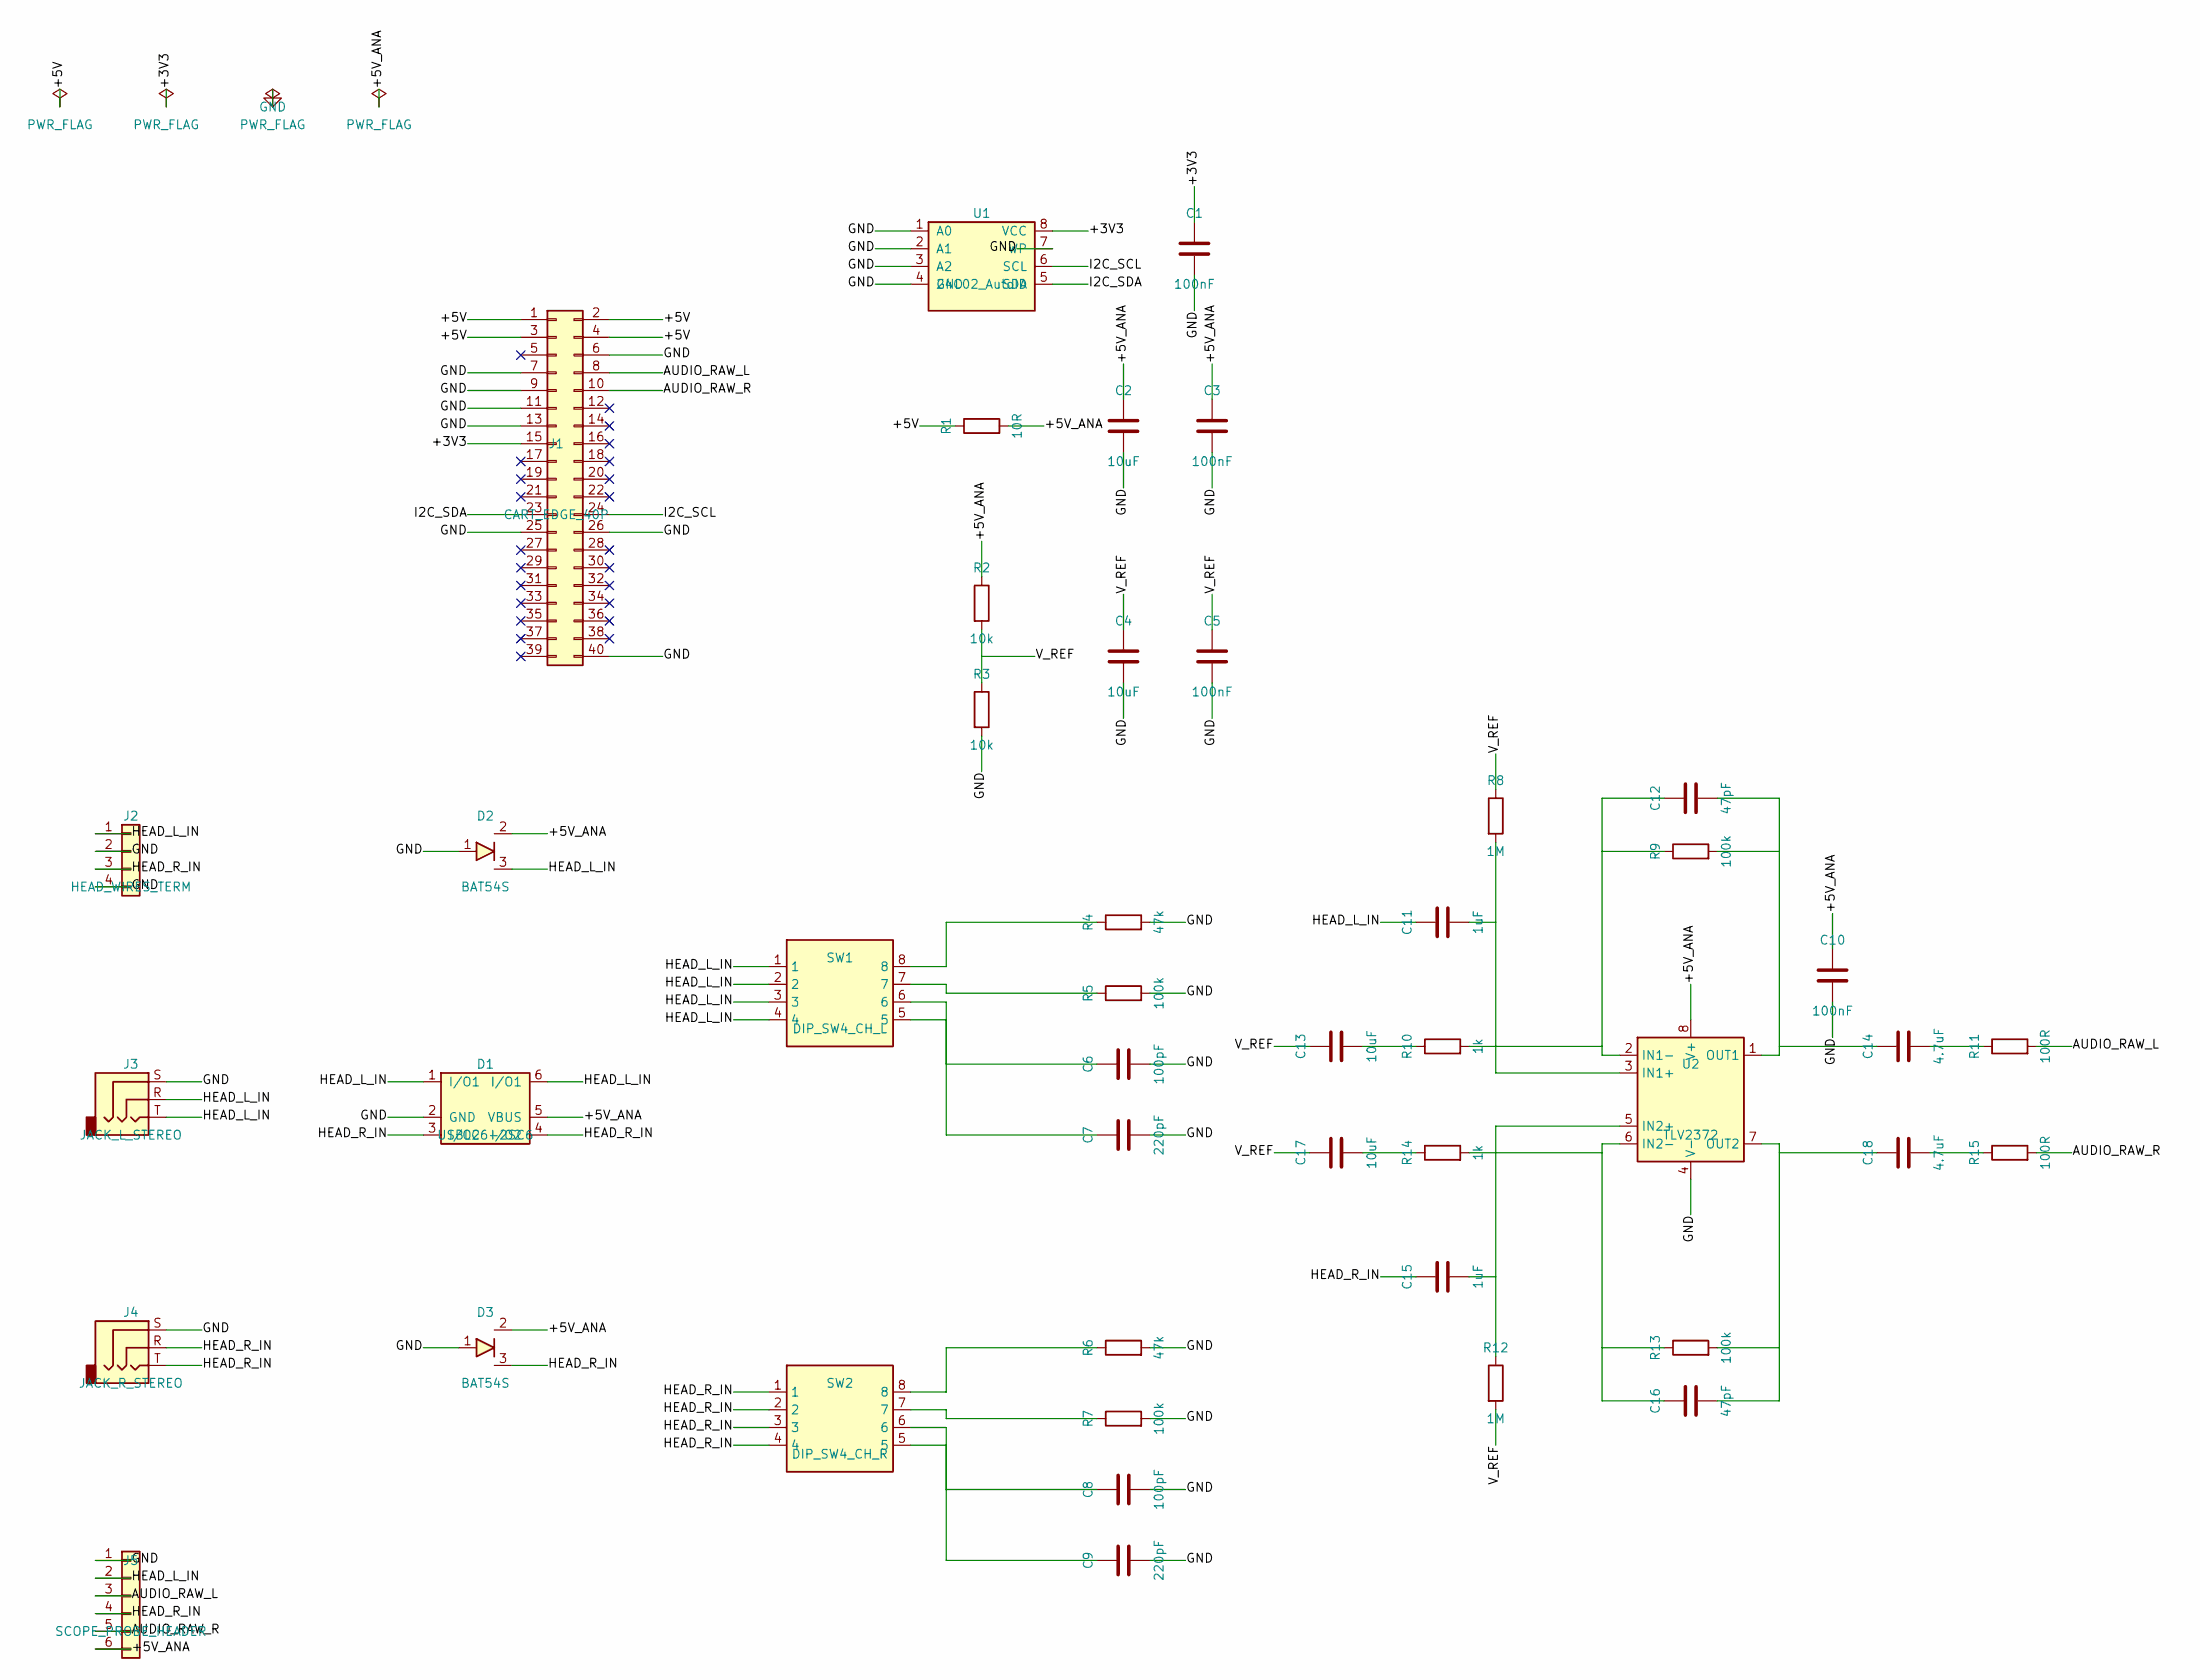
[picture p59: schematic Tape_Master_Cartridge_Raw_Head.kicad_sch, Tape Master Cartridge #13 — Raw Head Probing & Stereo Digit…]

Parts:
C1, C3, C5, C10: 100nF; C_0805_2012Metric
C2, C4, C13, C17: 10uF; C_0805_2012Metric
C6, C8: 100pF; C_0805_2012Metric
C7, C9: 220pF; C_0805_2012Metric
C11, C15: 1uF; C_0805_2012Metric
C12, C16: 47pF; C_0805_2012Metric
C14, C18: 4.7uF; C_0805_2012Metric
D1: USBLC6-2SC6; SOT-23-6
D2, D3: BAT54S; SOT-23
J1: CART_EDGE_40P; PinSocket_2x20_P2.54mm_Horizontal_Cartridge
J2: HEAD_WIRES_TERM; TerminalBlock_Phoenix_MPT-0,5-4-2.54_1x04_P2.54mm_Horizontal
J3: JACK_L_STEREO; Jack_3.5mm_CUI_SJ-3523-SMT_Horizontal
J4: JACK_R_STEREO; Jack_3.5mm_CUI_SJ-3523-SMT_Horizontal
J5: SCOPE_PROBE_HEADER; PinHeader_1x06_P2.54mm_Vertical
R1: 10R; R_0805_2012Metric
R2, R3: 10k; R_0805_2012Metric
R4, R6: 47k; R_0805_2012Metric
R5, R7, R9, R13: 100k; R_0805_2012Metric
R8, R12: 1M; R_0805_2012Metric
R10, R14: 1k; R_0805_2012Metric
R11, R15: 100R; R_0805_2012Metric
SW1: DIP_SW4_CH_L; SW_DIP_SPSTx04_Slide_6.7x11.72mm_W8.61mm_P2.54mm_LowProfile
SW2: DIP_SW4_CH_R; SW_DIP_SPSTx04_Slide_6.7x11.72mm_W8.61mm_P2.54mm_LowProfile
U1: 24C02_AutoID; SOIC-8_3.9x4.9mm_P1.27mm
U2: TLV2372; SOIC-8_3.9x4.9mm_P1.27mm

Connections:
/+3V3: C1.1, J1.15, U1.8 (VCC)
/+5V: J1.1, J1.2, J1.3, J1.4, R1.1
/+5V_ANA: C2.1, C3.1, C10.1, D1.5 (VBUS), D2.2 (C2), D3.2 (C2), J5.6, R1.2, R2.1, U2.8 (V+)
/AUDIO_RAW_L: J1.8, J5.3, R11.2
/AUDIO_RAW_R: J1.10, J5.5, R15.2
/HEAD_L_IN: C11.1, D1.1 (I/O1), D1.6 (I/O1), D2.3 (C1A2), J2.1, J3.R, J3.T, J5.2, SW1.1, SW1.2, SW1.3, SW1.4
/HEAD_R_IN: C15.1, D1.3 (I/O2), D1.4 (I/O2), D3.3 (C1A2), J2.3, J4.R, J4.T, J5.4, SW2.1, SW2.2, SW2.3, SW2.4
/I2C_SCL: J1.24, U1.6 (SCL)
/I2C_SDA: J1.23, U1.5 (SDA)
/V_REF: C4.1, C5.1, C13.1, C17.1, R2.2, R3.1, R8.1, R12.2
GND: C1.2, C2.2, C3.2, C4.2, C5.2, C6.2, C7.2, C8.2, C9.2, C10.2, D1.2 (GND), D2.1 (A1), D3.1 (A1), J1.6, J1.7, J1.9, J1.11, J1.13, J1.25, J1.26, J1.40, J2.2, J2.4, J3.S, J4.S, J5.1, R3.2, R4.2, R5.2, R6.2, R7.2, U1.1 (A0), U1.2 (A1), U1.3 (A2), U1.4 (GND), U1.7 (WP), U2.4 (V-)
unnamed: C6.1, SW1.6
unnamed: C7.1, SW1.5
unnamed: C8.1, SW2.6
unnamed: C9.1, SW2.5
unnamed: C13.2, R10.1
unnamed: C14.2, R11.1
unnamed: C17.2, R14.1
unnamed: C18.2, R15.1
unnamed: R4.1, SW1.8
unnamed: R5.1, SW1.7
unnamed: R6.1, SW2.8
unnamed: R7.1, SW2.7
unnamed: C11.2, R8.2, U2.3 (IN1+)
unnamed: C12.1, R9.1, R10.2, U2.2 (IN1-)
unnamed: C15.2, R12.1, U2.5 (IN2+)
unnamed: C16.1, R13.1, R14.2, U2.6 (IN2-)
unnamed: C12.2, C14.1, R9.2, U2.1 (OUT1)
unnamed: C16.2, C18.1, R13.2, U2.7 (OUT2)

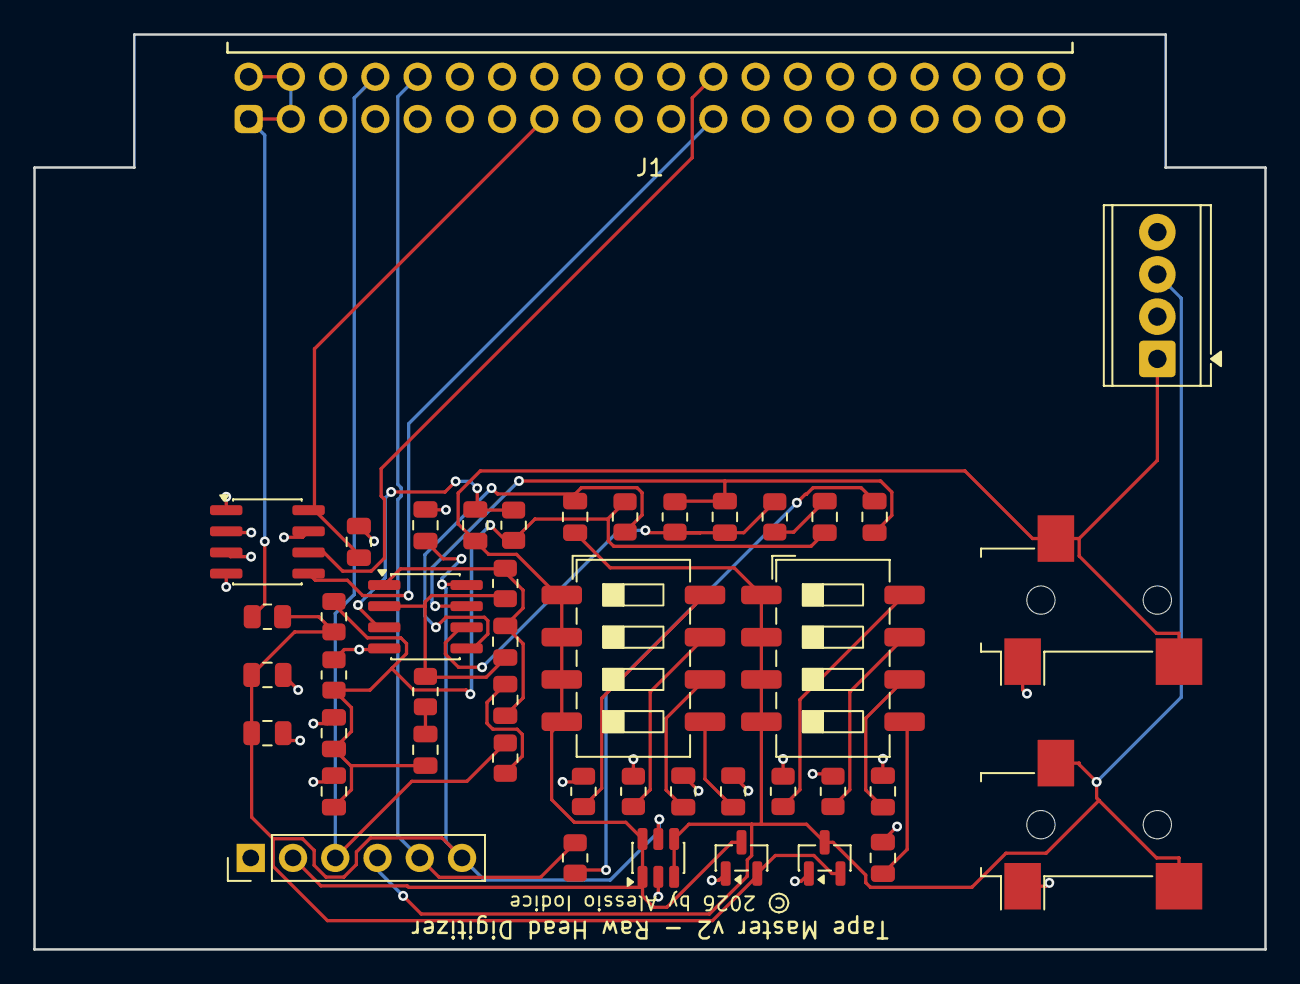
[picture p60: board Tape_Master_Cartridge_Raw_Head.kicad_pcb from above]

Board: 2 copper layers, 74.0 x 55.0 mm, 45 parts (0 on the bottom side), 29 nets.
