lucedoriente/Tape_Master/kicad/v2/Cartridges/09_TI99_4A/Tape_Master_Cartridge_TI99.kicad_pcb

## KiCad design kicad/v2/Cartridges/09_TI99_4A/Tape_Master_Cartridge_TI99.kicad_pcb (2026-11-07)

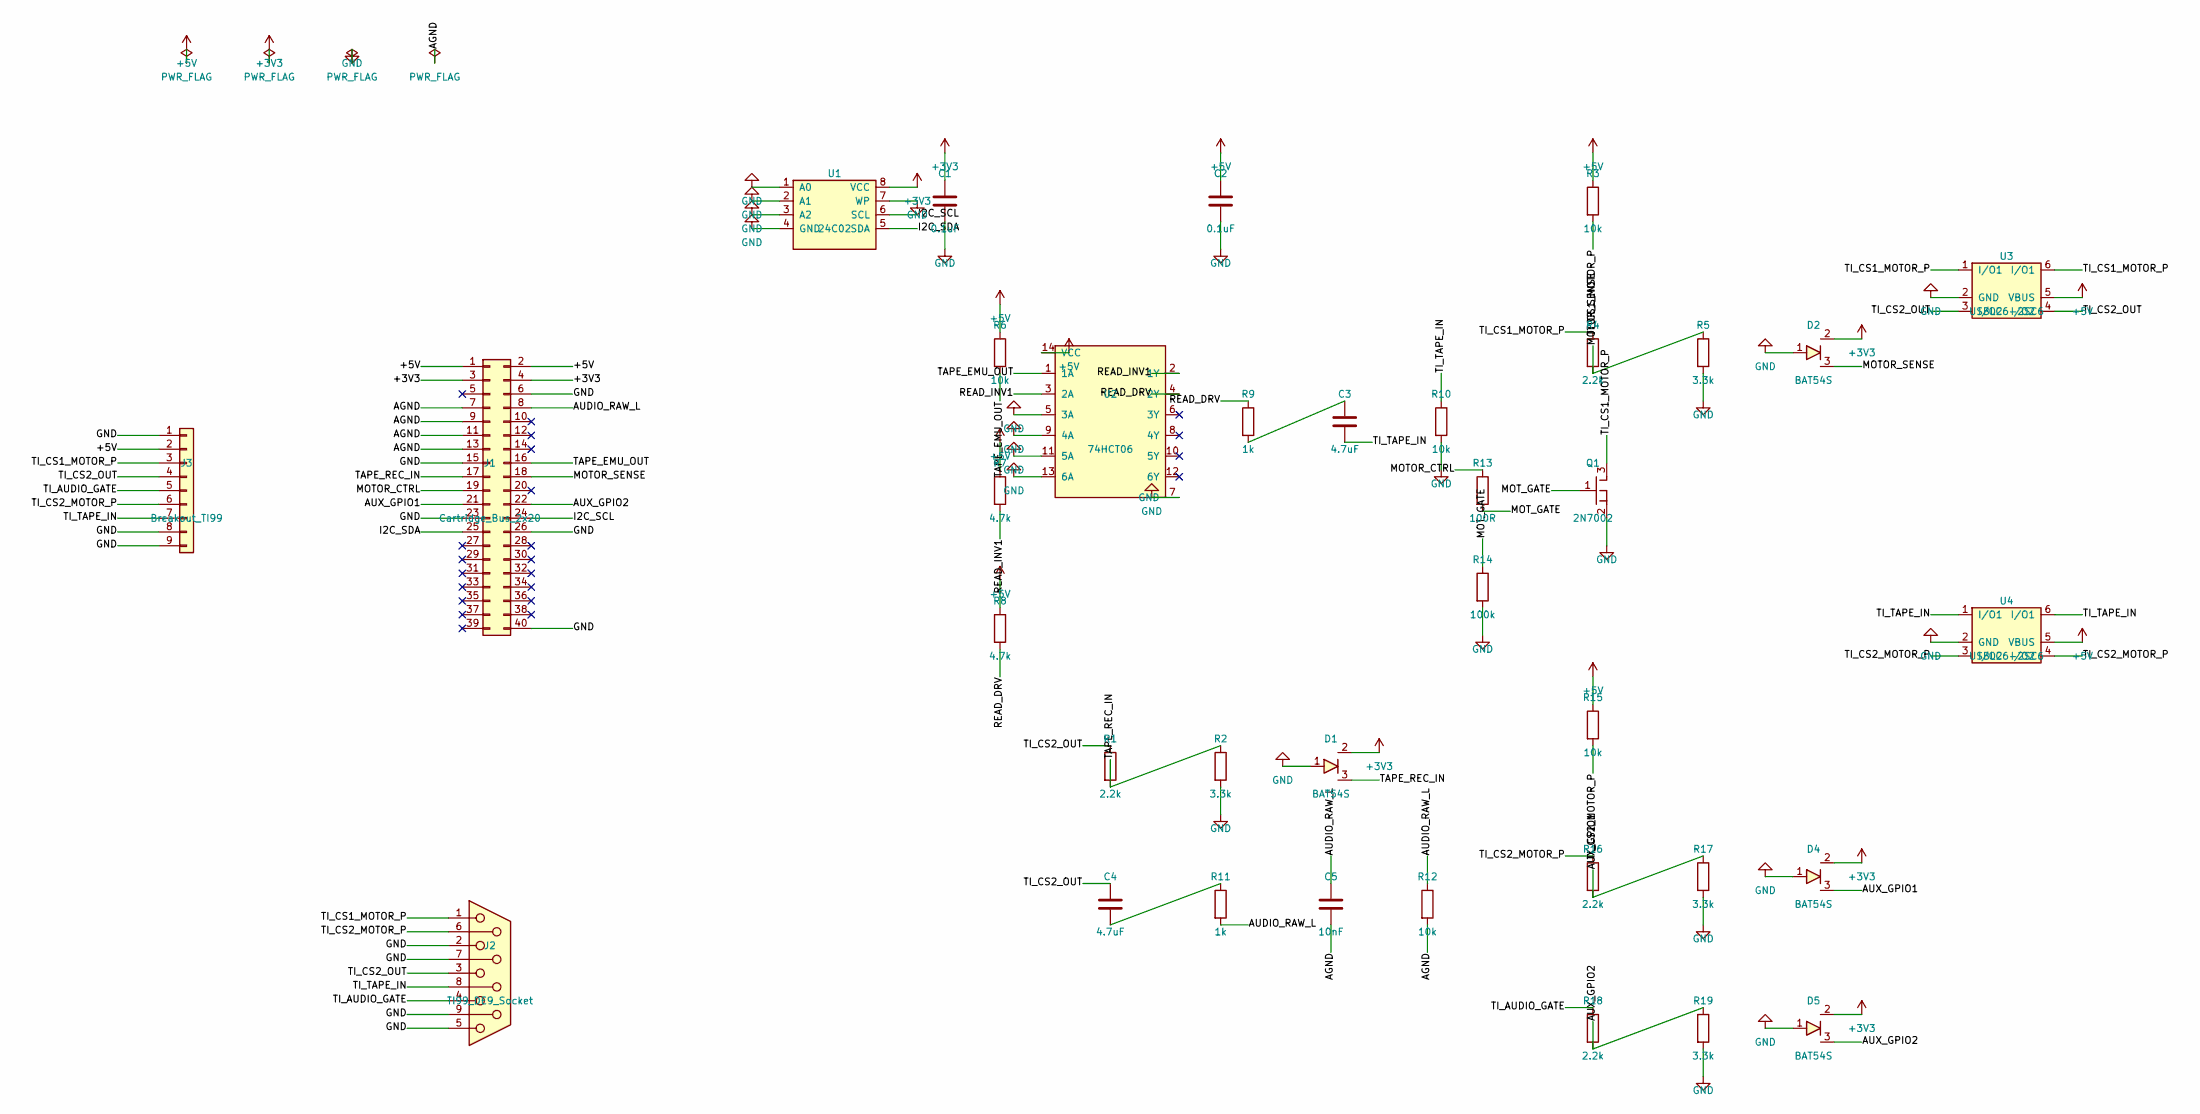
[picture p61: schematic Tape_Master_Cartridge_TI99.kicad_sch, Tape Master v2 - Cartridge 09: Texas Instruments TI-99/4A]

Parts:
C1, C2: 0.1uF; C_0805_2012Metric
C3, C4: 4.7uF; C_0805_2012Metric
C5: 10nF; C_0805_2012Metric
D1, D2, D4, D5: BAT54S; SOT-23
J1: Cartridge_Bus_2x20; PinSocket_2x20_P2.54mm_Horizontal_Cartridge
J2: TI99_DE9_Socket; DSUB-9_Socket_Horizontal_P2.77x2.84mm_EdgePinOffset9.40mm
J3: Breakout_TI99; PinHeader_1x09_P2.54mm_Vertical
Q1: 2N7002; SOT-23
R1, R4, R16, R18: 2.2k; R_0805_2012Metric
R2, R5, R17, R19: 3.3k; R_0805_2012Metric
R3, R6, R10, R12, R15: 10k; R_0805_2012Metric
R7, R8: 4.7k; R_0805_2012Metric
R9, R11: 1k; R_0805_2012Metric
R13: 100R; R_0805_2012Metric
R14: 100k; R_0805_2012Metric
U1: 24C02; SOIC-8_3.9x4.9mm_P1.27mm
U2: 74HCT06; SOIC-14_3.9x8.7mm_P1.27mm
U3, U4: USBLC6-2SC6; SOT-23-6

Connections:
+3V3: C1.1, D1.2 (C2), D2.2 (C2), D4.2 (C2), D5.2 (C2), J1.3, J1.4, U1.8 (VCC)
+5V: C2.1, J1.1, J1.2, J3.2, R3.1, R6.1, R7.1, R8.1, R15.1, U2.14 (VCC), U3.5 (VBUS), U4.5 (VBUS)
/AGND: C5.2, J1.7, J1.9, J1.11, J1.13, R12.2
/AUDIO_RAW_L: C5.1, J1.8, R11.2, R12.1
/AUX_GPIO1: D4.3 (C1A2), J1.21, R16.2, R17.1
/AUX_GPIO2: D5.3 (C1A2), J1.22, R18.2, R19.1
/I2C_SCL: J1.24, U1.6 (SCL)
/I2C_SDA: J1.25, U1.5 (SDA)
/MOTOR_CTRL: J1.19, R13.1
/MOTOR_SENSE: D2.3 (C1A2), J1.18, R4.2, R5.1
/MOT_GATE: Q1.1 (G), R13.2, R14.1
/READ_DRV: R8.2, R9.1, U2.4 (2Y)
/READ_INV1: R7.2, U2.2 (1Y), U2.3 (2A)
/TAPE_EMU_OUT: J1.16, R6.2, U2.1 (1A)
/TAPE_REC_IN: D1.3 (C1A2), J1.17, R1.2, R2.1
/TI_AUDIO_GATE: J2.4, J3.5, R18.1
/TI_CS1_MOTOR_P: J2.1, J3.3, Q1.3 (D), R3.2, R4.1, U3.1 (I/O1), U3.6 (I/O1)
/TI_CS2_MOTOR_P: J2.6, J3.6, R15.2, R16.1, U4.3 (I/O2), U4.4 (I/O2)
/TI_CS2_OUT: C4.1, J2.3, J3.4, R1.1, U3.3 (I/O2), U3.4 (I/O2)
/TI_TAPE_IN: C3.2, J2.8, J3.7, R10.1, U4.1 (I/O1), U4.6 (I/O1)
GND: C1.2, C2.2, D1.1 (A1), D2.1 (A1), D4.1 (A1), D5.1 (A1), J1.6, J1.15, J1.23, J1.26, J1.40, J2.2, J2.5, J2.7, J2.9, J3.1, J3.8, J3.9, Q1.2 (S), R2.2, R5.2, R10.2, R14.2, R17.2, R19.2, U1.1 (A0), U1.2 (A1), U1.3 (A2), U1.4 (GND), U1.7 (WP), U2.5 (3A), U2.7 (GND), U2.9 (4A), U2.11 (5A), U2.13 (6A), U3.2 (GND), U4.2 (GND)
unnamed: C3.1, R9.2
unnamed: C4.2, R11.1

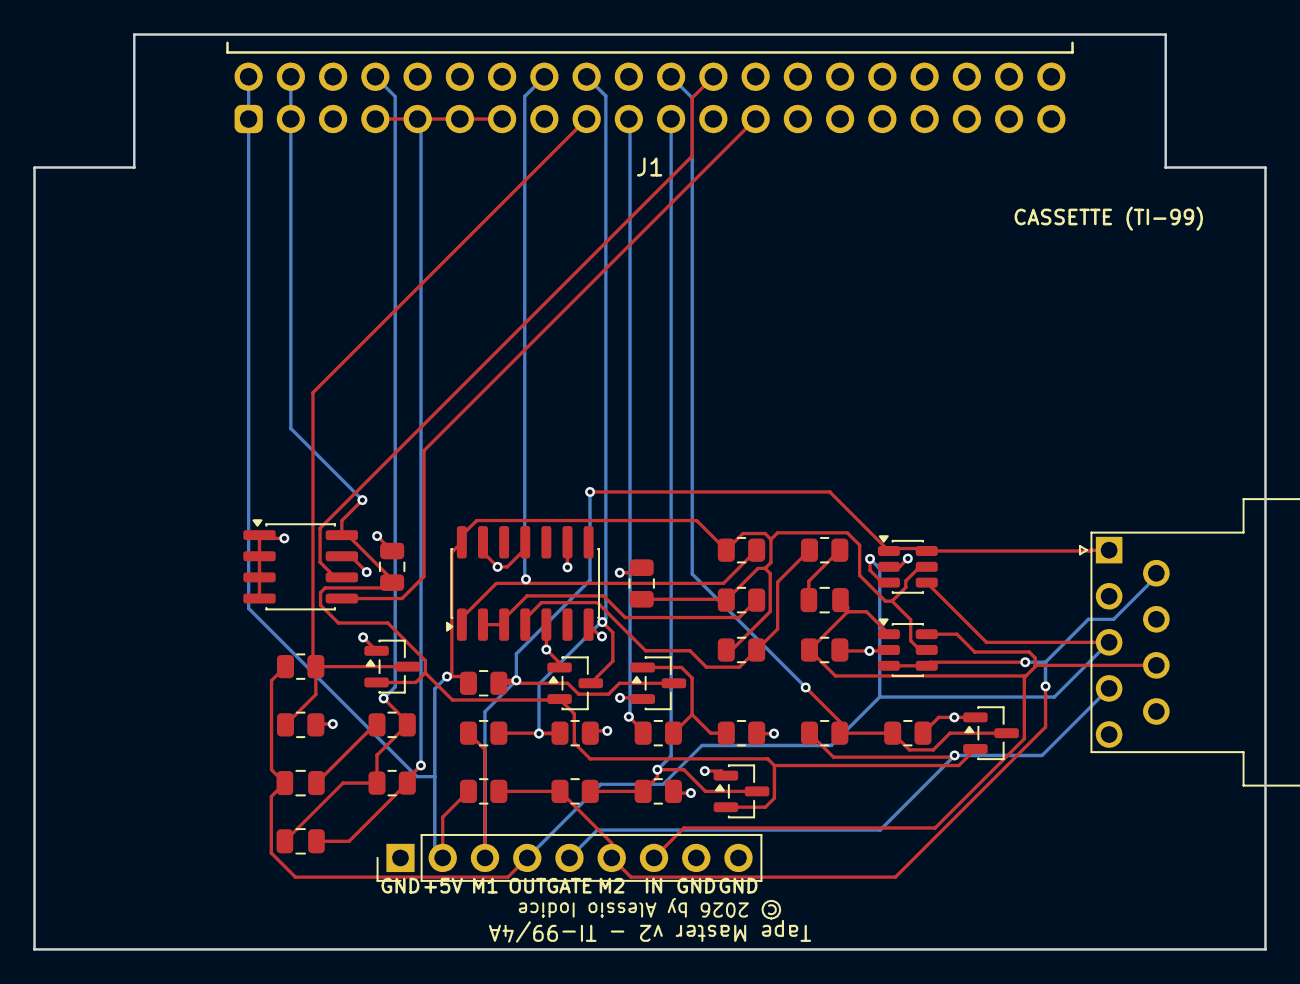
[picture p62: board Tape_Master_Cartridge_TI99.kicad_pcb from above]

Board: 2 copper layers, 74.0 x 55.0 mm, 36 parts (0 on the bottom side), 23 nets.
