lucedoriente/Tape_Master/kicad/v2/Cartridges/02_Atari_SIO/Tape_Master_Cartridge_Atari_SIO.kicad_pcb

## KiCad design kicad/v2/Cartridges/02_Atari_SIO/Tape_Master_Cartridge_Atari_SIO.kicad_pcb (2026-11-07)

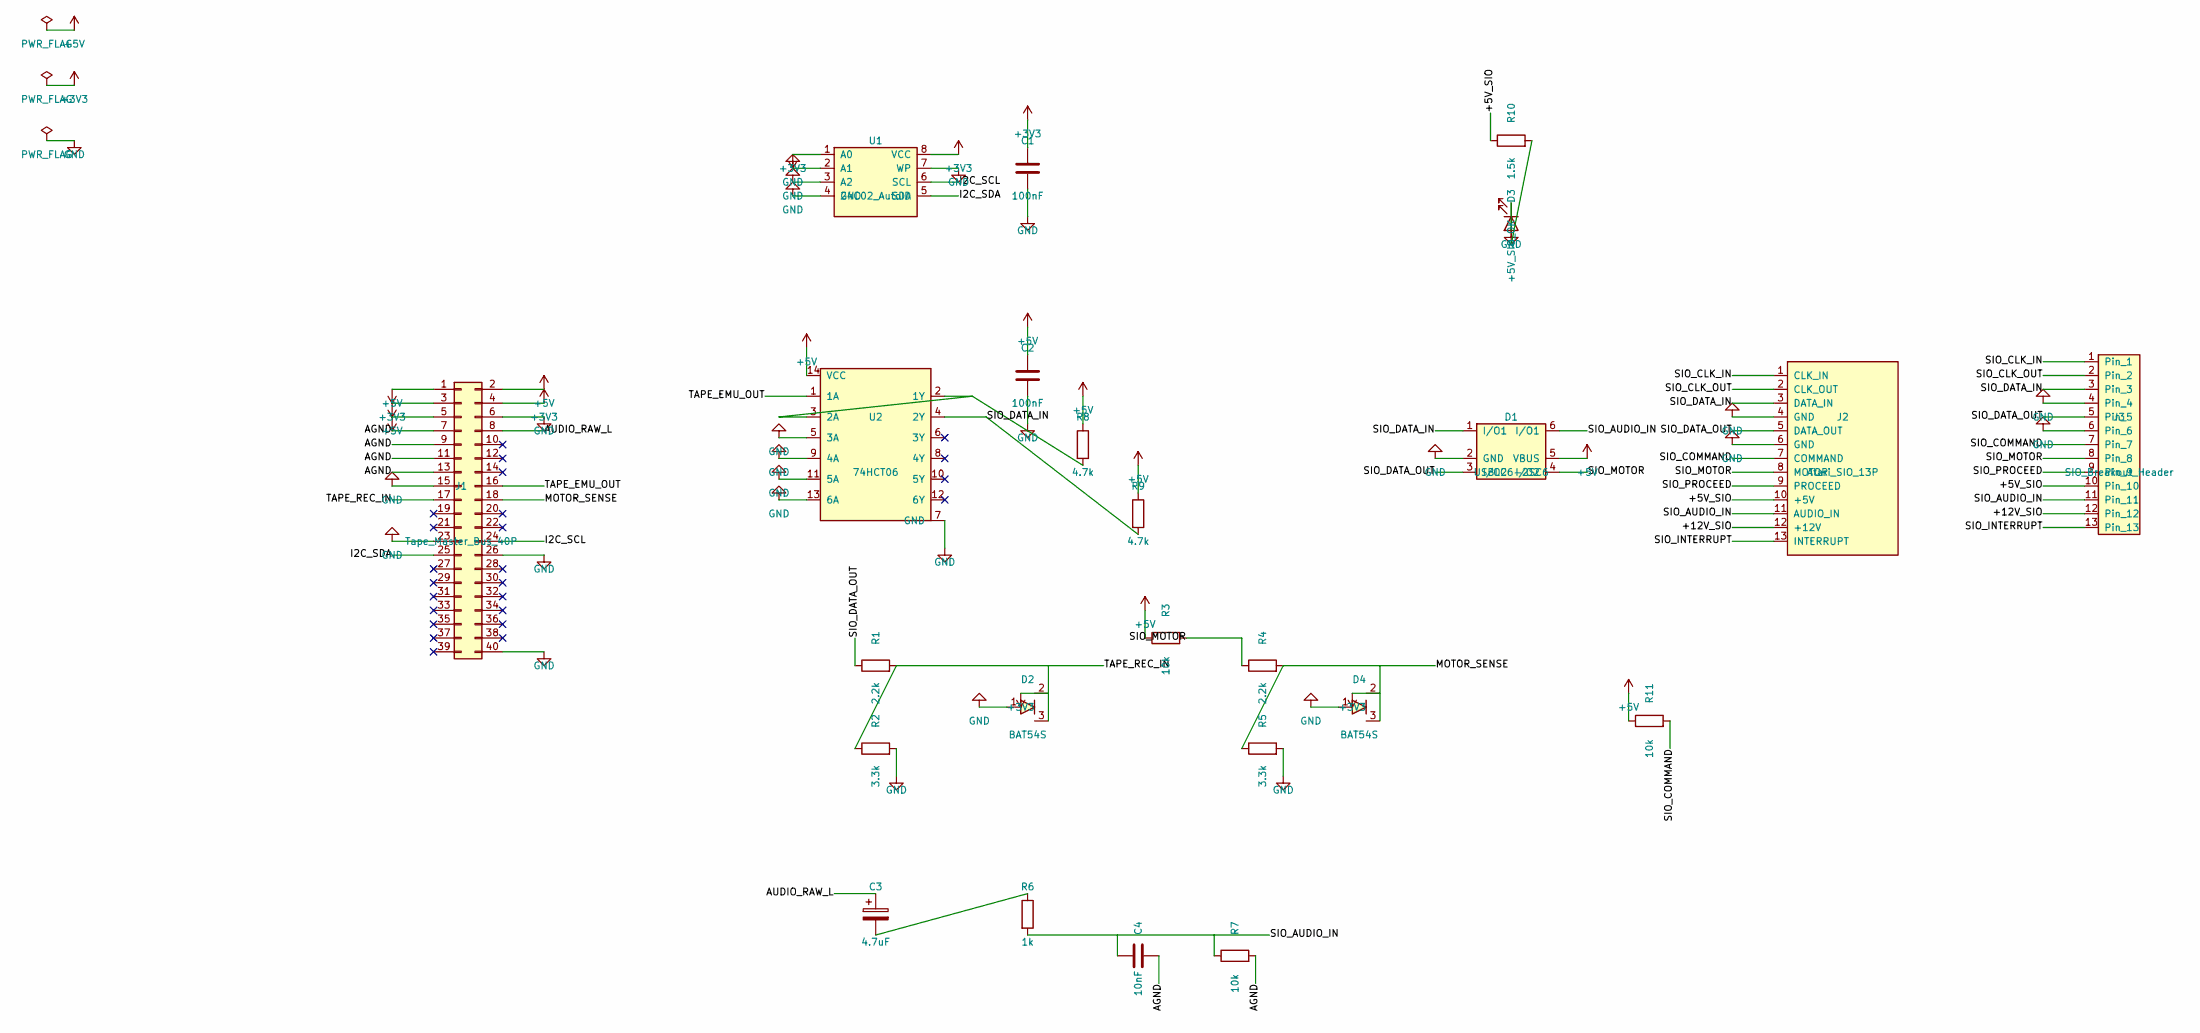
[picture p63: schematic Tape_Master_Cartridge_Atari_SIO.kicad_sch, Tape Master v2 - Cartridge 02: Atari SIO (XC12/1010/410)]

Parts:
C1, C2: 100nF; C_0805_2012Metric
C3: 4.7uF; CP_Elec_5x5.4
C4: 10nF; C_0805_2012Metric
D1: USBLC6-2SC6; SOT-23-6
D2, D4: BAT54S; SOT-23
D3: +5V_SIO_OK; LED_0805_2012Metric
J1: Tape_Master_Bus_40P; PinSocket_2x20_P2.54mm_Horizontal_Cartridge
J2: Atari_SIO_13P
J3: SIO_Breakout_Header; PinHeader_1x13_P2.54mm_Vertical
R1, R4: 2.2k; R_0805_2012Metric
R2, R5: 3.3k; R_0805_2012Metric
R3, R7, R11: 10k; R_0805_2012Metric
R6: 1k; R_0805_2012Metric
R8, R9: 4.7k; R_0805_2012Metric
R10: 1.5k; R_0805_2012Metric
U1: 24C02_AutoID; SOIC-8_3.9x4.9mm_P1.27mm
U2: 74HCT06; SOIC-14_3.9x8.7mm_P1.27mm

Connections:
+3V3: C1.1, D2.2 (C2), D4.2 (C2), J1.3, J1.4, U1.1 (A0), U1.8 (VCC)
+5V: C2.1, D1.5 (VBUS), J1.1, J1.2, J1.5, R3.1, R8.1, R9.1, R11.1, U2.14 (VCC)
/+5V_SIO: J2.10 (+5V), J3.10, R10.1
/+12V_SIO: J2.12 (+12V), J3.12
/AGND: C4.2, J1.7, J1.9, J1.11, J1.13, R7.2
/AUDIO_RAW_L: C3.1, J1.8
/I2C_SCL: J1.24, U1.6 (SCL)
/I2C_SDA: J1.25, U1.5 (SDA)
/MOTOR_SENSE: D4.3 (C1A2), J1.18, R4.2, R5.1
/SIO_AUDIO_IN: C4.1, D1.6 (I/O1), J2.11 (AUDIO_IN), J3.11, R6.2, R7.1
/SIO_CLK_IN: J2.1 (CLK_IN), J3.1
/SIO_CLK_OUT: J2.2 (CLK_OUT), J3.2
/SIO_COMMAND: J2.7 (COMMAND), J3.7, R11.2
/SIO_DATA_IN: D1.1 (I/O1), J2.3 (DATA_IN), J3.3, R9.2, U2.4 (2Y)
/SIO_DATA_OUT: D1.3 (I/O2), J2.5 (DATA_OUT), J3.5, R1.1
/SIO_INTERRUPT: J2.13 (INTERRUPT), J3.13
/SIO_MOTOR: D1.4 (I/O2), J2.8 (MOTOR), J3.8, R3.2, R4.1
/SIO_PROCEED: J2.9 (PROCEED), J3.9
/TAPE_EMU_OUT: J1.16, U2.1 (1A)
/TAPE_REC_IN: D2.3 (C1A2), J1.17, R1.2, R2.1
GND: C1.2, C2.2, D1.2 (GND), D2.1 (A1), D3.1 (K), D4.1 (A1), J1.6, J1.15, J1.23, J1.26, J1.40, J2.4 (GND), J2.6 (GND), J3.4, J3.6, R2.2, R5.2, U1.2 (A1), U1.3 (A2), U1.4 (GND), U1.7 (WP), U2.5 (3A), U2.7 (GND), U2.9 (4A), U2.11 (5A), U2.13 (6A)
unnamed: C3.2, R6.1
unnamed: D3.2 (A), R10.2
unnamed: R8.2, U2.2 (1Y), U2.3 (2A)

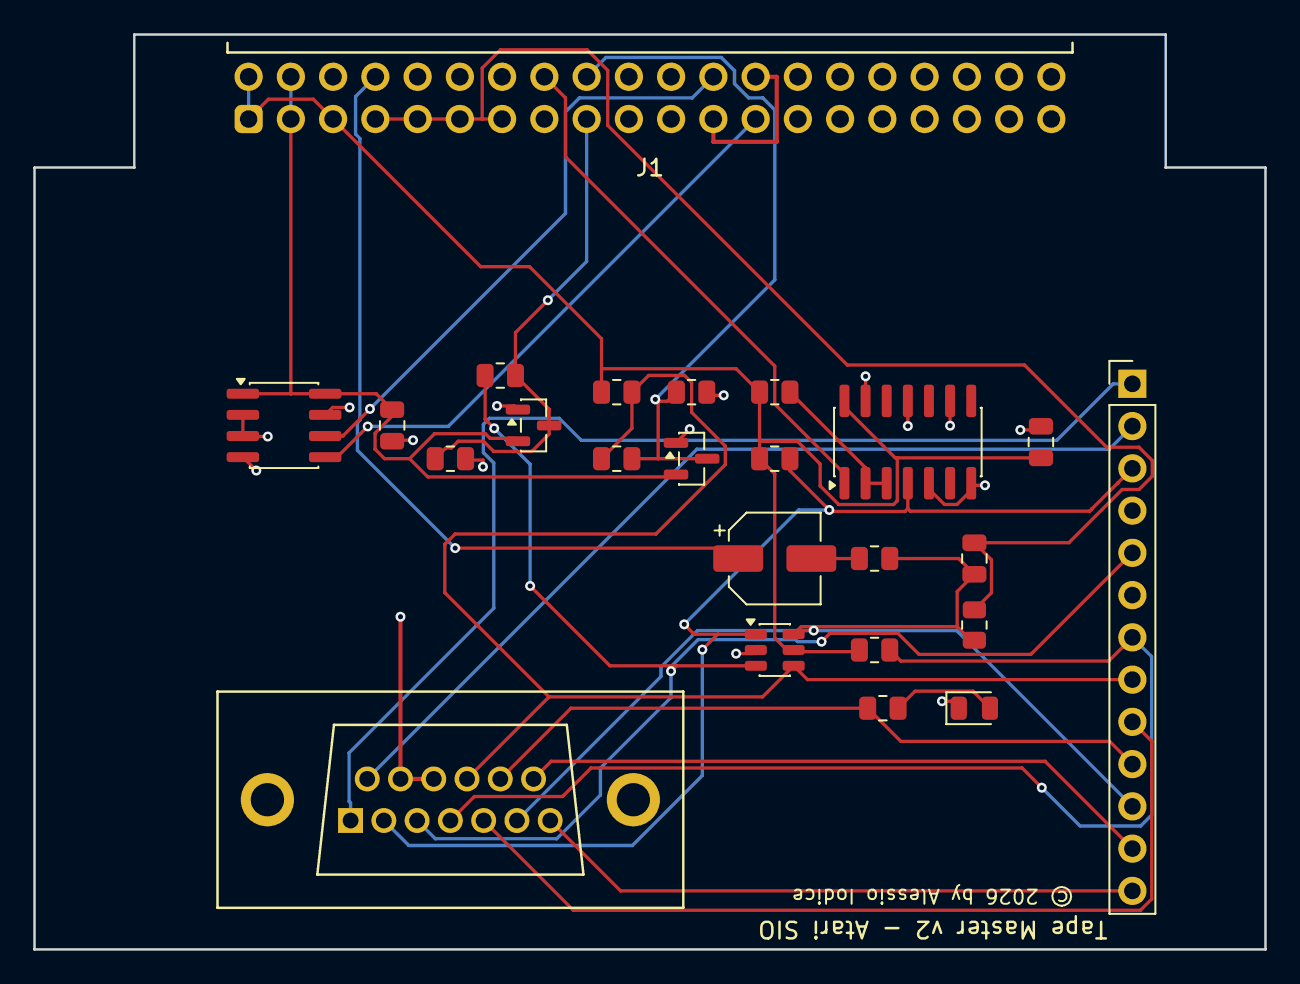
[picture p64: board Tape_Master_Cartridge_Atari_SIO.kicad_pcb from above]

Board: 2 copper layers, 74.0 x 55.0 mm, 24 parts (0 on the bottom side), 24 nets.
