lucedoriente/Tape_Master/kicad/v2/Cartridges/01_Commodore_C2N/Tape_Master_Cartridge_C2N.kicad_pcb

## KiCad design kicad/v2/Cartridges/01_Commodore_C2N/Tape_Master_Cartridge_C2N.kicad_pcb (2026-11-07)

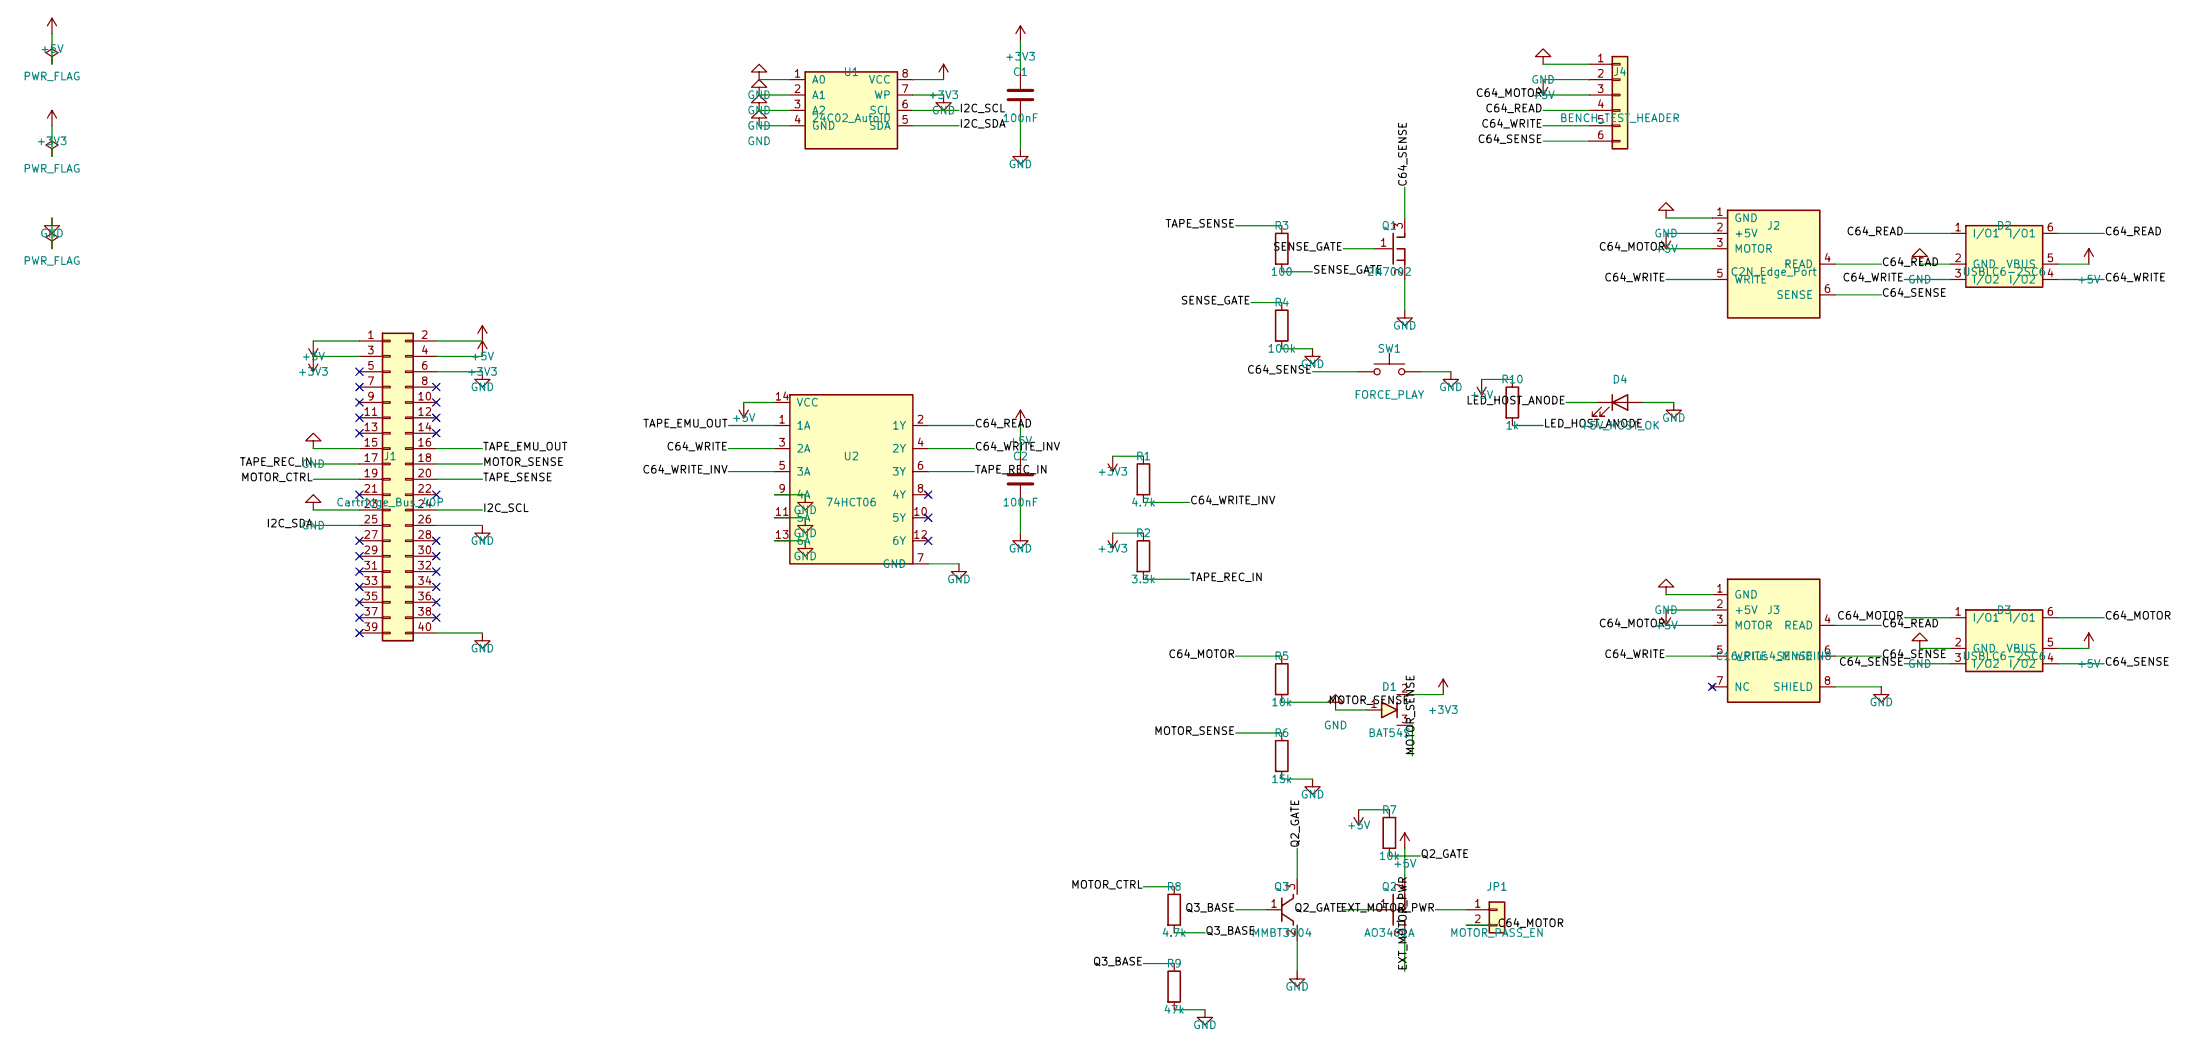
[picture p65: schematic Tape_Master_Cartridge_C2N.kicad_sch, Tape Master v2 - Cartridge 01: Commodore C2N Datassette]

Parts:
C1, C2: 100nF; C_0805_2012Metric
D1: BAT54S; SOT-23
D2, D3: USBLC6-2SC6; SOT-23-6
D4: +5V_HOST_OK; LED_0805_2012Metric
J1: Cartridge_Bus_40P; PinSocket_2x20_P2.54mm_Horizontal_Cartridge
J2: C2N_Edge_Port; C2N_Edge_Connector
J3: C16_Plus4_MiniDIN8; Mini-DIN-8_MD-80_Horizontal
J4: BENCH_TEST_HEADER; PinHeader_1x06_P2.54mm_Vertical
JP1: MOTOR_PASS_EN; PinHeader_1x02_P2.54mm_Vertical
Q1: 2N7002; SOT-23
Q2: AO3401A; SOT-23
Q3: MMBT3904; SOT-23
R1, R8: 4.7k; R_0805_2012Metric
R2: 3.3k; R_0805_2012Metric
R3: 100; R_0805_2012Metric
R4: 100k; R_0805_2012Metric
R5, R7: 10k; R_0805_2012Metric
R6: 15k; R_0805_2012Metric
R9: 47k; R_0805_2012Metric
R10: 1k; R_0805_2012Metric
SW1: FORCE_PLAY; SW_SPST_PTS645
U1: 24C02_AutoID; SOIC-8_3.9x4.9mm_P1.27mm
U2: 74HCT06; SOIC-14_3.9x8.7mm_P1.27mm

Connections:
+3V3: C1.1, D1.2 (C2), J1.3, J1.4, R1.1, R2.1, U1.8 (VCC)
+5V: C2.1, D2.5 (VBUS), D3.5 (VBUS), J1.1, J1.2, J2.2 (+5V), J3.2 (+5V), J4.2, Q2.2 (S), R7.1, R10.1, U2.14 (VCC)
/C64_MOTOR: D3.1 (I/O1), D3.6 (I/O1), J2.3 (MOTOR), J3.3 (MOTOR), J4.3, JP1.2, R5.1
/C64_READ: D2.1 (I/O1), D2.6 (I/O1), J2.4 (READ), J3.4 (READ), J4.4, U2.2 (1Y)
/C64_SENSE: D3.3 (I/O2), D3.4 (I/O2), J2.6 (SENSE), J3.6 (SENSE), J4.6, Q1.3 (D), SW1.1
/C64_WRITE: D2.3 (I/O2), D2.4 (I/O2), J2.5 (WRITE), J3.5 (WRITE), J4.5, U2.3 (2A)
/C64_WRITE_INV: R1.2, U2.4 (2Y), U2.5 (3A)
/EXT_MOTOR_PWR: JP1.1, Q2.3 (D)
/I2C_SCL: J1.24, U1.6 (SCL)
/I2C_SDA: J1.25, U1.5 (SDA)
/LED_HOST_ANODE: D4.1 (K), R10.2
/MOTOR_CTRL: J1.19, R8.1
/MOTOR_SENSE: D1.3 (C1A2), J1.18, R5.2, R6.1
/Q2_GATE: Q2.1 (G), Q3.3 (C), R7.2
/Q3_BASE: Q3.1 (B), R8.2, R9.1
/SENSE_GATE: Q1.1 (G), R3.2, R4.1
/TAPE_EMU_OUT: J1.16, U2.1 (1A)
/TAPE_REC_IN: J1.17, R2.2, U2.6 (3Y)
/TAPE_SENSE: J1.20, R3.1
GND: C1.2, C2.2, D1.1 (A1), D2.2 (GND), D3.2 (GND), D4.2 (A), J1.6, J1.15, J1.23, J1.26, J1.40, J2.1 (GND), J3.1 (GND), J3.8 (SHIELD), J4.1, Q1.2 (S), Q3.2 (E), R4.2, R6.2, R9.2, SW1.2, U1.1 (A0), U1.2 (A1), U1.3 (A2), U1.4 (GND), U1.7 (WP), U2.7 (GND), U2.9 (4A), U2.11 (5A), U2.13 (6A)

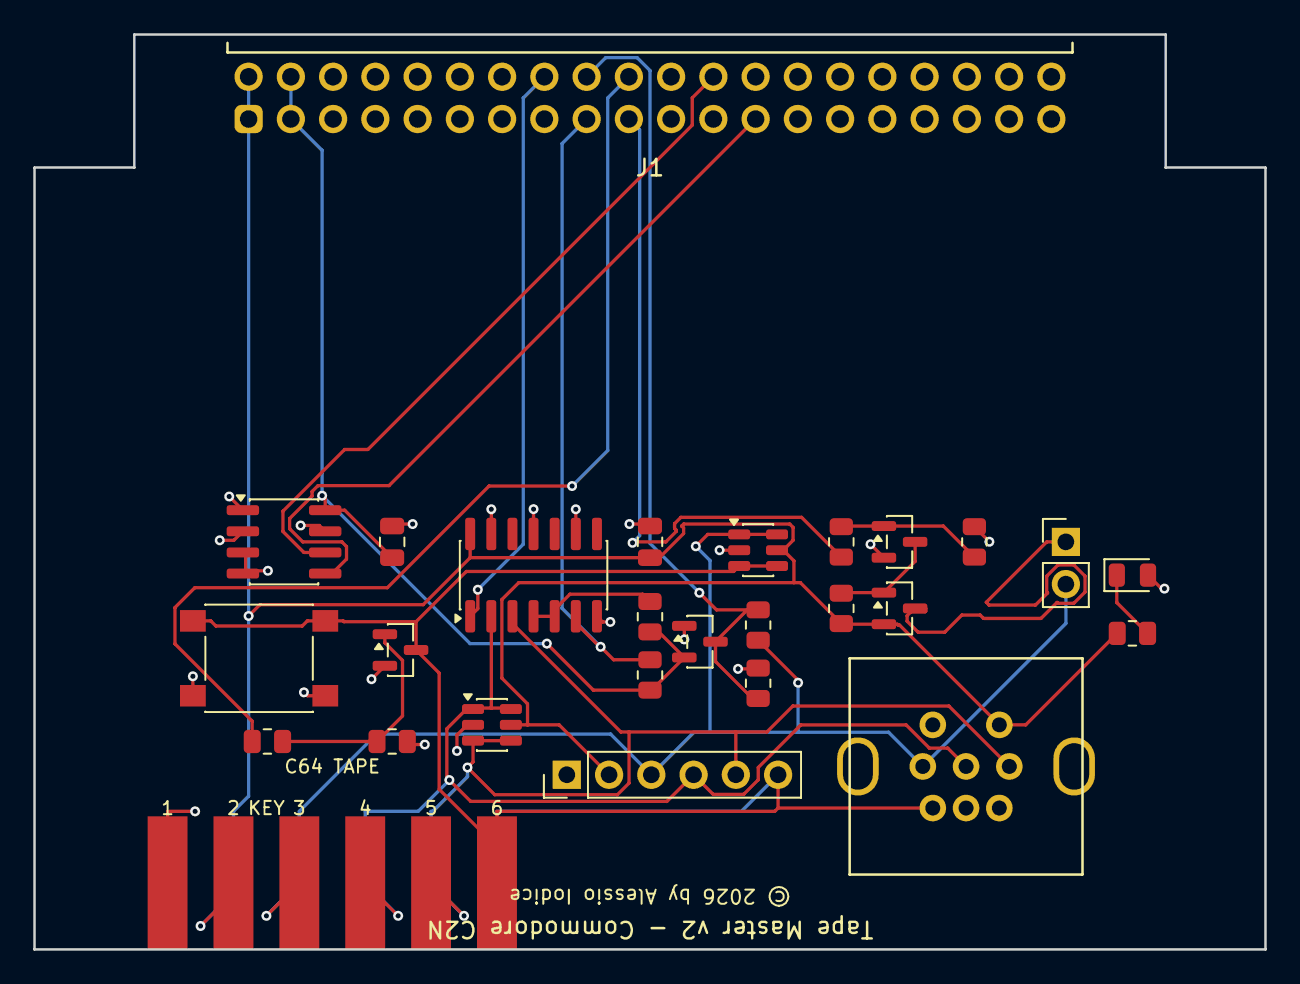
[picture p66: board Tape_Master_Cartridge_C2N.kicad_pcb from above]

Board: 2 copper layers, 74.0 x 55.0 mm, 27 parts (0 on the bottom side), 20 nets.
