lucedoriente/Tape_Master/kicad/v2/Mainboard/Tape_Master_Mainboard.kicad_pcb

## KiCad design kicad/v2/Mainboard/Tape_Master_Mainboard.kicad_pcb (2026-11-07)

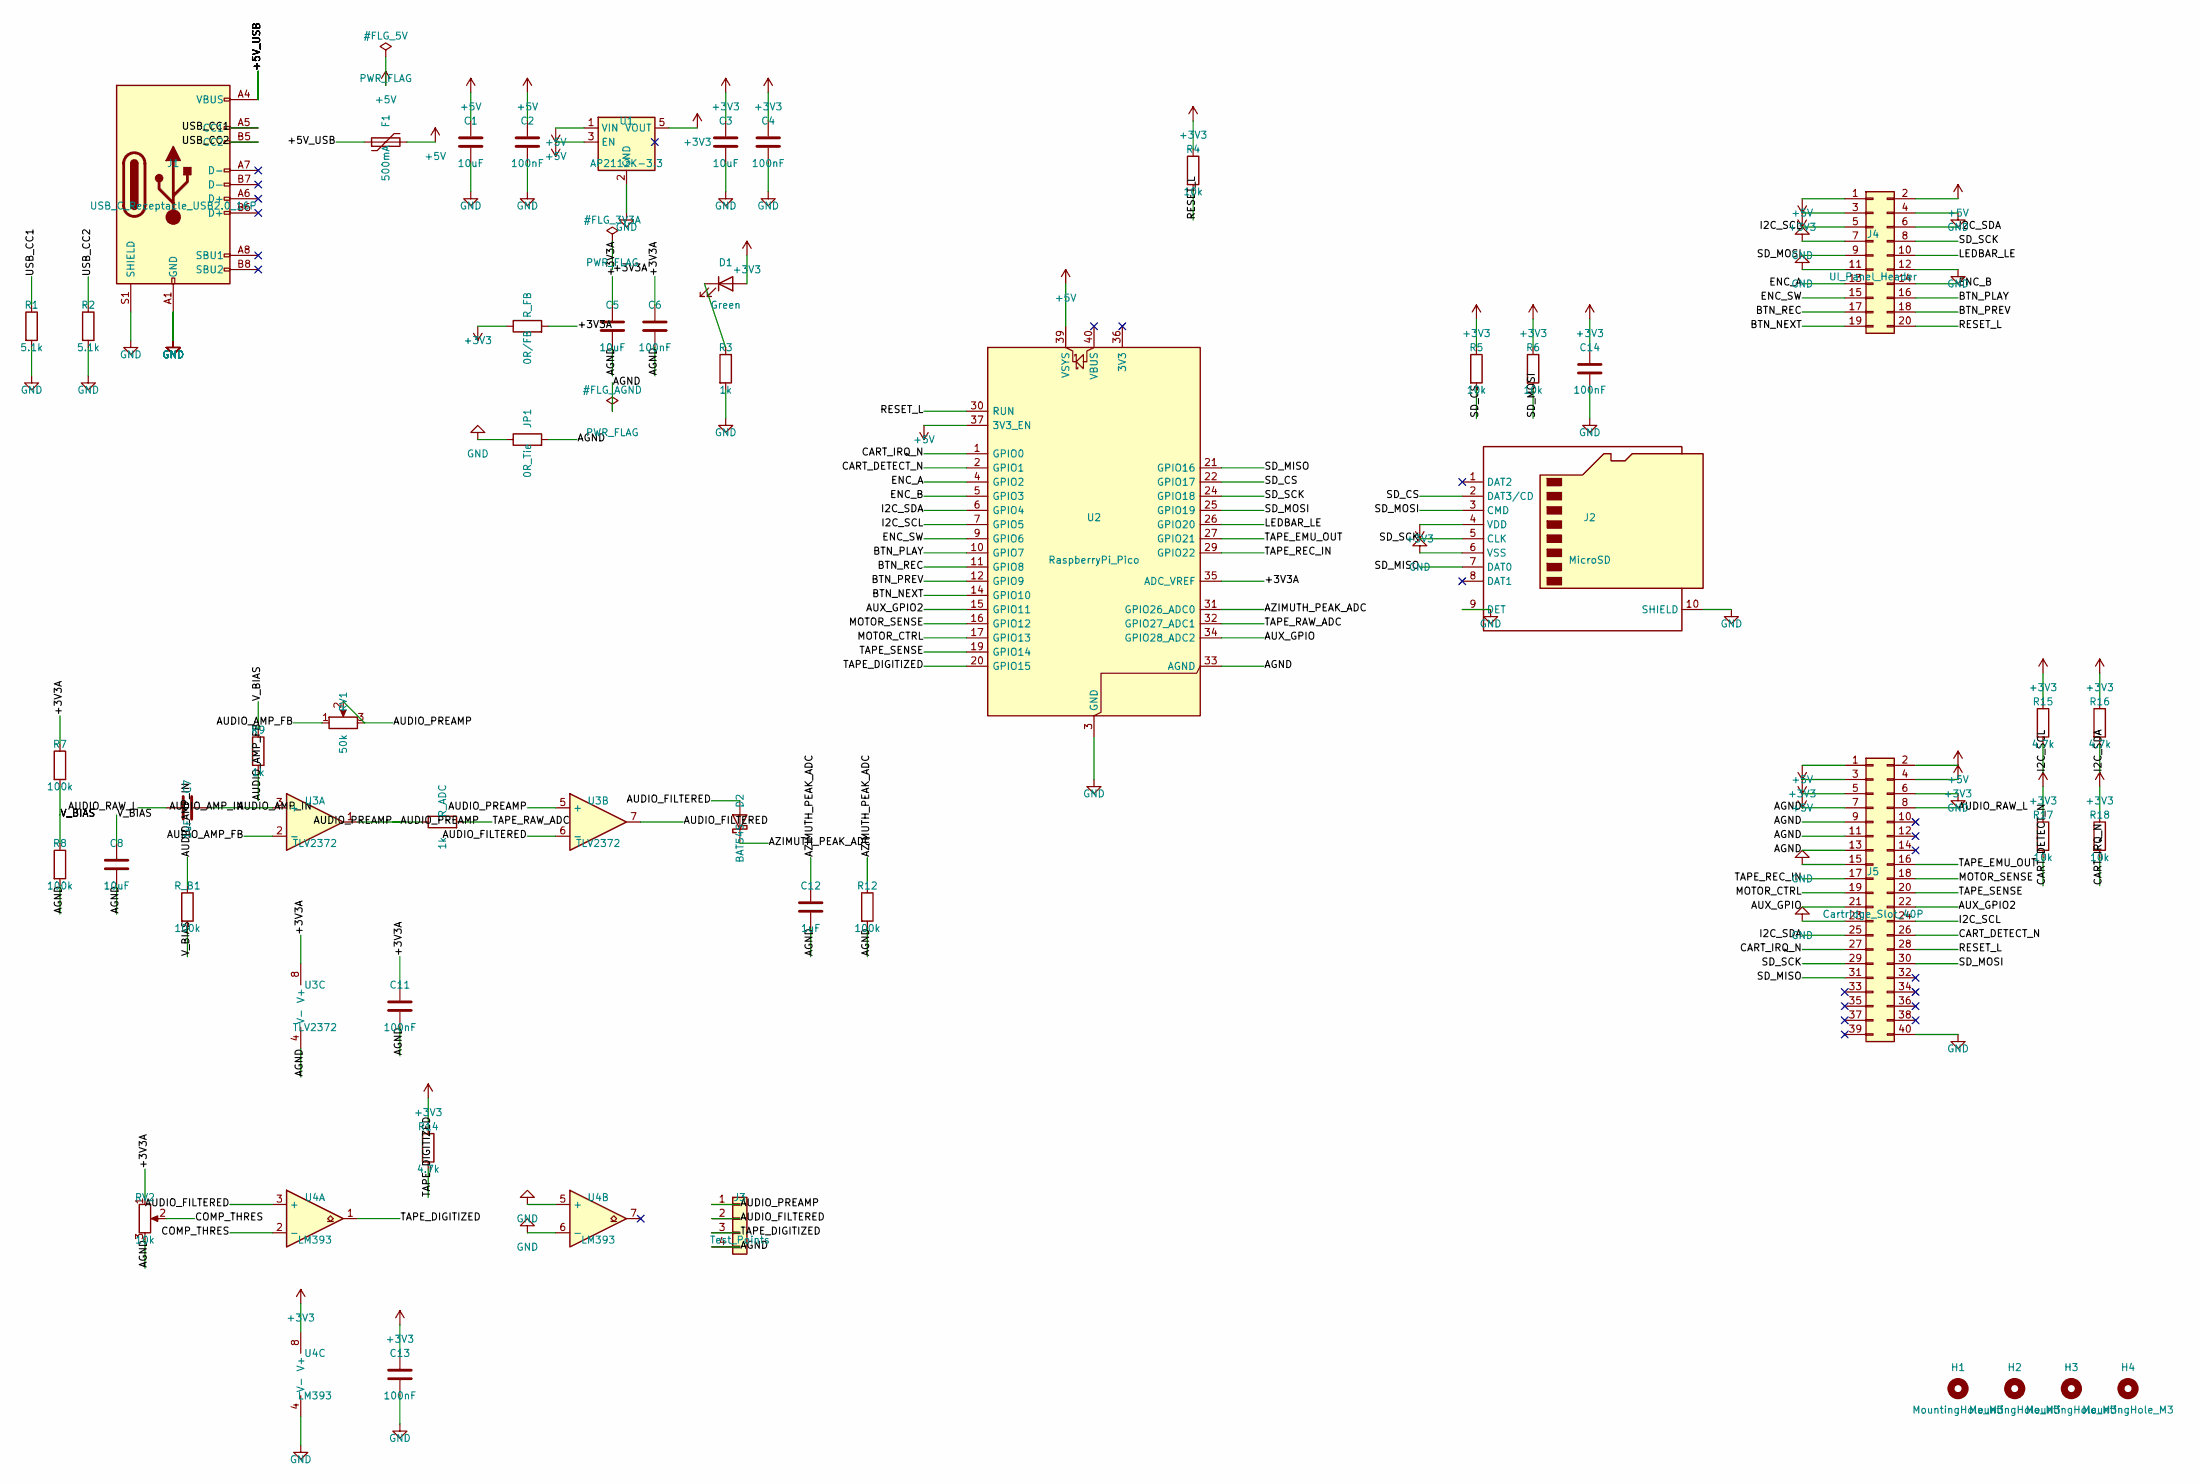
[picture p67: schematic Tape_Master_Mainboard.kicad_sch, Tape Master v2 - Mainboard Base]

Parts:
C1, C3, C5, C8: 10uF; C_0805_2012Metric
C2, C4, C6, C11, C13, C14: 100nF; C_0805_2012Metric
C7, C12: 1uF; C_0805_2012Metric
D1: Green; LED_0805_2012Metric
D2: BAT54S; SOT-23
F1: 500mA; Fuse_1206_3216Metric
H1, H2, H3, H4: MountingHole_M3; MountingHole_3.2mm_M3
J1: USB_C_Receptacle_USB2.0_16P; USB_C_Receptacle_GCT_USB4105-xx-A_16P_TopMnt_Horizontal
J2: MicroSD; microSD_HC_Hirose_DM3D-SF
J3: Test_Points; PinHeader_1x04_P2.54mm_Vertical
J4: UI_Panel_Header; IDC-Header_2x10_P2.54mm_Vertical
J5: Cartridge_Slot_40P; IDC-Header_2x20_P2.54mm_Horizontal
JP1: 0R_Tie; R_0805_2012Metric
R1, R2: 5.1k; R_0805_2012Metric
R3, R9: 1k; R_0805_2012Metric
R4, R5, R6, R17, R18: 10k; R_0805_2012Metric
R7, R8, R12: 100k; R_0805_2012Metric
R14, R15, R16: 4.7k; R_0805_2012Metric
RV1: 50k; Potentiometer_Bourns_3296W_Vertical
RV2: 10k; Potentiometer_Bourns_3296W_Vertical
R_ADC: 1k; R_0805_2012Metric
R_B1: 100k; R_0805_2012Metric
R_FB: 0R/FB; R_0805_2012Metric
U1: AP2112K-3.3; SOT-23-5
U2: RaspberryPi_Pico; RaspberryPi_Pico_Common_THT
U3: TLV2372; SOIC-8_3.9x4.9mm_P1.27mm
U4: LM393; SOIC-8_3.9x4.9mm_P1.27mm

Connections:
+3V3: C3.1, C4.1, C13.1, C14.1, D1.2 (A), J2.4 (VDD), J4.3, J5.3, J5.4, R4.1, R5.1, R6.1, R14.1, R15.1, R16.1, R17.1, R18.1, R_FB.1, U1.5 (VOUT), U4.8 (V+)
+5V: C1.1, C2.1, F1.2, J4.1, J4.2, J5.1, J5.2, J5.5, U1.1 (VIN), U1.3 (EN), U2.37 (3V3_EN), U2.39 (VSYS)
/+3V3A: C5.1, C6.1, C11.1, R7.1, RV2.1, R_FB.2, U2.35 (ADC_VREF), U3.8 (V+)
/+5V_USB: F1.1, J1.A4 (VBUS), J1.A9 (VBUS), J1.B4 (VBUS), J1.B9 (VBUS)
/AGND: C5.2, C6.2, C8.2, C11.2, C12.2, J3.4, J5.7, J5.9, J5.11, J5.13, JP1.2, R8.2, R12.2, RV2.3, U2.33 (AGND), U3.4 (V-)
/AUDIO_AMP_FB: R9.2, RV1.1, U3.2 (-)
/AUDIO_AMP_IN: C7.2, R_B1.1, U3.3 (+)
/AUDIO_FILTERED: D2.2 (A), J3.2, U3.6 (-), U3.7, U4.3 (+)
/AUDIO_PREAMP: J3.1, RV1.2, RV1.3, R_ADC.1, U3.1, U3.5 (+)
/AUDIO_RAW_L: C7.1, J5.8
/AUX_GPIO: J5.21, U2.34 (GPIO28_ADC2)
/AUX_GPIO2: J5.22, U2.15 (GPIO11)
/AZIMUTH_PEAK_ADC: C12.1, D2.1 (K), R12.1, U2.31 (GPIO26_ADC0)
/BTN_NEXT: J4.19, U2.14 (GPIO10)
/BTN_PLAY: J4.16, U2.10 (GPIO7)
/BTN_PREV: J4.18, U2.12 (GPIO9)
/BTN_REC: J4.17, U2.11 (GPIO8)
/CART_DETECT_N: J5.26, R17.2, U2.2 (GPIO1)
/CART_IRQ_N: J5.27, R18.2, U2.1 (GPIO0)
/COMP_THRES: RV2.2, U4.2 (-)
/ENC_A: J4.13, U2.4 (GPIO2)
/ENC_B: J4.14, U2.5 (GPIO3)
/ENC_SW: J4.15, U2.9 (GPIO6)
/I2C_SCL: J4.5, J5.24, R15.2, U2.7 (GPIO5)
/I2C_SDA: J4.6, J5.25, R16.2, U2.6 (GPIO4)
/LEDBAR_LE: J4.10, U2.26 (GPIO20)
/MOTOR_CTRL: J5.19, U2.17 (GPIO13)
/MOTOR_SENSE: J5.18, U2.16 (GPIO12)
/RESET_L: J4.20, J5.28, R4.2, U2.30 (RUN)
/SD_CS: J2.2 (DAT3/CD), R5.2, U2.22 (GPIO17)
/SD_MISO: J2.7 (DAT0), J5.31, U2.21 (GPIO16)
/SD_MOSI: J2.3 (CMD), J4.9, J5.30, R6.2, U2.25 (GPIO19)
/SD_SCK: J2.5 (CLK), J4.8, J5.29, U2.24 (GPIO18)
/TAPE_DIGITIZED: J3.3, R14.2, U2.20 (GPIO15), U4.1
/TAPE_EMU_OUT: J5.16, U2.27 (GPIO21)
/TAPE_RAW_ADC: R_ADC.2, U2.32 (GPIO27_ADC1)
/TAPE_REC_IN: J5.17, U2.29 (GPIO22)
/TAPE_SENSE: J5.20, U2.19 (GPIO14)
/USB_CC1: J1.A5 (CC1), R1.1
/USB_CC2: J1.B5 (CC2), R2.1
/V_BIAS: C8.1, R7.2, R8.1, R9.1, R_B1.2
GND: C1.2, C2.2, C3.2, C4.2, C13.2, C14.2, J1.A1 (GND), J1.A12 (GND), J1.B1 (GND), J1.B12 (GND), J1.S1 (SHIELD), J2.6 (VSS), J2.9 (DET), J2.10 (SHIELD), J4.4, J4.7, J4.11, J4.12, J5.6, J5.15, J5.23, J5.40, JP1.1, R1.2, R2.2, R3.2, U1.2 (GND), U2.3 (GND), U2.8 (GND), U2.13 (GND), U2.18 (GND), U2.23 (GND), U2.28 (GND), U2.38 (GND), U4.4 (V-), U4.5 (+), U4.6 (-)
unnamed: D1.1 (K), R3.1

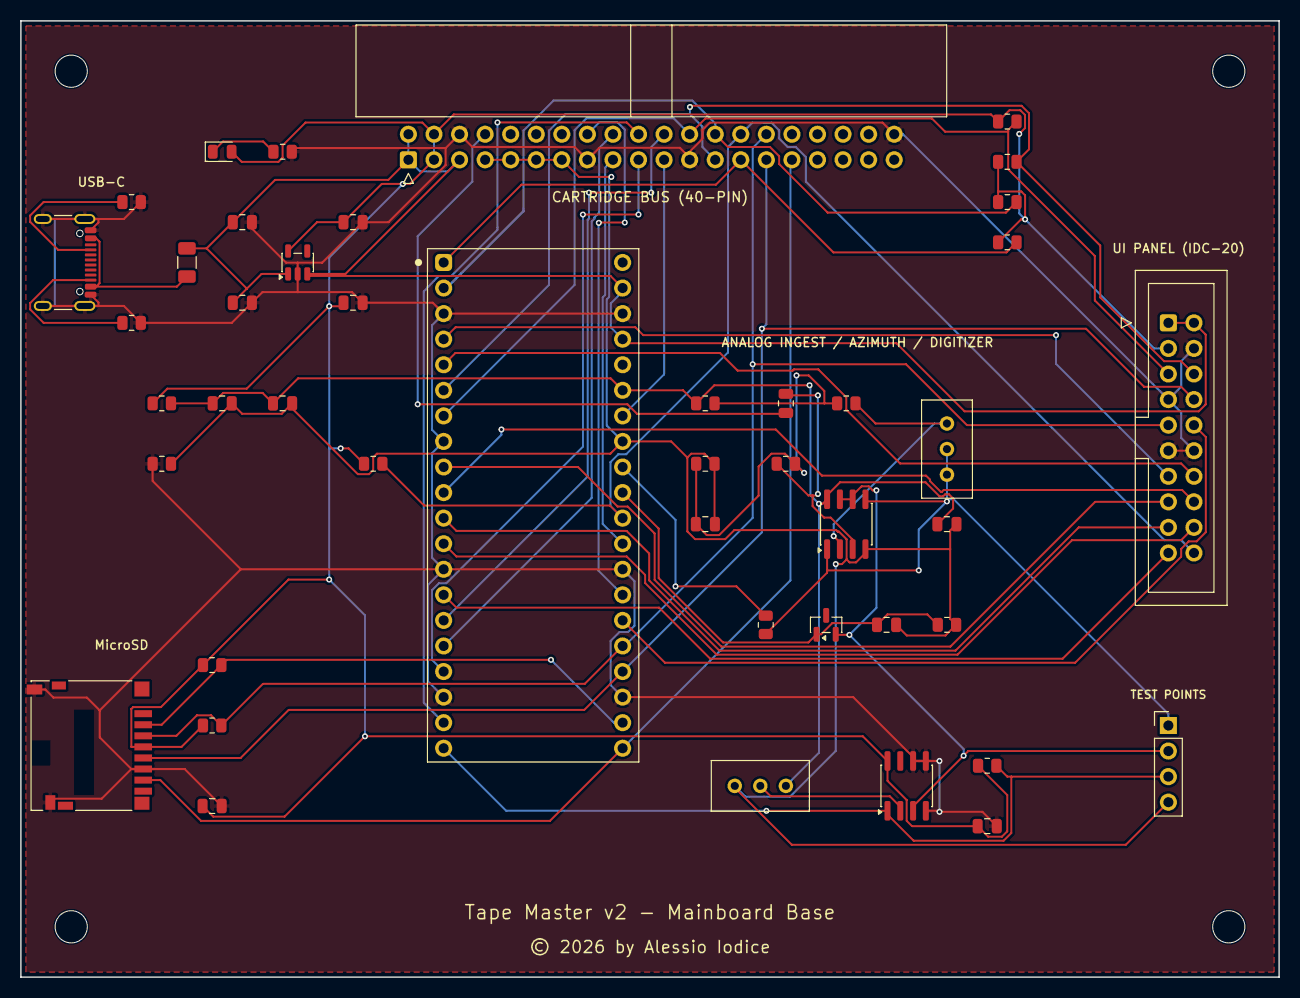
[picture p68: board Tape_Master_Mainboard.kicad_pcb from above]

Board: 2 copper layers, 125.0 x 95.0 mm, 49 parts (0 on the bottom side), 43 nets.
