lucedoriente/Tape_Master/kicad/v2/Cartridges/03_Thomson_Olivetti_PC128/Tape_Master_Cartridge_Thomson_PC128.kicad_pcb

## KiCad design kicad/v2/Cartridges/03_Thomson_Olivetti_PC128/Tape_Master_Cartridge_Thomson_PC128.kicad_pcb (2026-11-07)

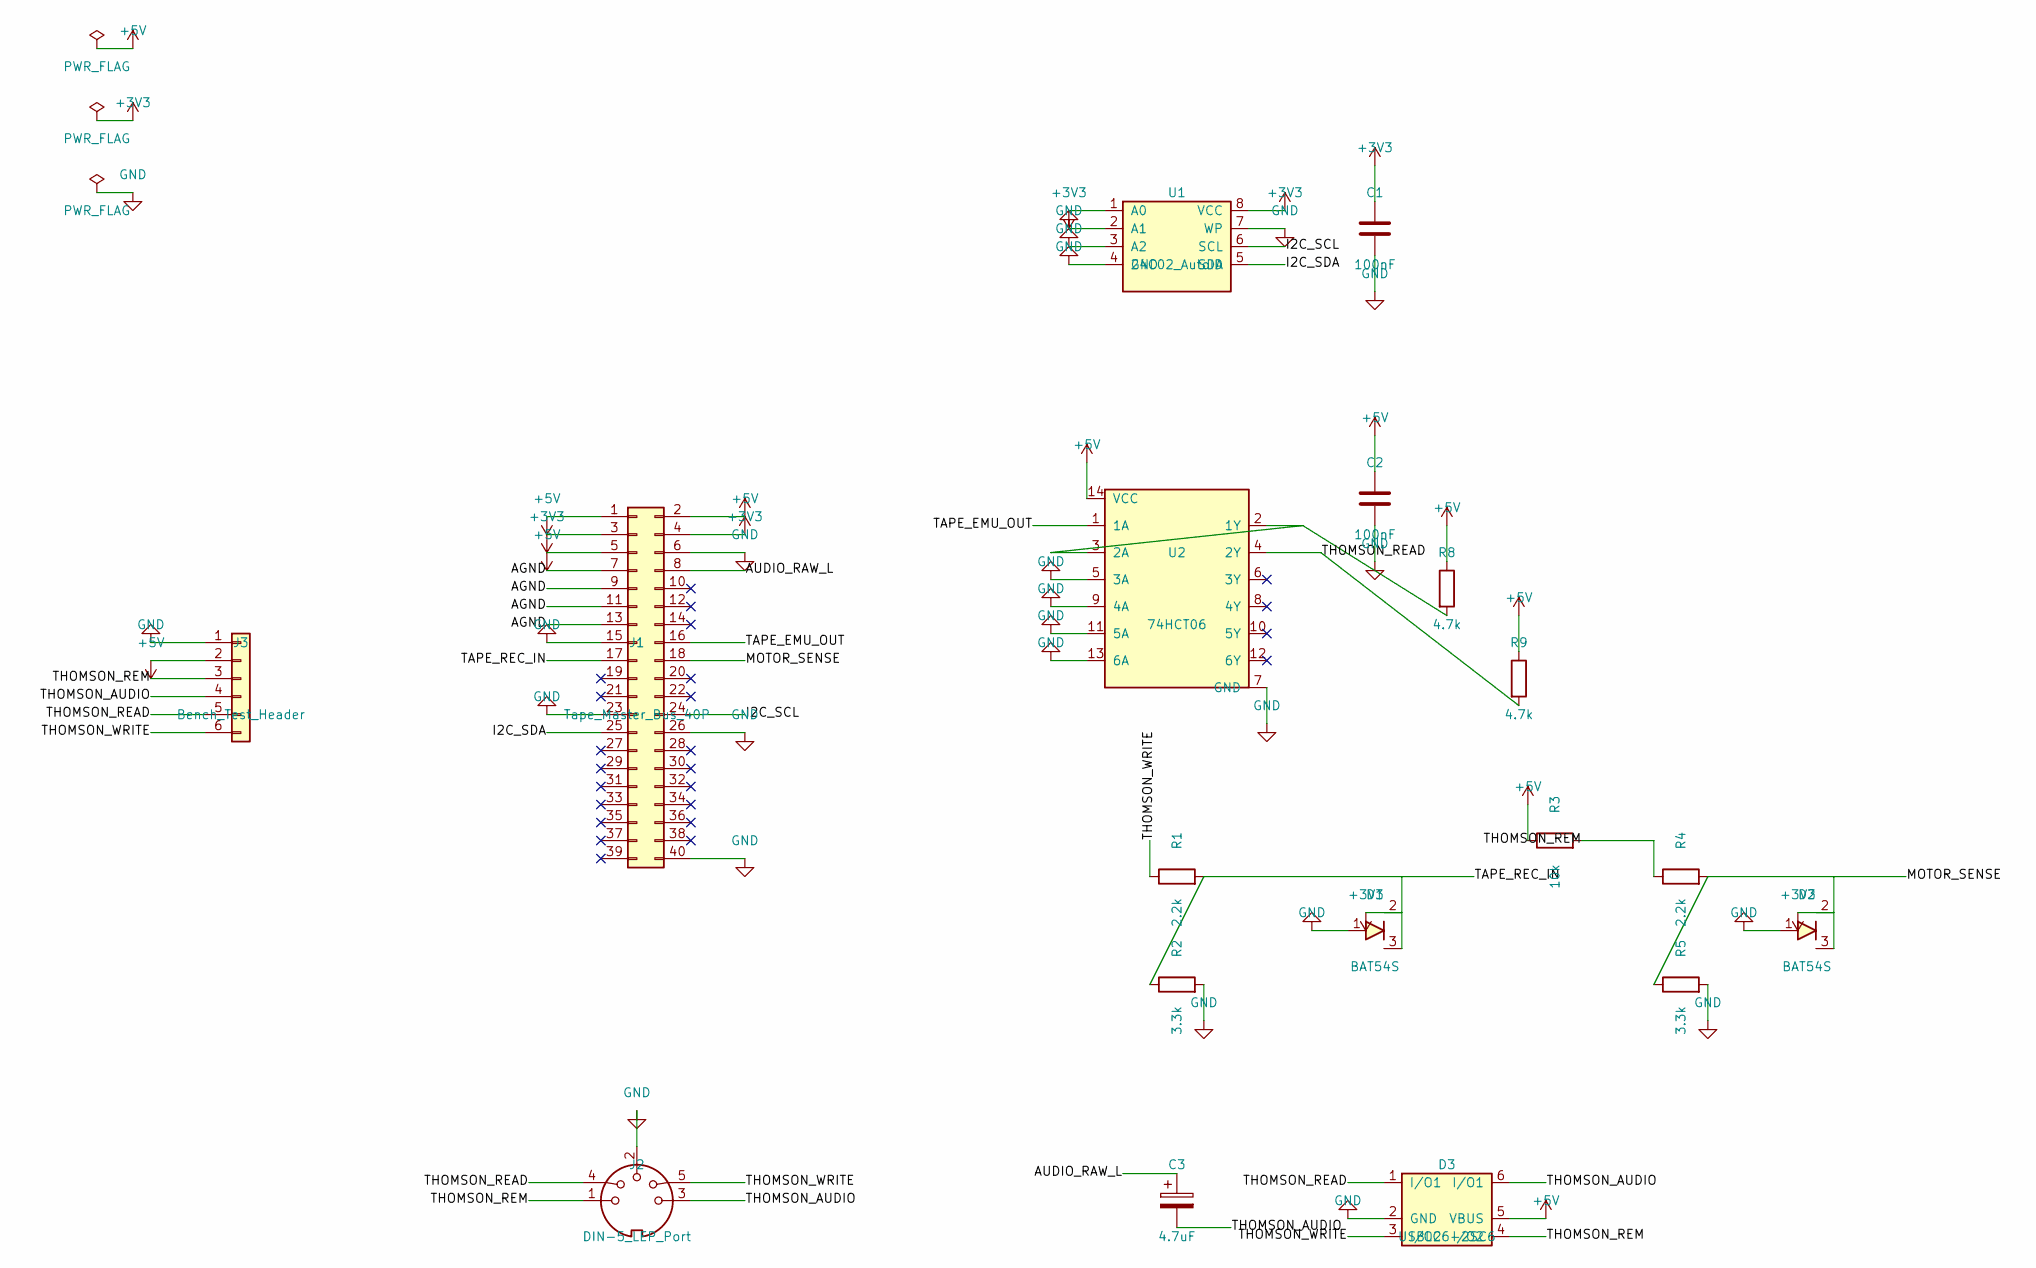
[picture p69: schematic Tape_Master_Cartridge_Thomson_PC128.kicad_sch, Tape Master Cartridge #03 — Thomson MO5/TO7 & Olivetti PC 1…]

Parts:
C1, C2: 100nF; C_0805_2012Metric
C3: 4.7uF; CP_Elec_5x5.4
D1, D2: BAT54S; SOT-23
D3: USBLC6-2SC6; SOT-23-6
J1: Tape_Master_Bus_40P; PinSocket_2x20_P2.54mm_Horizontal_Cartridge
J2: DIN-5_LEP_Port; DIN-5_180_Horizontal_CUI_SDS-50J
J3: Bench_Test_Header; PinHeader_1x06_P2.54mm_Vertical
R1, R4: 2.2k; R_0805_2012Metric
R2, R5: 3.3k; R_0805_2012Metric
R3: 10k; R_0805_2012Metric
R8, R9: 4.7k; R_0805_2012Metric
U1: 24C02_AutoID; SOIC-8_3.9x4.9mm_P1.27mm
U2: 74HCT06; SOIC-14_3.9x8.7mm_P1.27mm

Connections:
+3V3: C1.1, D1.2 (C2), D2.2 (C2), J1.3, J1.4, U1.1 (A0), U1.8 (VCC)
+5V: C2.1, D3.5 (VBUS), J1.1, J1.2, J1.5, J3.2, R3.1, R8.1, R9.1, U2.14 (VCC)
/AGND: J1.7, J1.9, J1.11, J1.13
/AUDIO_RAW_L: C3.1, J1.8
/I2C_SCL: J1.24, U1.6 (SCL)
/I2C_SDA: J1.25, U1.5 (SDA)
/MOTOR_SENSE: D2.3 (C1A2), J1.18, R4.2, R5.1
/TAPE_EMU_OUT: J1.16, U2.1 (1A)
/TAPE_REC_IN: D1.3 (C1A2), J1.17, R1.2, R2.1
/THOMSON_AUDIO: C3.2, D3.6 (I/O1), J2.3, J3.4
/THOMSON_READ: D3.1 (I/O1), J2.4, J3.5, R9.2, U2.4 (2Y)
/THOMSON_REM: D3.4 (I/O2), J2.1, J3.3, R3.2, R4.1
/THOMSON_WRITE: D3.3 (I/O2), J2.5, J3.6, R1.1
GND: C1.2, C2.2, D1.1 (A1), D2.1 (A1), D3.2 (GND), J1.6, J1.15, J1.23, J1.26, J1.40, J2.2, J3.1, R2.2, R5.2, U1.2 (A1), U1.3 (A2), U1.4 (GND), U1.7 (WP), U2.5 (3A), U2.7 (GND), U2.9 (4A), U2.11 (5A), U2.13 (6A)
unnamed: R8.2, U2.2 (1Y), U2.3 (2A)

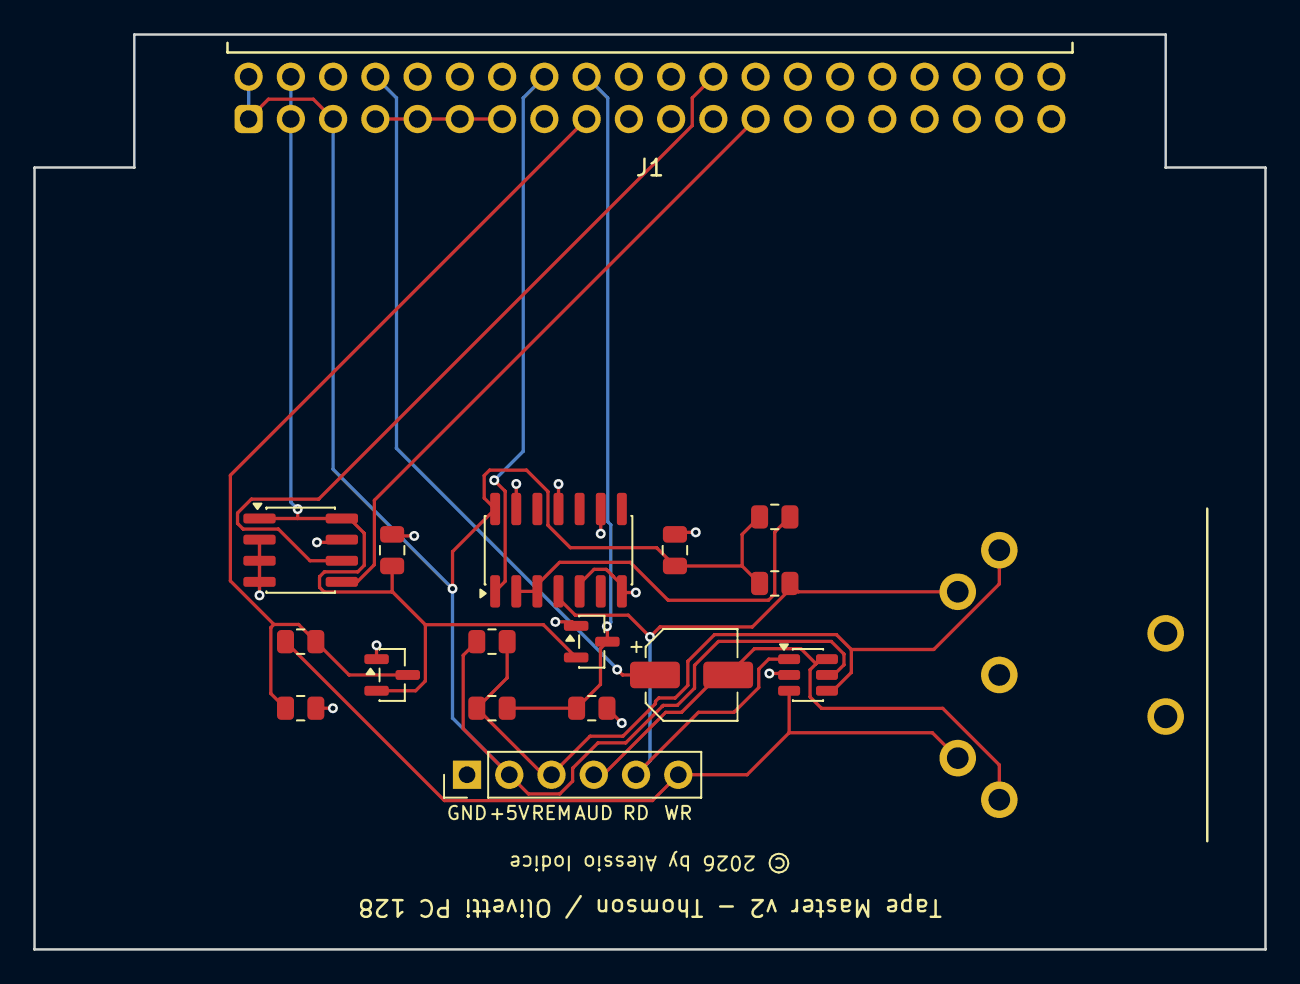
[picture p70: board Tape_Master_Cartridge_Thomson_PC128.kicad_pcb from above]

Board: 2 copper layers, 74.0 x 55.0 mm, 18 parts (0 on the bottom side), 15 nets.
