lucedoriente/Tape_Master/kicad/v2/UI_Panel/Tape_Master_UI_Panel.kicad_pcb

## KiCad design kicad/v2/UI_Panel/Tape_Master_UI_Panel.kicad_pcb (2026-11-06)

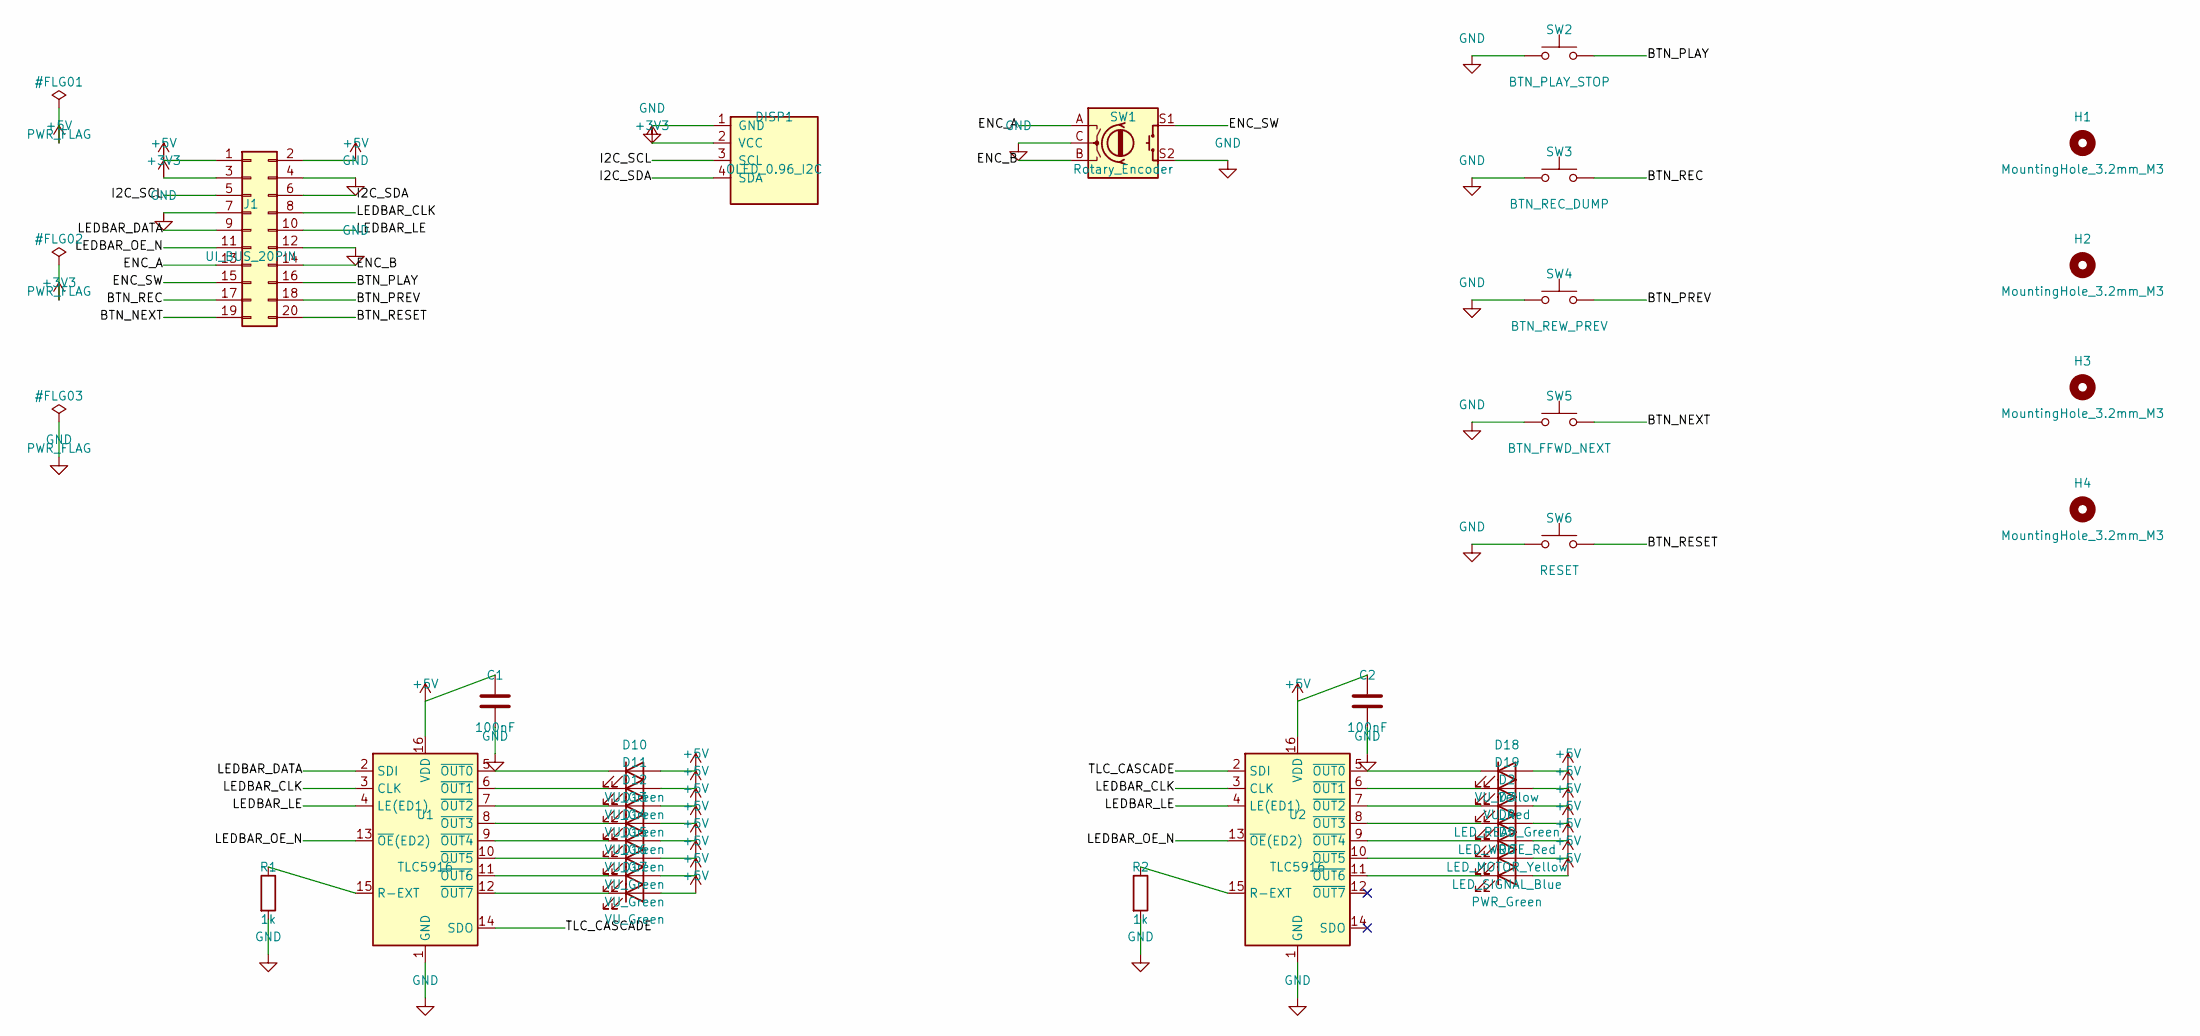
[picture p71: schematic Tape_Master_UI_Panel.kicad_sch, Tape Master v2 - Front Panel UI Daughterboard]

Parts:
C1, C2: 100nF; C_0805_2012Metric
D2: LED_READ_Green; LED_0805_2012Metric
D3: LED_WRITE_Red; LED_0805_2012Metric
D4: LED_MOTOR_Yellow; LED_0805_2012Metric
D5: LED_SIGNAL_Blue; LED_0805_2012Metric
D6: PWR_Green; LED_0805_2012Metric
D10, D11, D12, D13, D14, D15, D16, D17: VU_Green; LED_0805_2012Metric
D18: VU_Yellow; LED_0805_2012Metric
D19: VU_Red; LED_0805_2012Metric
DISP1: OLED_0.96_I2C; PinHeader_1x04_P2.54mm_Vertical
H1, H2, H3, H4: MountingHole_3.2mm_M3
J1: UI_BUS_20PIN; IDC-Header_2x10_P2.54mm_Vertical
R1, R2: 1k; R_0805_2012Metric
SW1: Rotary_Encoder; RotaryEncoder_Alps_EC11E-Switch_Vertical_H20mm
SW2: BTN_PLAY_STOP; SW_PUSH_6mm
SW3: BTN_REC_DUMP; SW_PUSH_6mm
SW4: BTN_REW_PREV; SW_PUSH_6mm
SW5: BTN_FFWD_NEXT; SW_PUSH_6mm
SW6: RESET; SW_PUSH_6mm
U1, U2: TLC5916; SOIC-16_3.9x9.9mm_P1.27mm

Connections:
+3V3: DISP1.2 (VCC), J1.3
+5V: C1.1, C2.1, D2.2 (A), D3.2 (A), D4.2 (A), D5.2 (A), D6.2 (A), D10.2 (A), D11.2 (A), D12.2 (A), D13.2 (A), D14.2 (A), D15.2 (A), D16.2 (A), D17.2 (A), D18.2 (A), D19.2 (A), J1.1, J1.2, U1.16 (VDD), U2.16 (VDD)
/BTN_NEXT: J1.19, SW5.2
/BTN_PLAY: J1.16, SW2.2
/BTN_PREV: J1.18, SW4.2
/BTN_REC: J1.17, SW3.2
/BTN_RESET: J1.20, SW6.2
/ENC_A: J1.13, SW1.A
/ENC_B: J1.14, SW1.B
/ENC_SW: J1.15, SW1.S1
/I2C_SCL: DISP1.3 (SCL), J1.5
/I2C_SDA: DISP1.4 (SDA), J1.6
/LEDBAR_CLK: J1.8, U1.3 (CLK), U2.3 (CLK)
/LEDBAR_DATA: J1.9, U1.2 (SDI)
/LEDBAR_LE: J1.10, U1.4 (LE(ED1)), U2.4 (LE(ED1))
/LEDBAR_OE_N: J1.11, U1.13 (~OE(ED2)), U2.13 (~OE(ED2))
/TLC_CASCADE: U1.14 (SDO), U2.2 (SDI)
GND: C1.2, C2.2, DISP1.1 (GND), J1.4, J1.7, J1.12, R1.2, R2.2, SW1.C, SW1.S2, SW2.1, SW3.1, SW4.1, SW5.1, SW6.1, U1.1 (GND), U2.1 (GND)
unnamed: D2.1 (K), U2.7 (~OUT2)
unnamed: D3.1 (K), U2.8 (~OUT3)
unnamed: D4.1 (K), U2.9 (~OUT4)
unnamed: D5.1 (K), U2.10 (~OUT5)
unnamed: D6.1 (K), U2.11 (~OUT6)
unnamed: D10.1 (K), U1.5 (~OUT0)
unnamed: D11.1 (K), U1.6 (~OUT1)
unnamed: D12.1 (K), U1.7 (~OUT2)
unnamed: D13.1 (K), U1.8 (~OUT3)
unnamed: D14.1 (K), U1.9 (~OUT4)
unnamed: D15.1 (K), U1.10 (~OUT5)
unnamed: D16.1 (K), U1.11 (~OUT6)
unnamed: D17.1 (K), U1.12 (~OUT7)
unnamed: D18.1 (K), U2.5 (~OUT0)
unnamed: D19.1 (K), U2.6 (~OUT1)
unnamed: R1.1, U1.15 (R-EXT)
unnamed: R2.1, U2.15 (R-EXT)

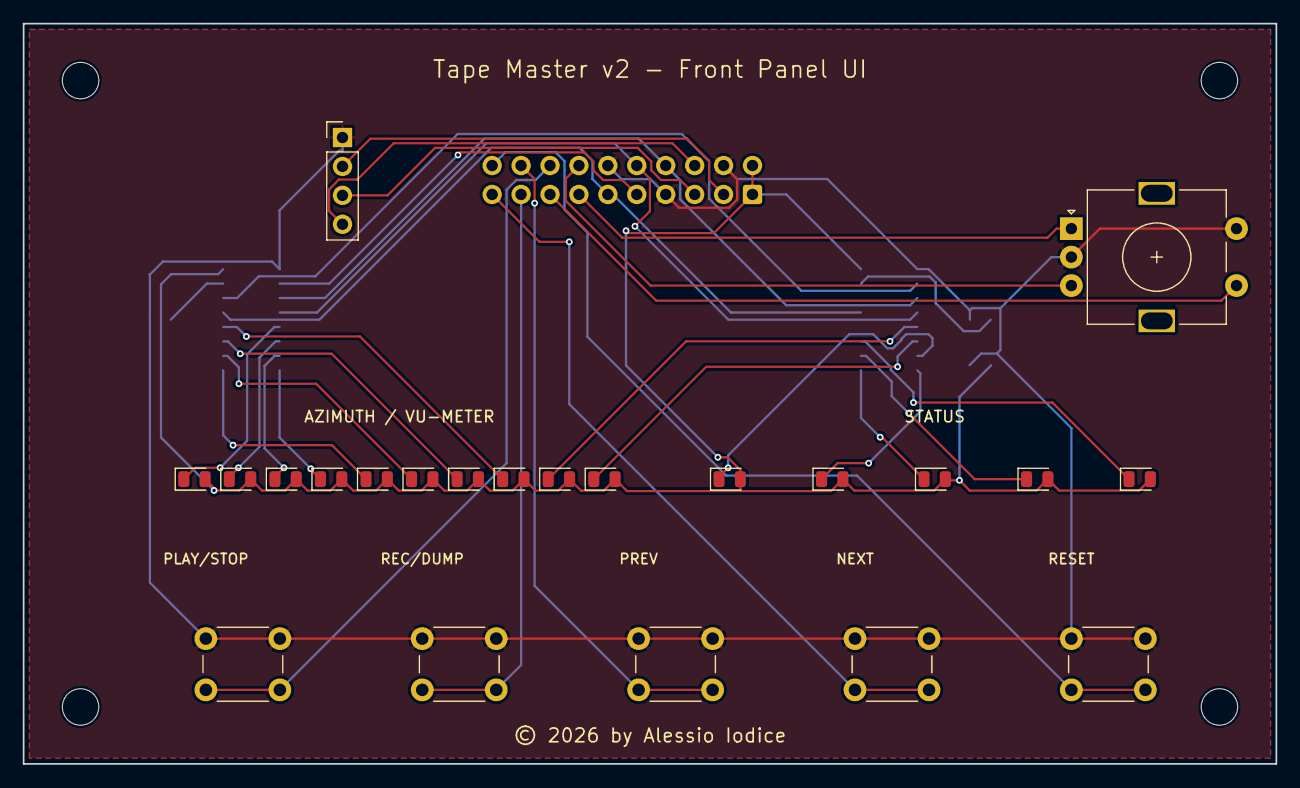
[picture p72: board Tape_Master_UI_Panel.kicad_pcb from above]

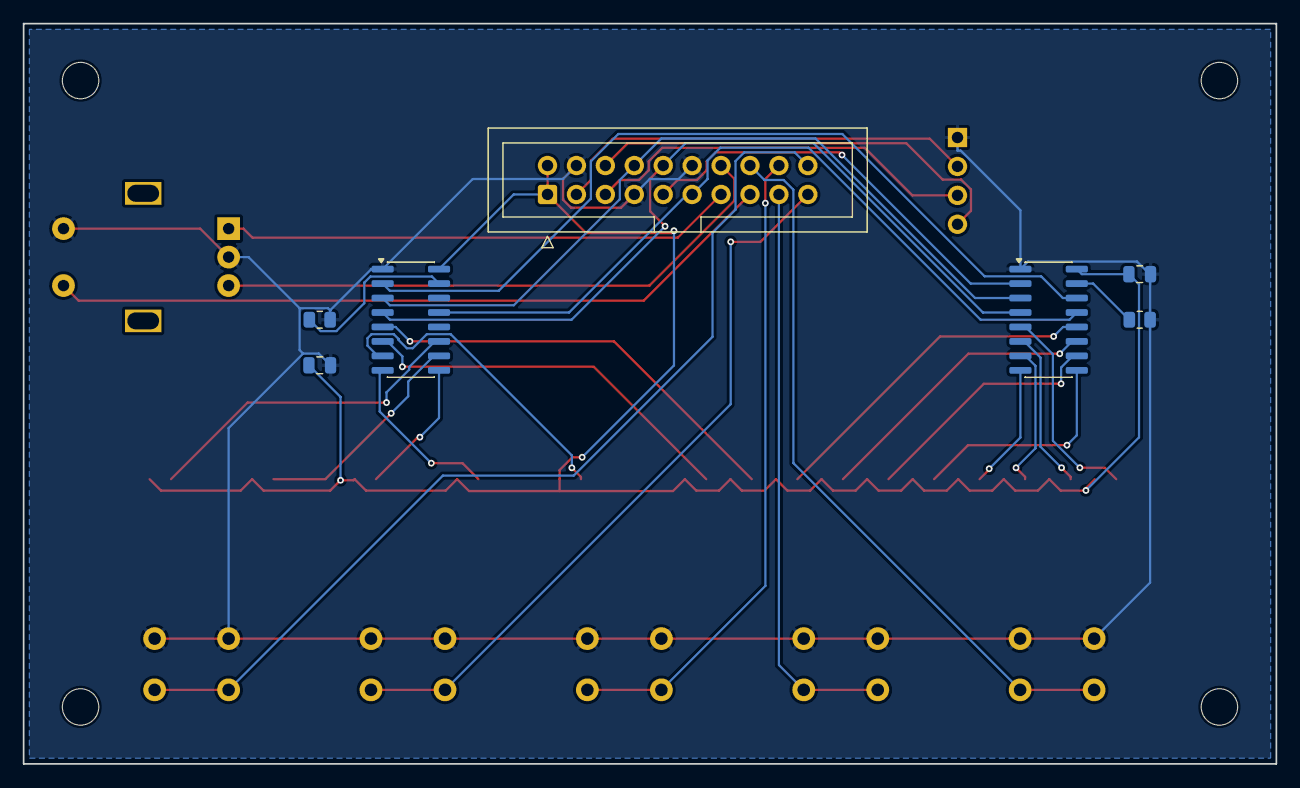
[picture p73: board Tape_Master_UI_Panel.kicad_pcb from below]

Board: 2 copper layers, 110.0 x 65.0 mm, 33 parts (7 on the bottom side), 35 nets.
