lucedoriente/Tape_Master/kicad/v1/Tape-Master-ergonomic-preview.kicad_pcb

## KiCad design kicad/v1/Tape-Master.kicad_pcb (2026-11-06, an earlier design)

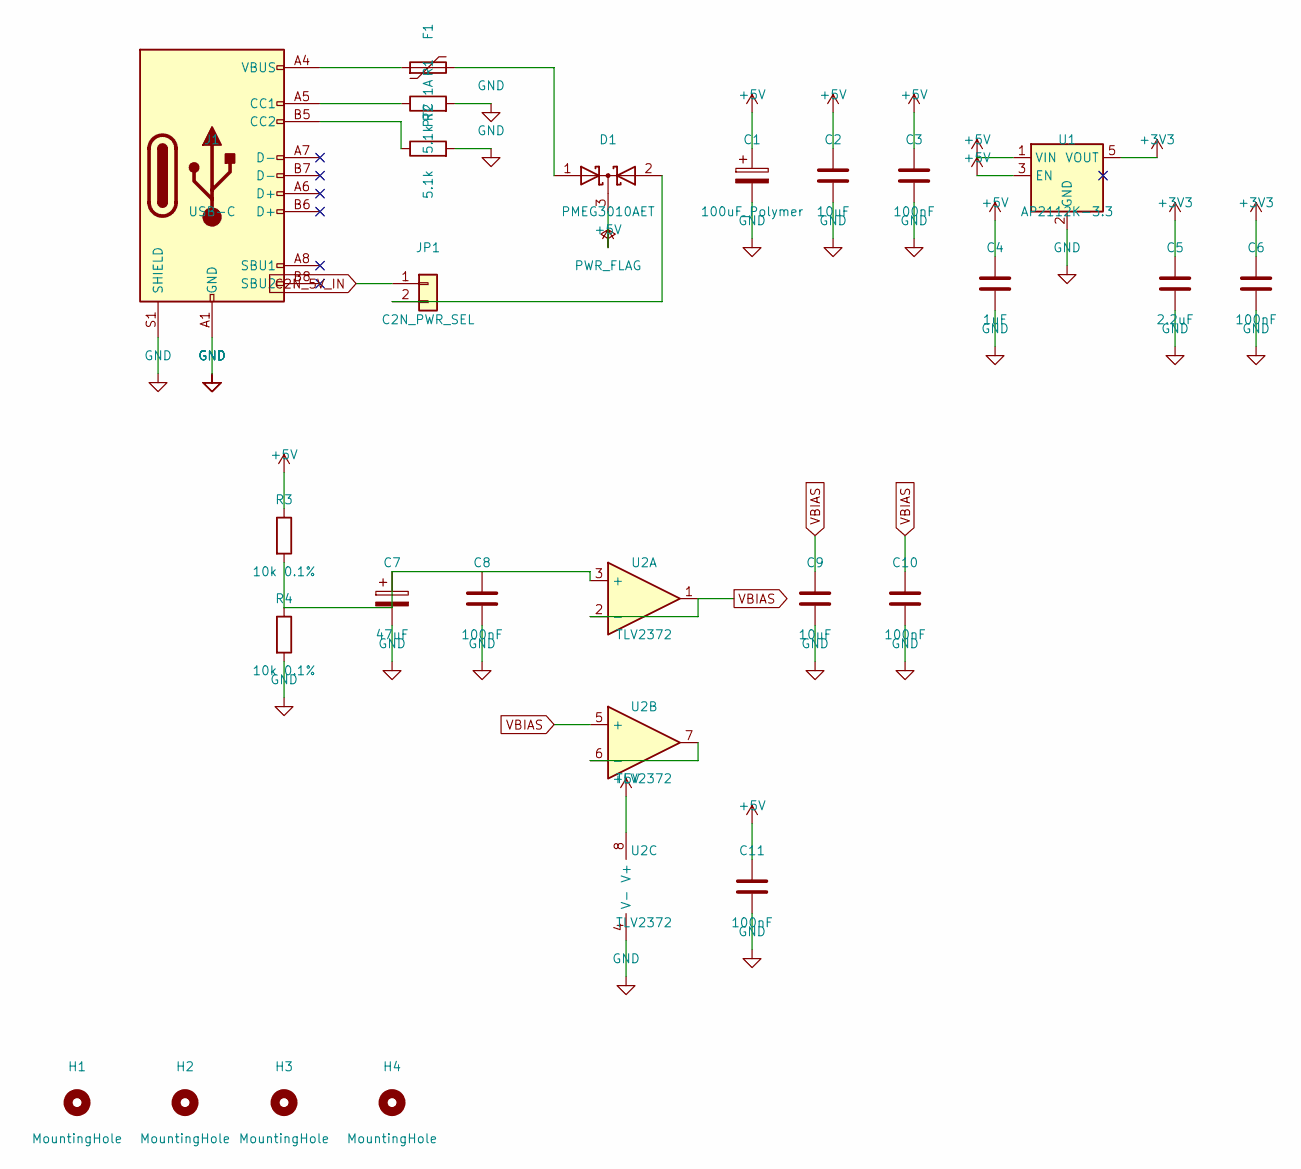
[picture p74: schematic 01_Power_Supply.kicad_sch, Power Supply & Precision Bias Reference Subsystem]

Parts:
C1: 100uF_Polymer; CP_EIA-3528-21_Kemet-B
C2, C9: 10uF; C_0805_2012Metric
C3, C6, C8, C10, C11: 100nF; C_0805_2012Metric
C4: 1uF; C_0805_2012Metric
C5: 2.2uF; C_0805_2012Metric
C7: 47uF; CP_EIA-3528-21_Kemet-B
D1: PMEG3010AET; SOT-23
F1: PTC 1A; Fuse_1206_3216Metric
H1, H2, H3, H4: MountingHole; MountingHole_3.2mm_M3
J1: USB-C; USB_C_Receptacle_GCT_USB4105-xx-A_16P_TopMnt_Horizontal
JP1: C2N_PWR_SEL; PinHeader_1x02_P2.54mm_Vertical
R1, R2: 5.1k; R_0805_2012Metric
R3, R4: 10k 0.1%; R_0805_2012Metric
U1: AP2112K-3.3; SOT-23-5
U2: TLV2372; SOIC-8_3.9x4.9mm_P1.27mm

Connections:
unnamed: D1.1 (A), F1.2
unnamed: F1.1, J1.A4 (VBUS), J1.A9 (VBUS), J1.B4 (VBUS), J1.B9 (VBUS)
unnamed: J1.A5 (CC1), R1.1
unnamed: J1.B5 (CC2), R2.1
unnamed: D1.2 (A), JP1.2
unnamed: C7.1, C8.1, R3.2, R4.1, U2.3 (+)
unnamed: U2.6 (-), U2.7
VBIAS: C9.1, C10.1, U2.1, U2.2 (-), U2.5 (+); also elsewhere on the board

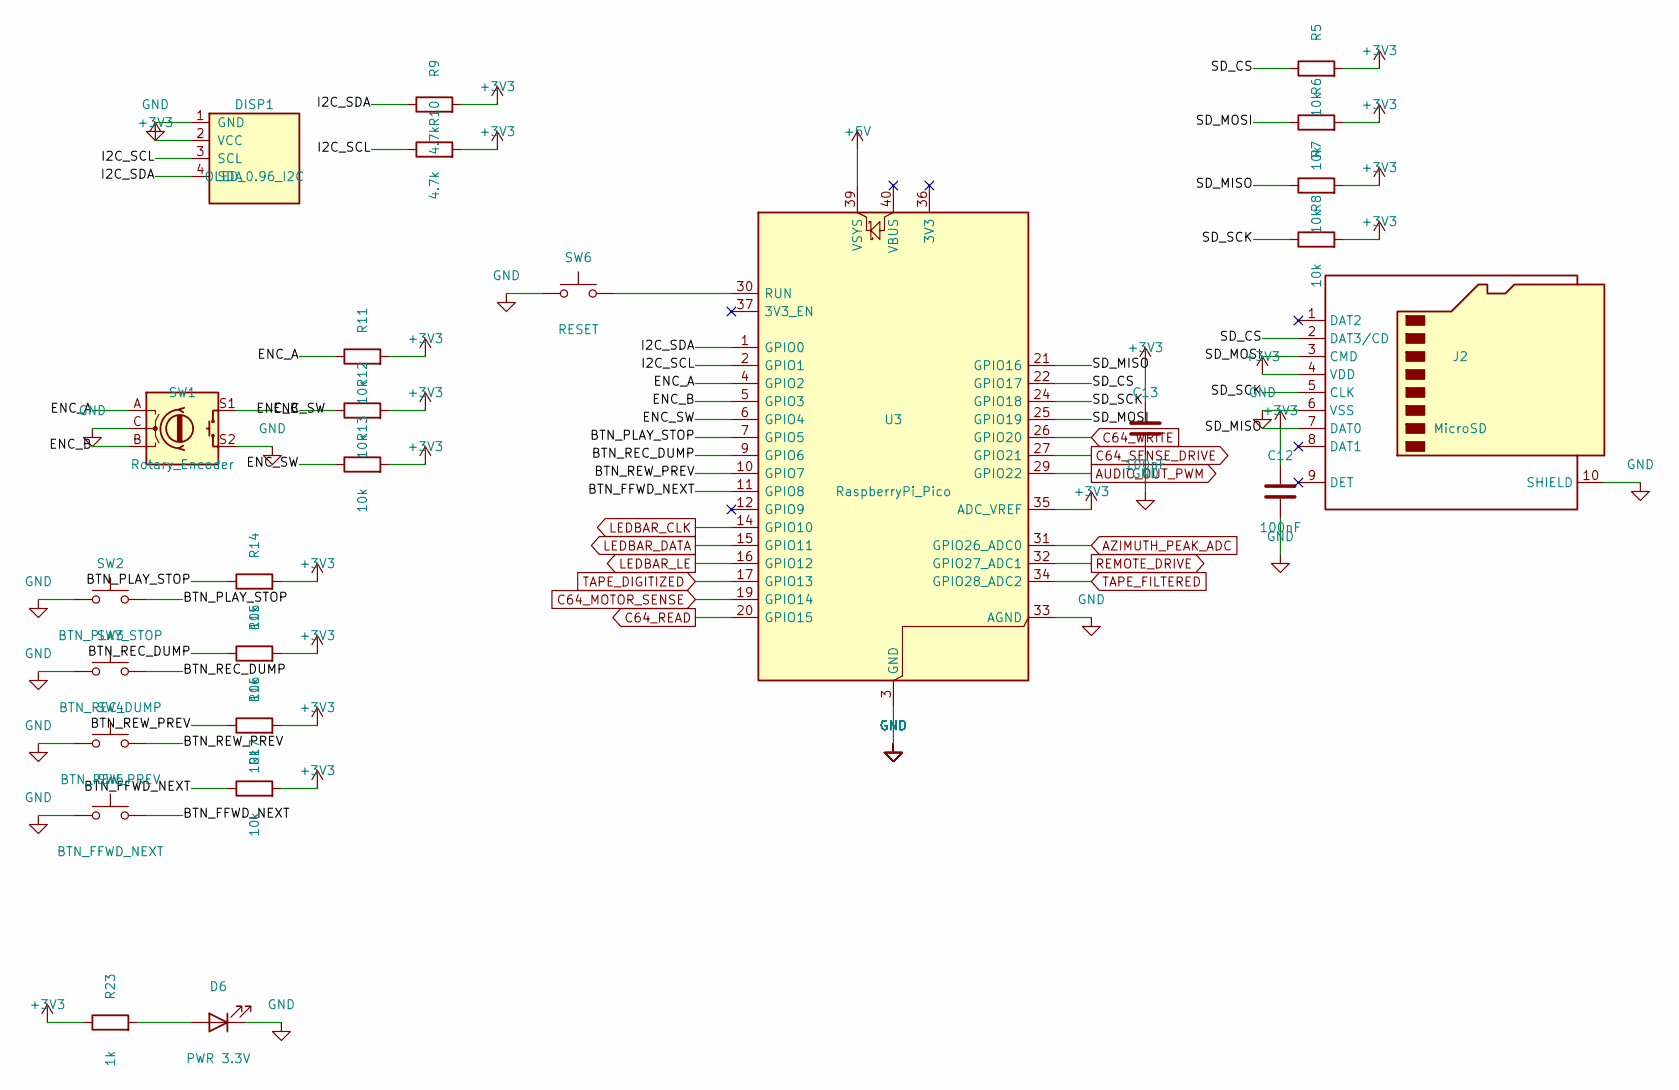
[picture p75: schematic 02_MCU_Core.kicad_sch, Microcontroller Core & User Interface]

Parts:
C12, C13: 100nF; C_0805_2012Metric
D6: PWR 3.3V; LED_0805_2012Metric
DISP1: OLED_0.96_I2C; PinHeader_1x04_P2.54mm_Vertical
J2: MicroSD; microSD_HC_Hirose_DM3D-SF
R5, R6, R7, R8, R11, R12, R13, R14, R15, R16, R17: 10k; R_0805_2012Metric
R9, R10: 4.7k; R_0805_2012Metric
R23: 1k; R_0805_2012Metric
SW1: Rotary_Encoder; RotaryEncoder_Alps_EC11E-Switch_Vertical_H20mm
SW2: BTN_PLAY_STOP; SW_PUSH_6mm
SW3: BTN_REC_DUMP; SW_PUSH_6mm
SW4: BTN_REW_PREV; SW_PUSH_6mm
SW5: BTN_FFWD_NEXT; SW_PUSH_6mm
SW6: RESET; SW_PUSH_6mm
U3: RaspberryPi_Pico; RaspberryPi_Pico_Common_THT

Connections:
/02_MCU_Core/BTN_FFWD_NEXT: R17.1, SW5.2, U3.11 (GPIO8)
/02_MCU_Core/BTN_PLAY_STOP: R14.1, SW2.2, U3.7 (GPIO5)
/02_MCU_Core/BTN_REC_DUMP: R15.1, SW3.2, U3.9 (GPIO6)
/02_MCU_Core/BTN_REW_PREV: R16.1, SW4.2, U3.10 (GPIO7)
/02_MCU_Core/ENC_A: R11.1, SW1.A, U3.4 (GPIO2)
/02_MCU_Core/ENC_B: R12.1, SW1.B, U3.5 (GPIO3)
/02_MCU_Core/ENC_SW: R13.1, SW1.S1, U3.6 (GPIO4)
/02_MCU_Core/I2C_SCL: DISP1.3 (SCL), R10.1, U3.2 (GPIO1)
/02_MCU_Core/I2C_SDA: DISP1.4 (SDA), R9.1, U3.1 (GPIO0)
/02_MCU_Core/SD_CS: J2.2 (DAT3/CD), R5.1, U3.22 (GPIO17)
/02_MCU_Core/SD_MOSI: J2.3 (CMD), R6.1, U3.25 (GPIO19)
/02_MCU_Core/SD_SCK: J2.5 (CLK), R8.1, U3.24 (GPIO18)
AUDIO_OUT_PWM: U3.29 (GPIO22); also elsewhere on the board
C64_MOTOR_SENSE: U3.19 (GPIO14); also elsewhere on the board
C64_READ: U3.20 (GPIO15); also elsewhere on the board
C64_SENSE_DRIVE: U3.27 (GPIO21); also elsewhere on the board
C64_WRITE: U3.26 (GPIO20); also elsewhere on the board
LEDBAR_CLK: U3.14 (GPIO10); also elsewhere on the board
LEDBAR_DATA: U3.15 (GPIO11); also elsewhere on the board
LEDBAR_LE: U3.16 (GPIO12); also elsewhere on the board
unnamed: D6.2 (A), R23.2
unnamed: SW6.2, U3.30 (RUN)
REMOTE_DRIVE: U3.32 (GPIO27_ADC1); also elsewhere on the board
TAPE_DIGITIZED: U3.17 (GPIO13); also elsewhere on the board
TAPE_FILTERED: U3.34 (GPIO28_ADC2); also elsewhere on the board

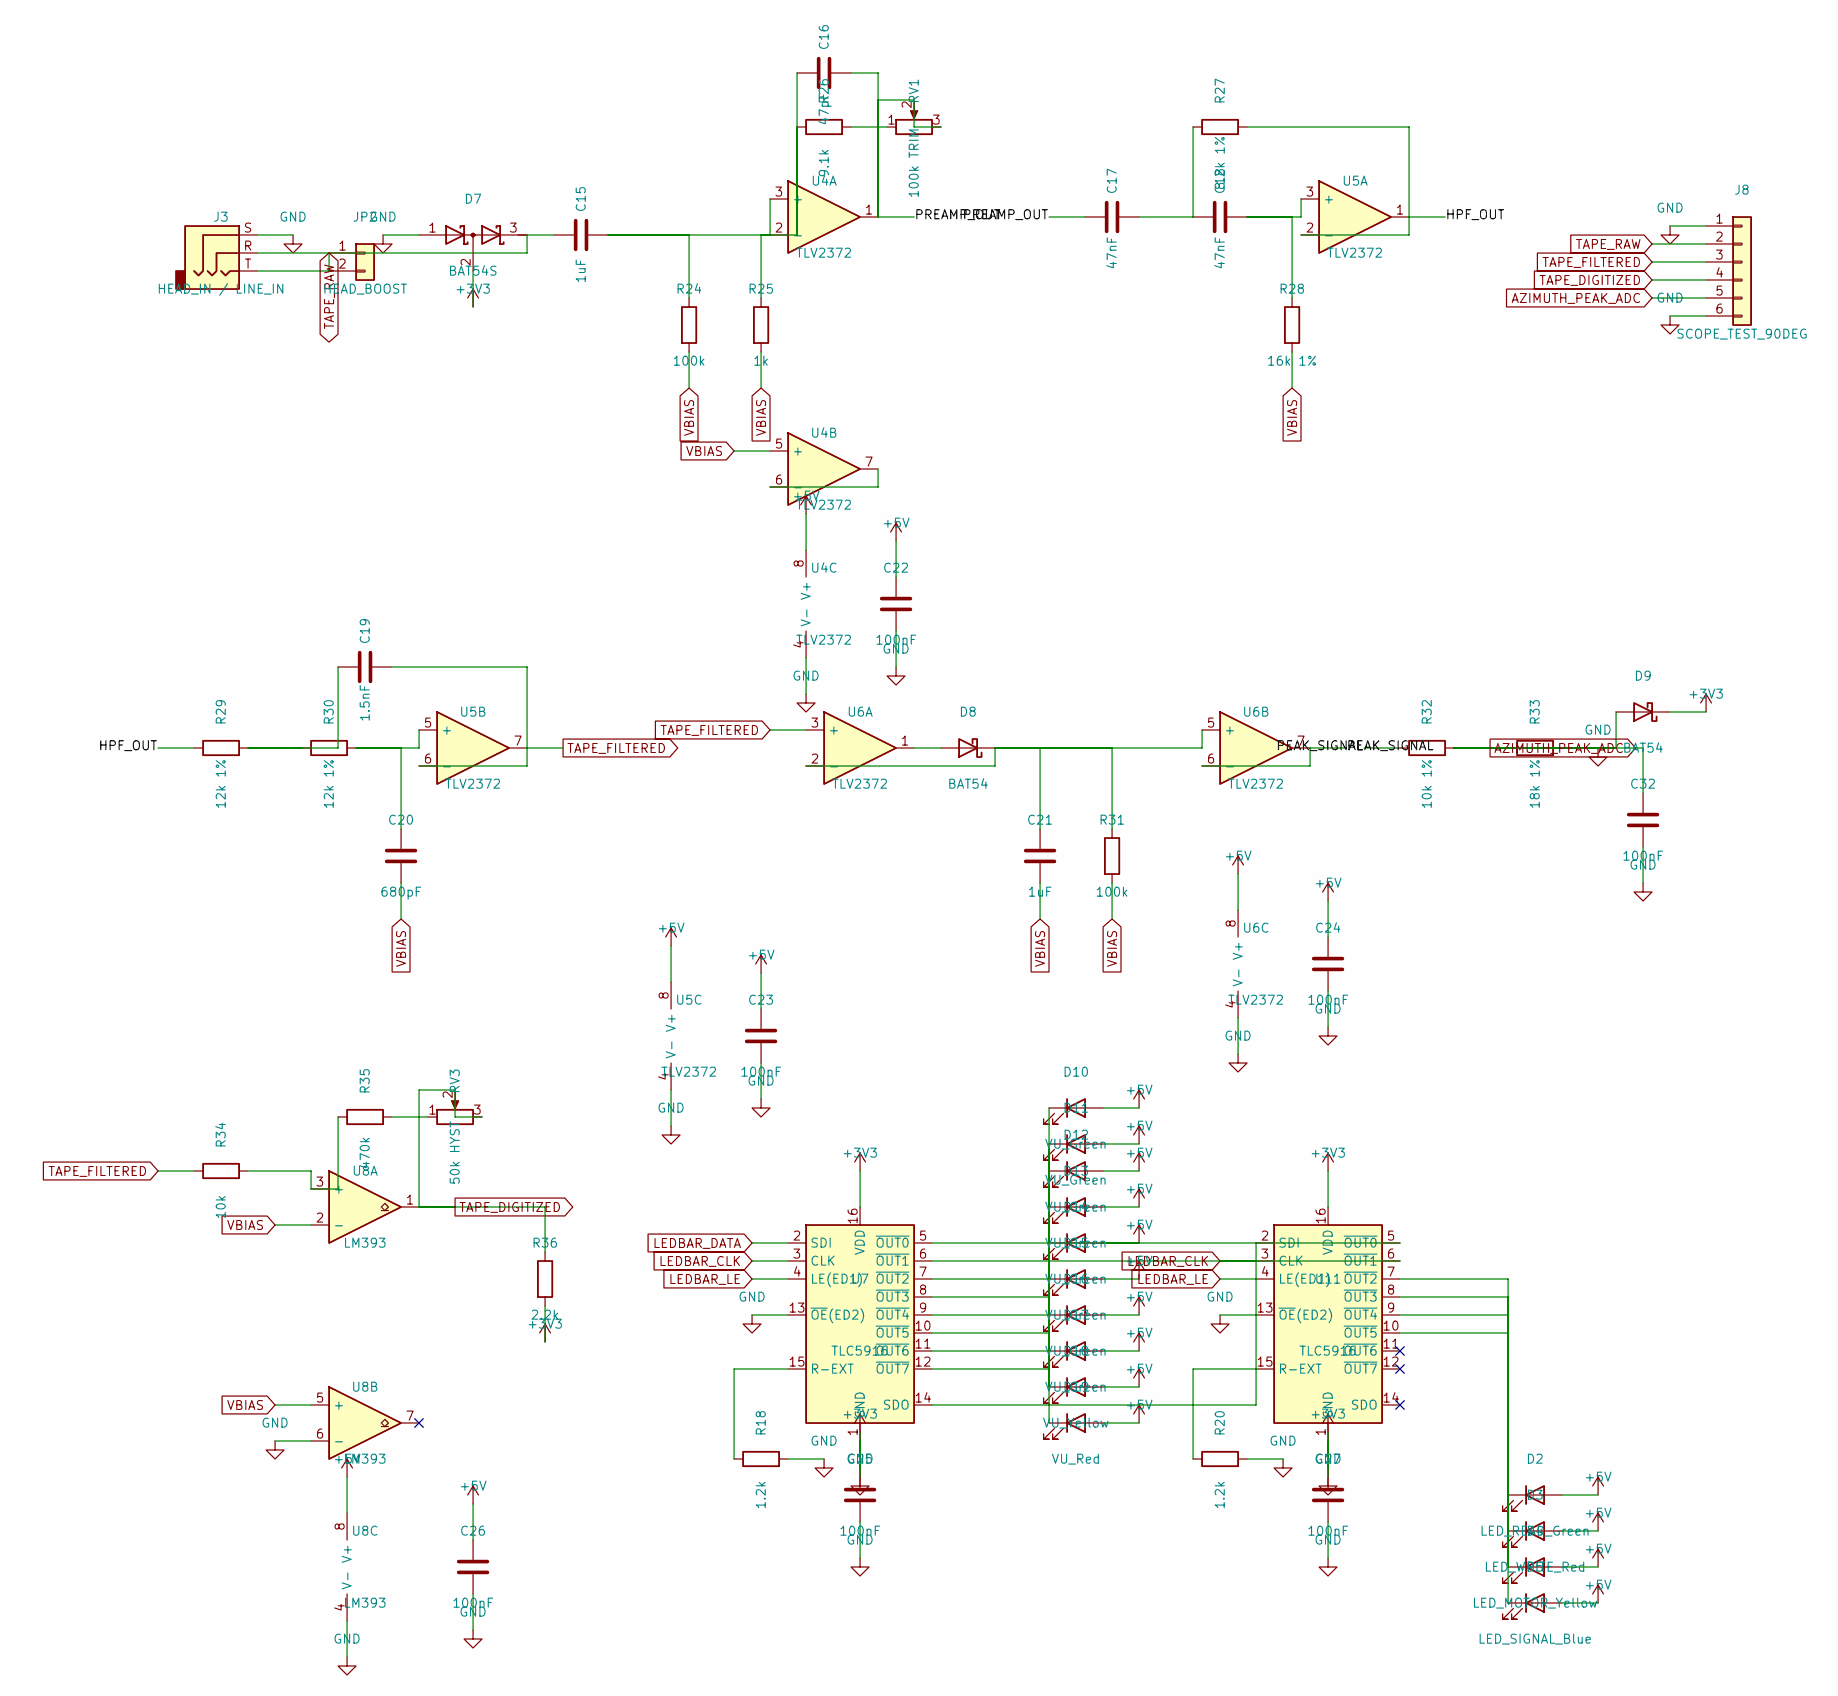
[picture p76: schematic 03_Analog_Ingest.kicad_sch, Analog Ingest, Active Sallen-Key Filter, Peak Detector & Di…]

Parts:
C15, C21: 1uF; C_0805_2012Metric
C16: 47pF; C_0805_2012Metric
C17, C18: 47nF; C_0805_2012Metric
C19: 1.5nF; C_0805_2012Metric
C20: 680pF; C_0805_2012Metric
C22, C23, C24, C25, C26, C27, C32: 100nF; C_0805_2012Metric
D2: LED_READ_Green; LED_0805_2012Metric
D3: LED_WRITE_Red; LED_0805_2012Metric
D4: LED_MOTOR_Yellow; LED_0805_2012Metric
D5: LED_SIGNAL_Blue; LED_0805_2012Metric
D7: BAT54S; SOT-23
D8, D9: BAT54; SOT-23
D10, D11, D12, D13, D14, D15, D16, D17: VU_Green; LED_0805_2012Metric
D18: VU_Yellow; LED_0805_2012Metric
D19: VU_Red; LED_0805_2012Metric
J3: HEAD_IN / LINE_IN; Jack_3.5mm_CUI_SJ-3523-SMT_Horizontal
J8: SCOPE_TEST_90DEG; PinHeader_1x06_P2.54mm_Horizontal
JP2: HEAD_BOOST; PinHeader_1x02_P2.54mm_Vertical
R18, R20: 1.2k; R_0805_2012Metric
R24, R31: 100k; R_0805_2012Metric
R25: 1k; R_0805_2012Metric
R26: 9.1k; R_0805_2012Metric
R27: 8.2k 1%; R_0805_2012Metric
R28: 16k 1%; R_0805_2012Metric
R29, R30: 12k 1%; R_0805_2012Metric
R32: 10k 1%; R_0805_2012Metric
R33: 18k 1%; R_0805_2012Metric
R34: 10k; R_0805_2012Metric
R35: 470k; R_0805_2012Metric
R36: 2.2k; R_0805_2012Metric
RV1: 100k TRIM; Potentiometer_Bourns_3296W_Vertical
RV3: 50k HYST; Potentiometer_Bourns_3296W_Vertical
U4, U5, U6: TLV2372; SOIC-8_3.9x4.9mm_P1.27mm
U7, U11: TLC5916; SOIC-16_3.9x9.9mm_P1.27mm
U8: LM393; SOIC-8_3.9x4.9mm_P1.27mm

Connections:
/03_Analog_Ingest/HPF_OUT: R27.2, R29.1, U5.1, U5.2 (-)
/03_Analog_Ingest/PEAK_SIGNAL: R32.1, U6.6 (-), U6.7
/03_Analog_Ingest/PREAMP_OUT: C16.2, C17.1, RV1.2, RV1.3, U4.1
LEDBAR_CLK: D11.1 (K), D19.1 (K), U7.3 (CLK), U7.6 (~OUT1), U11.3 (CLK), U11.6 (~OUT1); also elsewhere on the board
LEDBAR_DATA: U7.2 (SDI); also elsewhere on the board
LEDBAR_LE: U7.4 (LE(ED1)), U11.4 (LE(ED1)); also elsewhere on the board
unnamed: C17.2, C18.1, R27.1
unnamed: C19.1, R29.2, R30.1
unnamed: D2.1 (K), U11.7 (~OUT2)
unnamed: D3.1 (K), U11.8 (~OUT3)
unnamed: D4.1 (K), U11.9 (~OUT4)
unnamed: D5.1 (K), U11.10 (~OUT5)
unnamed: D8.2 (A), U6.1
unnamed: C21.1, D8.1 (K), R31.1, U6.2 (-), U6.5 (+)
unnamed: D12.1 (K), D15.1 (K), U7.7 (~OUT2), U7.10 (~OUT5)
unnamed: D13.1 (K), U7.8 (~OUT3)
unnamed: R26.2, RV1.1
unnamed: R35.2, RV3.1
unnamed: C15.2, C16.1, R24.1, R25.1, R26.1, U4.2 (-), U4.3 (+)
unnamed: U4.6 (-), U4.7
unnamed: C18.2, R28.1, U5.3 (+)
unnamed: C20.1, R30.2, U5.5 (+)
unnamed: R18.1, U7.15 (R-EXT)
unnamed: R34.2, R35.1, U8.3 (+)
unnamed: R20.1, U11.15 (R-EXT)
unnamed: U7.14 (SDO), U11.2 (SDI)
TAPE_DIGITIZED: J8.4, R36.1, RV3.2, RV3.3, U8.1; also elsewhere on the board
TAPE_FILTERED: C19.2, J8.3, R34.1, U5.6 (-), U5.7, U6.3 (+); also elsewhere on the board
TAPE_RAW: C15.1, D7.3 (K), J3.R, J3.T, J8.2, JP2.1, JP2.2
VBIAS: C20.2, C21.2, R24.2, R25.2, R28.2, R31.2, U4.5 (+), U8.2 (-), U8.5 (+); also elsewhere on the board

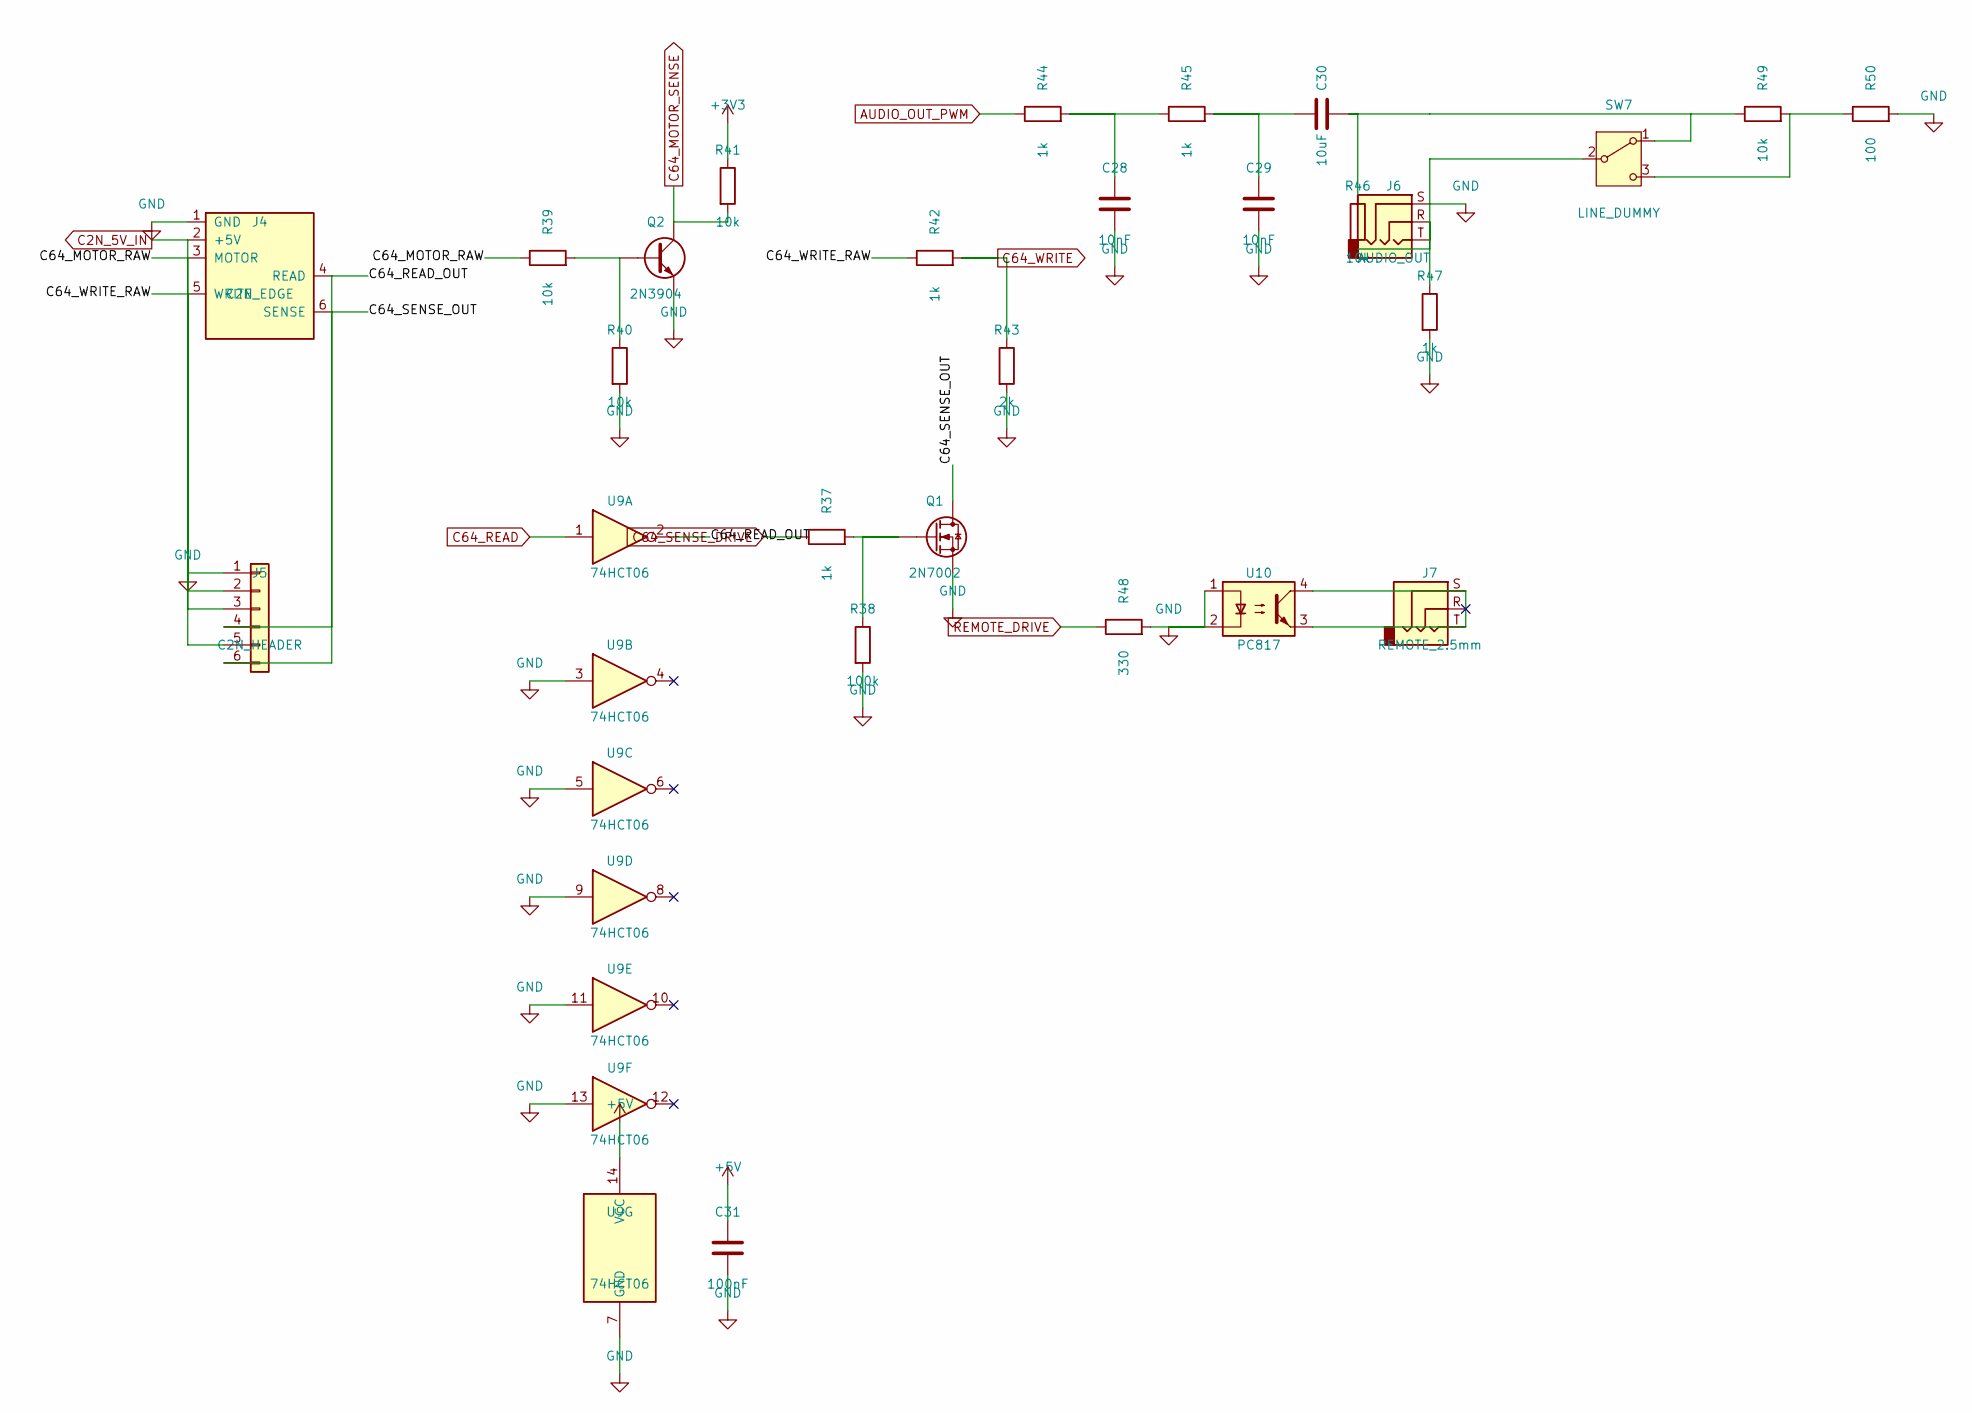
[picture p77: schematic 04_Tape_Interfaces.kicad_sch, Vintage Cassette Bus Interfaces & Remote Control]

Parts:
C28, C29: 10nF; C_0805_2012Metric
C30: 10uF; C_0805_2012Metric
C31: 100nF; C_0805_2012Metric
J4: C2N_EDGE; C2N_Edge_Connector
J5: C2N_HEADER; PinHeader_1x06_P2.54mm_Horizontal
J6: AUDIO_OUT; Jack_3.5mm_CUI_SJ-3523-SMT_Horizontal
J7: REMOTE_2.5mm; Jack_3.5mm_CUI_SJ-3523-SMT_Horizontal
Q1: 2N7002; SOT-23
Q2: 2N3904; SOT-23
R37, R42, R44, R45, R47: 1k; R_0805_2012Metric
R38: 100k; R_0805_2012Metric
R39, R40, R41, R46, R49: 10k; R_0805_2012Metric
R43: 2k; R_0805_2012Metric
R48: 330; R_0805_2012Metric
R50: 100; R_0805_2012Metric
SW7: LINE_DUMMY; SW_Slide_SPDT_Straight_CK_OS102011MS2Q
U9: 74HCT06; SOIC-14_3.9x8.7mm_P1.27mm
U10: PC817; DIP-4_W7.62mm

Connections:
/04_Tape_Interfaces/C64_READ_OUT: J4.4 (READ), J5.4, U9.2
/04_Tape_Interfaces/C64_SENSE_OUT: J4.6 (SENSE), J5.6, Q1.3 (D)
AUDIO_OUT_PWM: R44.1; also elsewhere on the board
C64_MOTOR_SENSE: Q2.3 (C), R41.2; also elsewhere on the board
C64_READ: U9.1; also elsewhere on the board
C64_SENSE_DRIVE: R37.1; also elsewhere on the board
C64_WRITE: R42.2, R43.1; also elsewhere on the board
unnamed: C28.1, R44.2, R45.1
unnamed: C29.1, C30.1, R45.2
unnamed: J6.R, R46.2, R47.1
unnamed: J7.S, J7.T, U10.3, U10.4
unnamed: Q1.1 (G), R37.2, R38.1
unnamed: Q2.1 (B), R39.2, R40.1
unnamed: C30.2, R46.1, R49.1, SW7.1 (A)
unnamed: J6.T, SW7.2 (B)
unnamed: R49.2, R50.1, SW7.3 (C)
REMOTE_DRIVE: R48.1; also elsewhere on the board

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
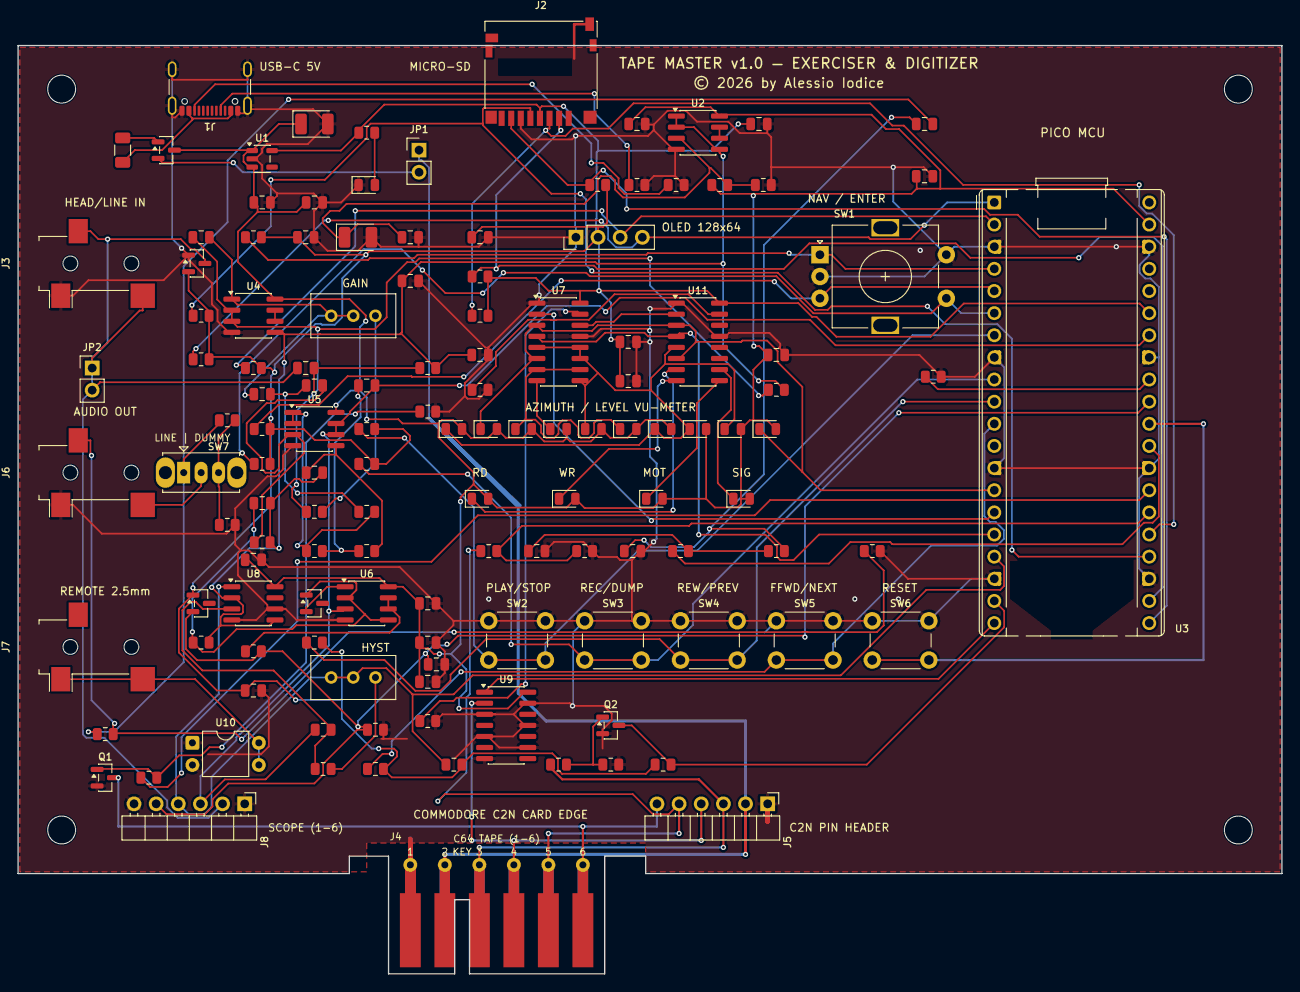
[picture p78: board Tape-Master.kicad_pcb from above]

Board: 2 copper layers, 145.0 x 106.5 mm, 135 parts (0 on the bottom side), 77 nets.
