lucedoriente/Tape_Master/scripts/read_layout2.py

with open(r"C:\Users\aless\OneDrive\temp\Manutenzione\Kicad_Project\Tape_Master\scripts\build_pcb_layout_120x90.py", "r", encoding="utf-8") as f:
    lines = f.readlines()
    print("".join(lines[50:120]))
