lucedoriente/Tape_Master/(commit log)

2026-11-06 feat: initial commit Tape Master Exerciser v2 architecture (Mainboard & UI Panel)
    [01_Power_Supply.kicad_sch, 02_MCU_Core.kicad_sch, 03_Analog_Ingest.kicad_sch, 04_Tape_Interfaces.kicad_sch, C2N_Edge_Connector.step, EC11_Encoder.step, OLED_0.96_I2C.step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]
2026-11-06 fix(mainboard): flush connector alignment, rear-facing cartridge slot, reset routing to ui panel and 0 DRC/0 ERC sign-off
    [Tape_Master_Mainboard.kicad_pcb, Tape_Master_Mainboard.kicad_sch, Tape_Master_Mainboard.step, Tape_Master_UI_Panel.kicad_pcb, Tape_Master_UI_Panel.step]
2026-11-07 feat(v2.0): Tape Master v2.0 - Hardware Ecosystem (Mainboard, UI Panel, 13 Cartridges) & Dual-Core RP2040 Firmware
    [Atari_SIO_13P.step, DIN-5_180_Horizontal_CUI_SDS-50J.step, DIN-7_270_Horizontal_CUI_SDS-70J.step, DIN-8_270_Horizontal_CUI_SDS-80J.step, Jack_3.5mm_CUI_SJ1-3533NG_Horizontal.step, Mini-DIN-8_MD-80_Horizontal.step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]
2026-11-07 fix(firmware): add PIO c-sdk init helpers, fix parser signatures and link hardware_clocks
    [virtual_deck.c]
2026-11-07 fix(drivers): define CMD1 in sd_card and include strings.h for portability
    [fat_fs.c, sd_card.c, virtual_deck.c]
2026-11-07 fix(engine): resolve undefined symbols motor_is_active, motor_set_control and analog_read_azimuth_level
    [exerciser_engine.c, signal_digitizer.c, virtual_deck.c]
2026-11-07 ci: add GitHub Actions workflow for Tape Master Studio Windows .exe and track PyInstaller spec
