lucedoriente/Tape_Master/(notices)

Notices in the files:
kicad/v1/temp_clean_for_dsn.kicad_pcb:
© 2026 by Alessio Iodice — MuDIsTInf Padova
